GlobalVent/electronics/Pressure_sensor_daughterboard-MS5607-MS5803/Pressure_sensor_daughterboard-MS5607-MS5803.png

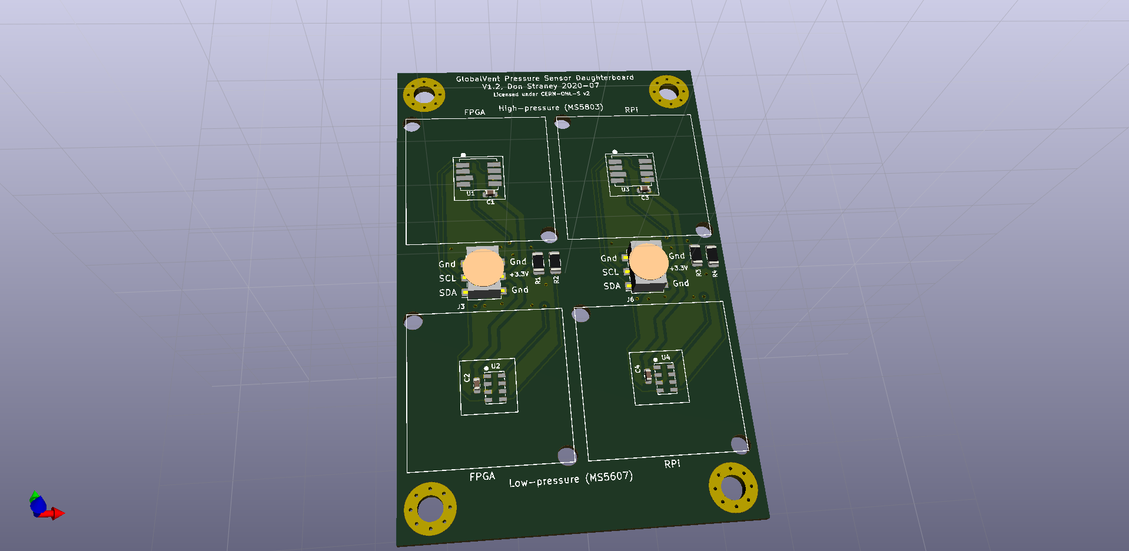
Pressure_sensor_daughterboard-MS5607-MS5803/Pressure_sensor_daughterboard-MS5607-MS5803.png
