GlobalVent/electronics/Pressure_sensor_daughterboard-MS5607-MS5803/manufacturing/README.txt

2 layers, 1.6 mm (0.062") thickness, LPI soldermask and silkscreen both sides
Outer layers 1 oz copper
ENIG plating on pads
Overall dimensions 54 x 81.25 mm (2.126" x 3.199")
Min. trace/spacing 0.18 mm (0.007")
Min. hole size 0.26 mm (0.010")

All copper layers positive
*-F_Cu.gbr: Top copper (signal)
*-B_Cu.gbr: Bottom copper (plane)
*-F_Mask.gbr: Top soldermask
*-B_Mask.gbr: Bottom soldermask
*-F_SilkS.gbr: Top silkscreen
*-B_SilkS.gbr: Bottom silkscreen
*-Edge_Cuts.gbr: Board outline
*-F_Paste.gbr: Top solder paste
*-PTH.drl: Drill file (plated holes)
*-NPTH.drl: Drill file (non-plated holes)

*-PTH-drl_map.pdf: Drill map (plated holes)
*-NPTH-drl_map.pdf: Drill map (non-plated holes)
fab.pdf: Fabrication drawing (excluding drills)

*.pos: Pick-and-place centroid position file
assy top.pdf: Assembly drawing (top side)
BOM.xls: Bill of materials
