GlobalVent/electronics/RPi_cape/0 parts, CPU options.txt

Particularly available models (>1K from multiple distributors) include...
STM32L051K8U6
STM32F100RCT6B
STM32F103RBT6
STM32F103T8U6
STM32F103T4U6A
STM32F103ZCT6
STM32F105VCT6TR
STM32L151R8T6
STM32F205ZGT6
STM32F373VCT6
STM32F401RBT6
STM32F429VIT6
