GlobalVent/electronics/RPi_cape/0 parts, display options.ods

Mfg. | Part Number | Qty. | Size | Interface
Sharp | LQ104V1DG81 | 336 Digikey | 7” 800x480 | 18-bit RGB
Matrix Orbital | MOP-TFT800480-70A-BLM-TPR | 287 | 7” 800x480 | 24-bit RGB, 40-pin almost-compatible with Newhaven
Matrix Orbital | MOP-TFT800480-70A-BLM-TPC | 496 | 7” 800x480 | 24-bit RGB, 40-pin almost-compatible with Newhaven; cap touch connector completely different
Newhaven Display Intl | NHD-7.0-800480MB-ASXN | 136 | 7” 800x480 | 24-bit RGB, 40-pin Newhaven standard
Newhaven Display Intl | NHD-7.0-800480MB-ASXN-CTP | 135 | 7” 800x480 | 24-bit RGB, 40-pin Newhaven standard
Newhaven Display Intl | NHD-7.0-800480EF-ATXL# | 220 | 7” 800x480 | 24-bit RGB, 40-pin Newhaven standard
Newhaven Display Intl | NHD-7.0-800480EF-ASXV#-CTP | 135 | 7” 800x480 | 24-bit RGB, 40-pin Newhaven standard
Newhaven Display Intl | NHD-7.0-800480EF-ATXL#-CTP | 256 | 7” 800x480 | 24-bit RGB, 40-pin Newhaven standard
Newhaven Display Intl | NHD-7.0-800480MB-ATXL-CTP | 475 | 7” 800x480 | 24-bit RGB, 40-pin Newhaven standard
4D Systems Pty Ltd | GEN4-ULCD-70DCT-CLB | 162 Digikey | 7” 800x480 | CPU w/GPIO (expected to run user code)
Newhaven Display Intl | NHD-10.1-HDMI-A-RSXV-CTU | 136 Digikey | 10.1” 1024x600 | HDMI
Newhaven Display Intl | NHD-7.0-HDMI-HR-RSXP | 134 Digikey | 7” 1024x600 | HDMI
Matrix Orbital | HTT70A-TPC-BLM-B0-H5-CH-V5 | 120 Digikey | 7” 800x480 | HDMI
Newhaven Display Intl | NHD-7.0-HDMI-N-RTXL | 134 Digikey | 7” 800x480 | HDMI
Newhaven Display Intl | NHD-7.0-1024600AF-LSXP | 162 Digikey | 7” 1024x600 | LVDS
Kyocera | T-55786GD084J-LW-AGN | 108 Digikey | 8.4” 800x600 | LVDS
Sharp | LQ084S3LG03 | 123 Digikey | 8.4” 800x600 | LVDS
Newhaven Display Intl | NHD-7.0-800480WF-CTXI# | 146 Digikey; non-stocking | 7” 800x480
