GlobalVent/electronics/RPi_cape_proto/RPi_cape_proto_bom.xls

# | Qty | References | Value | Footprint | Part Number | Manufacturer | Have?
1 | 1 | BT1 | 4x AA | Connector_Spring_Phoenix_1985195 | 9185195 | Phoenix Contact | N
2 | 6 | C8,C10,C55,C64,C66-C67 | 100nF 50V X7R | C_0603_1608Metric | 06035C104JAT2A | AVX | N
3 | 1 | C114 | 100pF 50V NP0 | C_0603_1608Metric | C0603C101J5GACTU | Kemet | Y
4 | 8 | C2,C15-C19,C62,C112 | 100uF 50V AlPoly | CP_Elec_10x10.5 | EEH-ZC1H101P | Panasonic | N
5 | 9 | C5,C29-C30,C41,C44-C45,C49,C69,C84 | 10nF 50V NP0 | C_0603_1608Metric | GRM1885C1H103JA01D | Murata | N
6 | 2 | C3,C65 | 10uF 50V X7S | C_1210_3225Metric | GCM32EC71H106KA03L | Murata | Y
7 | 4 | C40,C43,C50,C113 | 1nF 50V NP0 | C_0603_1608Metric | 06035A102JAT2A | AVX | N
8 | 11 | C7,C9,C28,C42,C48,C51-C54,C56,C68 | 1uF 16V X7R | C_0805_2012Metric | C0805C105K4RACTU | Kemet | Y
9 | 1 | D1 | STPS15H100CB | TO-252-2 | STPS15H100CB | ST | N
10 | 1 | D52 | 3.3V | D_SOD-123 | MMSZ4684T1G | ON Semiconductor | N
11 | 4 | D16,D25,D30,D35 | 30V | D_SMA | SMAJ30A-E3/61 | Vishay | N
12 | 4 | D13,D19-D20,D22 | BAS21AH | D_SOD-323 | BAS21AHT1G | ON Semiconductor | N
13 | 6 | D15,D24,D29,D34,D42-D43 | ES2B | D_SMA | ES2G-E3/52T | Vishay | N
14 | 9 | D4-D7,D9,D12,D21,D26,D31 | Orange | LED_0805_2012Metric | HSMD-C170 | Broadcom | N
15 | 1 | F3 | 140mA 60V | Fuse_1812_4532Metric | 0ZCG0014FF2C | Bel Fuse | N
16 | 4 | F10-F13 | 1A 63VDC | Fuse_1206_3216Metric | SF-1206FP100-2 | Bourns | N
17 | 1 | F2 | 50mA 15V | Fuse_0603_1608Metric | 0ZCM0005FF2G | Bel Fuse | N
18 | 8 | J3-J4,J7,J9-J12,J14 | Conn_01x02 | Connector_Spring_Phoenix_1985195 | 1985195 | Phoenix Contact | N
19 | 1 | J1 | Conn_01x04 | Connector_Spring_Phoenix_1985218 | 1985218 | Phoenix Contact | N
20 | 1 | J15 | Conn_01x06 | TE_188275-6 | 188275-6 | TE AMP | N
21 | 1 | J16 | Conn_01x06 | PinSocket_1x06_P2.54mm_Vertical |  |  | N
22 | 1 | J21 | Conn_01x06 | TE_215079-6 | 215079-6 | TE AMP | N
23 | 3 | J2,J5,J8 | Conn_02x20_Odd_Even | PinSocket_2x20_P2.54mm_Vertical | PPPC202LFBN-RC | Sullins | N
24 | 5 | Q1-Q3,Q11,Q13 | MMBT3904 | SOT-23 | MMBT3904-7-F | Diodes Inc. | Y
25 | 1 | Q12 | MMBT3906 | SOT-23 | MMBT3906,215 | Nexperia | Y
26 | 2 | R4,R178 | 0 | R_1206_3216Metric | ERJ-8GEY0R00V | Panasonic | Y
27 | 1 | R5 | 1 | R_1206_3216Metric | ERJ-8RQF1R0V | Panasonic | N
28 | 9 | R29,R56,R109-R110,R116,R119,R123,R209,R214 | 1.5K | R_1206_3216Metric | RK73H2BTTD1501F | KOA Speer | N
29 | 2 | R16,R18 | 10 | R_1206_3216Metric | RK73H2BTTD10R0F | KOA Speer | N
30 | 3 | R88-R89,R218 | 100 | R_1206_3216Metric | RK73H2BTTD1000F | KOA Speer | Y
31 | 5 | R148-R150,R217,R222 | 100K | R_1206_3216Metric | RK73H2BTTD1003F | KOA Speer | Y
32 | 28 | R1-R2,R8,R19,R53,R59,R84,R86-R87, R90-R91,R106,R113,R118,R120,R183-R184,R187-R188 R191-R192,R195-R197,R208,R213,R224-R225 | 10K | R_1206_3216Metric | RK73H2BTTD1002F | KOA Speer | Y
33 | 9 | R9,R92-R93,R198-R201,R216,R223 | 1K | R_1206_3216Metric | RK73H2BTTD1001F | KOA Speer | Y
34 | 3 | R219-R220,R236 | 1M | R_1206_3216Metric | RK73H2BTTD1004F | KOA Speer | N
35 | 5 | R111,R124,R190,R210,R215 | 2.4K | R_1206_3216Metric | RK73H2BTTD2401F | KOA Speer | N
36 | 2 | R20,R151 | 24.9K | R_1206_3216Metric | RK73H2BTTD2492F | KOA Speer | N
37 | 7 | R3,R6,R14-R15,R17,R193-R194 | 3.3K | R_1206_3216Metric | RK73H2BTTD3301F | KOA Speer | Y
38 | 14 | TP1,TP3-TP4,TP6-TP10,TP13,TP15,TP20,TP39-TP41 | TestPoint_Flag | TestPoint_Keystone_5019_Minature | 5019 | Keystone | Y
39 | 4 | U8,U18,U20,U22 | 74LVC1G08 | SOT-23-5 | SN74LVC1G08DBVR | Texas Instruments | N
40 | 1 | U4 | AD8552A | SOIC-8_3.9x4.9mm_P1.27mm | AD8552ARZ-REEL | Analog Devices | N
41 | 2 | U2-U3 | ADC128D818 | TSSOP-16_4.4x5mm_P0.65mm | ADC128D818CIMTX/NOPB | Texas Instruments | N
42 | 1 | U28 | LM4871M | SOIC-8_3.9x4.9mm_P1.27mm | LM4871MX/NOPB | Texas Instruments | Y
43 | 3 | U36-U38 | LMC7101B | SOT-23-5 | LMC7101BIM5/NOPB | Texas Instruments | N
44 | 4 | U9,U19,U21,U23 | TPS1H100B | TSSOP-14-1EP_4.4x5mm_P0.65mm | TPS1H100BQPWPRQ1 | Texas Instruments | N
