GlobalVent/electronics/Pressure_sensor_daughterboard-MS5607-MS5803/manufacturing/BOM.xls

Line # | Quantity Per PCB | References | Value | Footprint | Manufacturer | Part Number | DNI
1 | 4 | C1-C4 | 100nF 50V X7R | C_0603_1608Metric | AVX | 06035C104JAT2A
2 | 2 | J3,J6 | Conn_02x03_Odd_Even | Samtec_HLE-103-02-xxx-DV-BE_2x03_P2.54mm_Horizontal | Samtec | HLE-103-02-L-DV-BE-K-TR
3 | 4 | R1-R4 | 0 | R_1206_3216Metric | Panasonic | ERJ-8GEY0R00V
4 | 2 | U2,U4 | MS5607-02BA03 | TE_MS5607-02BA03 | TE Connectivity | MS560702BA03-50
5 | 2 | U1,U3 | MS5803-05BA | TE_MS5803-05BA | TE Connectivity | MS5803-05BA01-00
