GlobalVent/electronics/RPi_cape/0 pinouts for software.ods

Sheet: Raspberry Pi
Pin # (Header) | Pin Name | Net Name | Type | Description
3 | I2C_SDA | RPi_SDA | Bidir | I2C bus to ADC and digital pressure sensors
5 | I2C_SCL | RPi_SCL | Bidir
7 | GPIO4 | GPIO4 | Input | Active-low interrupt signal from ADC
8 | GPIO14 | Comms1 | Bidir | General-purpose bidirectional comms to CPLD
10 | GPIO15 | Comms2 | Bidir | General-purpose bidirectional comms to CPLD
11 | GPIO17 | RPi_Alarm_Spkr | Output | Output to audio amp driving alarm speaker; can generate frequencies on this pin to create square wave audio. Output is AC-coupled; can idle high or low.
12 | GPIO18 | RPi_PWM1 | Output | Drives 159 Hz LPF + testpoint for development/debug analog output
13
15
16 | GPIO23 | Comms3 | Bidir | General-purpose bidirectional comms to CPLD
18 | GPIO24 | Comms4 | Bidir | General-purpose bidirectional comms to CPLD
19
21
22 | GPIO25 | Comms5 | Bidir | General-purpose bidirectional comms to CPLD
23 | GPIO11 | Comms6 | Bidir | General-purpose bidirectional comms to CPLD
24
26
27
28
29
31
32 | GPIO12 | RPi_valve4 | Output | Active-high valve power enable to output #4 (intended for expiratory valve: SolV3 in pneumatics BOM)
33 | GPIO13 | RPi_PWM2 | Output | Drives 159 Hz LPF + testpoint for development/debug analog output
35 | GPIO19 | RPi_PWM3 | Output | Drives 159 Hz LPF + testpoint for development/debug analog output
36 | GPIO16 | RPi_valve3 | Output | Active-high valve power enable to output #3
37 | GPIO26 | RPi_PWM4 | Output | Drives 159 Hz LPF + testpoint for development/debug analog output
38 | GPIO20 | RPi_valve2 | Output | Active-high valve power enable to output #2
40 | GPIO21 | RPi_valve1 | Output | Active-high valve power enable to output #1

Sheet: FPGA
Net Name | Pin # (E144 package) | Type | Description
~Bat_On | 106 | Input | High when CPLD and alarms are powered from 24V input power, low when powered from alarm backup battery
Low_Bat | 102 | Input | High when alarm backup battery is below “low battery” threshold voltage
~+5VA_On | 101 | Input | Low when +5VA rail (supply for O2, pressure sensor analog inputs) is above ~3.5-4.2V “on” threshold
RPi_En | 62 | Output | Active high enable signal to Raspberry Pi’s 5V supply, set low to power down Raspberry Pi – only has an effect when using onboard (as opposed to external) 5V supplies
CPLD_Clk | 27 (CLK0P) | Input | 100 kHz clock
Alarm_Spkr | 111 | Output | Drives audio amp for alarm speaker output; output a frequency to create square-wave audio tone; AC-coupled, can idle low or high
Valve1 | 78 | Output | Active-high valve power enable to output #1
Valve2 | 77 | Output | Active-high valve power enable to output #2
Valve3 | 76 | Output | Active-high valve power enable to output #3
Valve4 | 75 | Output | Active-high valve power enable to output #4 (intended for expiratory valve: SolV3 in pneumatics BOM)
RPi_valve1 | 47 | Input | Raspberry Pi’s active-high valve command to output #1
RPi_valve2 | 46 | Input | Raspberry Pi’s active-high valve command to output #2
RPi_valve3 | 45 | Input | Raspberry Pi’s active-high valve command to output #3
RPi_valve4 | 44 | Input | Raspberry Pi’s active-high valve command to output #4
~Valve1_Fault | 119 | Input | Active-low fault input (over-current, shorted or open coil) from valve output #1 – only used if alternate TPS1H100A valve driver populated
~Valve2_Fault | 120 | Input | Active-low fault input (over-current, shorted or open coil) from valve output #1 – only used if alternate TPS1H100A valve driver populated
~Valve3_Fault | 123 | Input | Active-low fault input (over-current, shorted or open coil) from valve output #1 – only used if alternate TPS1H100A valve driver populated
~Valve4_Fault | 124 | Input (Schmitt trigger) | Default configuration: output #4 (expiration valve, SolV3) motion detect – low when valve current dips Alternate TPS1H100A valve driver populated: Active-low fault input (over-current, shorted or open coil) from valve output #4
Comms1 | 56 | Either | General-purpose bidirectional comms to Raspberry Pi
Comms2 | 57 | Either | General-purpose bidirectional comms to Raspberry Pi
Comms3 | 58 | Either | General-purpose bidirectional comms to Raspberry Pi
Comms4 | 59 | Either | General-purpose bidirectional comms to Raspberry Pi
Comms5 | 60 | Either | General-purpose bidirectional comms to Raspberry Pi
Comms6 | 61 | Either | General-purpose bidirectional comms to Raspberry Pi
SDA | 132 | Bidir | I2C to ADC and digital pressure sensors
SCL | 131 | Bidir | I2C to ADC and digital pressure sensors: set high to activate SCL pull-down
~ADC_Int | 130 | Input | Active-low interrupt from ADC
Pressure1_Lim_L_Alarm | 7 | Input | High when analog pressure sensor 1 value is below a hard-wired low limit
Pressure1_Lim_H_Alarm | 6 | Input | High when analog pressure sensor 1 value is above a hard-wired high limit
Pressure2_Lim_L_Alarm | 10 | Input | High when analog pressure sensor 2 value is below a hard-wired low limit
Pressure2_Lim_H_Alarm | 8 | Input | High when analog pressure sensor 2 value is above a hard-wired high limit
O2_Lim_L_Alarm | 12 | Input | High when O2 sensor value is below a hard-wired low limit
O2_Lim_H_Alarm | 11 | Input | High when O2 sensor value is above a hard-wired high limit
Enc_A | 87 | Input (Schmitt trigger) | Rotary encoder’s quadrature input A
Enc_B | 86 | Input (Schmitt trigger) | Rotary encoder’s quadrature input B
Enc_Sw | 79 | Input (Schmitt trigger) | Rotary encoder’s active-high switch input
Extra1 | 100 | Output | Drives LED and testpoint for development/debug
Extra2 | 99 | Output | Drives LED and testpoint for development/debug
Extra3 | 98 | Output | Drives LED and testpoint for development/debug
Extra4 | 90 | Output | Drives LED and testpoint for development/debug
Extra5 | 89 | Output | Drives LED and testpoint for development/debug
Extra6 | 88 | Output | Drives LED and testpoint for development/debug

Sheet: I2C
ADC: TI ADC128D818
Raspberry Pi | CPLD
Address: 0011101 (1Dh)
All inputs single-ended, need to use 2.56V internal reference
Channel 0: analog pressure sensor 1 (10V sensor = 2.537V ADC) | (same)
Channel 1: analog pressure sensor 2 (10V sensor = 2.537V ADC) | (same)
Channel 2: O2 sensor (13 mV sensor = 1.313V ADC) | (same)
 | Channel 3: Valve #1 current (1A = 3V) in default config
 | Channel 4: Valve #2 current (1A = 3V) in default config
 | Channel 5: Valve #3 current (1A = 3V) in default config
 | Channel 6: Valve #4 current (1A = 3V) in default config
 | Channel 7: +24V monitor (24V power = 2.182V ADC)
Pressure sensor: TE MS5803-05BA
Address: 1110111 (77h)
Pressure sensor: Bosch BMP388
Address: 1110110 (76h)
