GlobalVent/electronics/RPi_cape/0 power.xls

Rail |  |  | Current (A) | Description | Total power (W):
+24V |  |  | 2.088 |  | 50.11
2x low-power valves |  |  | 0.583
2x high-power valves |  |  | 0.833
4x valve drivers |  |  | 0.020 | TPS1H100B
+24VA |  |  | 0.02
+5V supply |  |  | 0.032 | LMZ14203 @ 86% eff. for 0.1A out
+5VD supply |  |  | 0.599 | LMZ14203 @ 88% eff. for 2.5A out
 | +24VA |  | 0.02
 | Pressure sensors (0-10V) |  | 0.02 | PXM309-10V
+5V |  |  | 0.131
+5VA |  |  | 0.015
BATT+ |  |  | 0.116
 | +5VA |  | 0.015
 | 2.5V reference bias |  | 0.005
 | Pressure sensor (0-10V) buffers |  | 0.005 | LMC7101
 | O2 sensor amplifiers |  | 0.002 | AD8552
 | Analog sensor limit comparators |  | 0.003 | LM2903
 | BATT+ |  | 0.116
 | Audio amp, quiescent |  | 0.01 | LM4871M
 | Audio amp at reasonable volume |  | 0.04 | Tested with 8-ohm speaker and 260 Hz 0-5V square wave input from alarm
 | 2.5V reference bias |  | 0.003
 | Low-battery comparator |  | 0.001 | LM2903
 | +3.3V regulator |  | 0.022
 | +1.8V regulator |  | 0.040
 |  | +3.3V | 0.022
 |  | I2C pull-ups | 0.002
 |  | ADC | 0.002 | ADC128D818
 |  | Logic gates (safety-combining) | 0.001
 |  | Valve driver pull-downs | 0.004 | Not active during backup-battery-power mode
 |  | Valve driver LEDs | 0.004 | Not active during backup-battery-power mode
 |  | CPLD debug LEDs | 0.006
 |  | CPLD clock | 0.001 | MIC1557
 |  | Encoder pull-ups | 0.002
 |  | Pressure sensors, digital | 0.002 | MS5803-05BA, BMP388
 |  | +1.8V | 0.040
 |  | FPGA | 0.04 | Max V current draw during configuration
+5VD |  |  | 2.532
Raspberry Pi |  |  | 2 | Estimate from official guidelines (2.5A recommended for peripherals ≤ 0.5A)
Display |  |  | 0.5 | Estimate from official guidelines
Encoder |  |  | 0.03 | Grayhill
ADC |  |  | 0.002 | ADC128D818
