GlobalVent/electronics/RPi_cape/0 parts, CPLD-FPGA options.ods

Mfg | Part Number | Cells | Availability
Intel | EP3C5E144C8N | 5136 | 1.6k
Intel | EP3C10E144C8N | 10320 | 2k
Intel | EP3C16Q240C8N | 15408 | 1.9k
Intel | EP4CE6E22C8N | 6272 | 3.3k
Lattice | ICE5LP2K-SG48ITR | 2048 | 3.4k
Lattice | ICE40UP5K-SG48I | 5280 | 6k
Lattice | LFXP2-5E-5TN144I | 5000 | 1.1k
Intel | 10M02SCE144I7G | 2000 | 2.6k | Too small?
Intel | 10M02SCE144C8G | 2000 | 2.9k | Too small?
Intel | 10M04SCE144C8G | 4000 | 2.5k
Intel | 10M08SAE144I7G | 8000 | 900
Intel | 10M08SAE144C8G | 8000 | 2.2k
Intel | 10M25SAE144C8G | 25000 | 942
Microsemi | A3P250-VQG100 | 250k gates | 6.8k, extra 400 for I version
Xilinx | XC6SLX9-2TQG144C | 9152 | 3.2k Digikey
