GlobalVent/electronics/RPi_cape/0 protection and bringup.ods

Sheet: Failure mode tests
Failure mode | Mitigation | Expected result | Testing
Analog inputs
ESD | Series resistor for current-limiting, capacitor for charge absorbing | Reading shift for unknown time, no damage to op-amps/ADC/others X?? measured effect max. on control loop (?) | Apply ESD (???) while... probing ADC input or getting continuous ADC readings, for bad-reading meas. probing voltage across op-amp and ADC inputs, for protection-diode current meas.
EMI | Series resistor and capacitor (LPF) | No significant reading change, no damage to op-amps/ADC/others | Apply EMI (???) while... probing ADC input or getting continuous ADC readings, for bad-reading meas. probing voltage across op-amp and ADC inputs, for protection-diode current meas.
Sustained over-voltage (short to external) | Series resistor for current-limiting | Bad reading, but no damage to op-amps/ADC/others Alarm from CPLD
Valve-induced noise | Good design, filtering | No significant reading change on valve switching | Switch all 4 valves at once while probing each ADC input
Valve drivers
CS pin internal short to +24V | 10K series resistor to ADC, valve-movement-detect circuit | No damage to ADC or others; current-gain resistor may fail open Alarm from CPLD | Add short from +24V to valve driver CS pin while probing ADC input
Driver fails open | Current sense output from valve driver, CPLD checks current after closing valve | Alarm from CPLD if current sense output is behaving correctly, stuck high, or stuck low Failure to alarm if current sense is stuck at expected value | Disconnect valve
Driver fails closed | Current sense output from valve driver, CPLD checks current after opening valve | Alarm from CPLD if current sense output is behaving correctly, stuck high, or stuck low Failure to alarm if current sense is stuck at expected value | Cut trace, short valve driver ctrl input high
Valves
Open coil | Current sense or fault output from valve driver | Alarm from CPLD | Disconnect one or multiple (?) valves
Shorted coil | Current sense or fault output from valve driver Valve driver internal protection; PCB fuse for backup | No damage to valve driver, power supply, or others No loss of system power Alarm from CPLD | Add short across one or multiple (?) valves while… probing valve driver current and +24V rail
Stuck fully/mostly open (expiration valve) | Valve-motion-detect circuit | Alarm from CPLD | ??? while probing valve-motion-detect output
Stuck fully/mostly closed (expiration valve) | Valve-motion-detect circuit | Alarm from CPLD | ??? while probing valve-motion-detect output
Stuck fully/mostly open (all other valves) | N/A (system-level)
Stuck fully/mostly closed (all other valves) | N/A (system-level)
I2C bus (all sensor readings)
ESD/EMI-induced noise | More of a software/firmware issue: (comparatively) low bus speeds, software tolerance for occasional comms errors | Temporary bad reading but no damage | ??? while probing both I2C lines, acquiring sensor readings (make sure noise happens during readout)
Valve-induced noise | Good design, filtering | No deviation from logic thresholds while valves switching | Switch all 4 valves at once while probing both I2C lines
Peripheral holds line low/high | More of a software/firmware issue: error checking, redundant buses | Alarm from CPLD or Pi, possible fail-over to redundant bus | Short one/both lines on either/both I2C bus low Short one//both lines on either/both I2C bus high
Raspberry Pi
Software hang | More of a software/firmware issue: watchdog timer from CPLD
Incorrect state changes | More of a software/firmware issue: valid state-transition checking, safety-combining with CPLD on valve outputs
Excessive current draw / fail short on 5V input | Separate +5VD supply, current-limited temperature-limited +5VD supply | +24V/5V may or may not temporarily go out of regulation, alarm from CPLD, no fire risk from 5V regulator Possible power-ORing diode overheating under sustained overload | Short +5VD power rail while observing component temperatures, probing +24V and +5V, measuring +24V input current
Outputs fail open / power loss | Pull-down resistors on valve outputs |  | Disable +5VD regulator (disconnect enable input resistor to CPLD, short enable to gnd)
Outputs stuck high | Valid-state-transition checking from CPLD | Alarm from CPLD | Pi script to hold outputs high
Outputs stuck low | Safety-combining with CPLD on valve outputs | Valves remain closed | Pi script to hold outputs low
GPIO (inputs or outputs) fail shorted to 5V | Series resistors on CPLD/Raspberry Pi comms lines | No effect unless other failures (Pi behaves abnormally, etc.)
Power
Valve-induced sag | Good design, filtering | No significant sag in 24V power or downstream (+5V, +5VD) | Switch all 4 valves at once while probing +24V, +24VA, +5V, +5VD
24V input temporary surge | Bulk capacitance and TVS diode (TVS not used by default) | +24V stays within capacitor, 5V DC-DC input voltage ratings +24VA stays within capacitor, sensor input voltage ratings +5V, +5VD remain in regulation | ??? while probing +24V, +24VA, +5V, +5VD
24V input sustained over-voltage | TVS diode and input fuse (neither populated by default) | Failure, possible fire risk If populated: Fuse blows, but no fire risk (all components stay within ratings) | Apply over-voltage from 100W+ bench supply while probing +24V, +24VA, +5V, +5VD
24V temporary sag | Bulk capacitance on all rails | All voltages stay in regulation for ??? ms drop-out | Use relay to disconnect input for ??? ms while probing +24V, +24VA, +5V, +5VD
24V sustained under-voltage (enough to run DC-DCs but potential valve problems) | Voltage sensing on CPLD ADC, current sense output from valve driver (< expected on-state current), valve-motion-detect circuit | Alarm from CPLD | Apply low continuous voltage(12V???) from bench supply
24V outage | Power-down alarm circuit on backup battery | Alarm from power-down alarm circuit | Disconnect 24V supply
5V supply failure (+5V) | Diode-ORed alarm/CPLD power from backup battery, CPLD sensing of +5VA through ADC | Alarm from CPLD | Disable +5V regulator (short enable input to gnd)
5V supply failure (+5VD) | (Same as Raspberry Pi outputs fail open / power loss)
3.3V supply failure (+3.3V) | Power-down alarm circuit on backup battery | Alarm from power-down alarm circuit | Disable 3.3V regulator (cut trace and bring enable line low)
1.8V supply failure (+1.8V) | Power-down alarm circuit on backup battery | Alarm from power-down alarm circuit | Disable 1.8V regulator (cut trace and bring enable line low)
Short on +24V, +5V, +3.3V, +1.8V | Power-down alarm circuit on backup battery, current-limited power supplies, temperature-limited 5V supply | Power fails on multiple rails up to or including 24V input, but alarm sounds from power-down alarm circuit, no fire risk Possible power-ORing diode overheating under sustained overload | Short each power rail while observing component temperatures, probing +5V and +24V, measuring +24V input current
Short / excessive current draw on +5VD | (Same as Raspberry Pi excessive current draw / failt short on 5V)
Short / excessive current draw on +5VA | Resettable fuse, +5VA monitor (~+5VA_On signal) | Alarm from CPLD | Short +5VA while observing component temperatures, probing +5V and +24V, measuring +24V input current
Short / excessive current draw from +24VA on a (0-10V) pressure sensor | (Same as Pressure sensor fails short on 24V power input)
NOTE: items in bold have unresolved questions, lines marked in green involve firmware/software issues, lines in gray are duplicates of issues in other categories

Sheet: Bring-up tests
Power rails | DC voltage | Noise (XXX Mhz BW) | Current draw (mA) | Conditions
+24V
+24VA
+5V
+5VA
+3.3V
+1.8V
+2.5V
+BATT
Power rail sequencing | ADC-supply waveform | +5VA waveform | Op-amp Vout waveform | ADC Vin waveform | Op-amp supply before ADC supply? | Max. ADC ESD-diode current?
+3.3V ADC vs. +5VA op-amp
+3.3V_RPi ADC vs. +5VA op-amp
Pressure sensor 1 input | Input | CPLD op-amp in | Pi op-amp in | CPLD ADC in | Pi ADC in | CPLD ADC reading | Pi ADC reading
Offset: short inputs, check voltages along signal chain and ADC reading
Gain: apply full-scale input, check voltages along signal chain and ADC reading
Pressure sensor 2 input
Offset: short inputs, check voltages along signal chain and ADC reading
Gain: apply full-scale input, check voltages along signal chain and ADC reading
O2 sensor input
Offset: short inputs, check voltages along signal chain and ADC reading
Gain: apply full-scale input, check voltages along signal chain and ADC reading
Valve driver basic functional: disconnect Pi and short its outputs to +3.3V, selectively short +3.3V to CPLD valve outputs | LED on? | Output voltage waveform | CS pin waveform
1
2
3
4
Valve-motion circuit | CS pin waveform | Valve motion detect waveform
Normal turn-on: same as valve driver basic functional
Normal turn-off: same as valve driver basic functional
Power-down alarm | +3.3V threshold | Alarm tone freq. | Alarm repeat freq. | +BATT current waveform
Remove +3.3V power, wait for alarm to sound
Power-down detect circuits Apply triangle wave to each rail in turn, check at which voltages the output changes state w/no glitching | Turn-off threshold | Turn-on threshold | Glitches?
+3.3V (power-down alarm)
+1.8V (power-down alarm)
+5VA (power-down alarm)
+5V (+BATT diode-OR circuit)
Audio amplifier Apply square wave to each input in turn | Tone sounds? | +BATT current draw
Raspberry Pi input
CPLD input
