GlobalVent/electronics/RPi_cape/0 CHANGELOG.txt

1.0 to 1.1:
	* Added R177 to allow low-battery alarm to drive both a CPLD input and an external LED
	* Moved one Raspberry Pi PWM analog output to GPIO18 to take advantage of hardware PWM
	* Fixed floating shutdown pin on audio amp U28
	* Added bulk capacitor C112 on +5V input
	
1.1 to 1.2:
	* Added R185, R186 to allow powering CPLD from alarm power for better power-down alarm sound flexibility
	* Changed power-down alarm monitoring from +5VD to +3.3V, and put +5VA and +24VA monitoring as DNP by default, to match the CPLD's ability to run off backup battery and monitor +5VA/+24VA
	* Moved from 3x AA (4.5V) to 4x AA (6V) alarm battery for better audio voltage, and added PNP diode-ORing circuit (Q12 etc.) to accomodate higher voltage, changed low-battery threshold to 5V
	* Added pull-down resistors to sensor op-amp outputs to help extend low-end output range
	* Changed 1nF, 10nF, 100nF caps to 0603-size for better fit of CPLD decoupling caps
	* Added additional bulk cap C19 to audio amp's supply just in case of alarm-induced supply fluctuations
	* Decreased CPLD's I2C pull-up values to deal with anticipated PCB capacitance etc.
	* Removed additional dual-op-amp footprint option on analog inputs, due to high availability of single op-amps
	* Adjusted O2 sensor input clamping to reduce errors from diode leakage current (changed from zener to low-leakage clamps to rails)
	* Changed O2 sensor op-amp to different lower-offset part to reduce total error from +/- 4.2% FS to +/- 1.7% FS
	* Fixed missing power section for U17
	* Added rotary encoder input
	* Consolidated +5VA fuse options
	
1.2 to 1.3:
	* Moved rotary encoder inputs to CPLD
	* Removed separate decoupling caps for smaller CPLD footprint due to routing constraints
	* Added pull-downs on CPLD inputs for each valve driver (R198 etc.)
	
1.3 to 1.4:
	* Added two digital pressure sensors each, on Raspberry Pi and CPLD I2C busses
	* Added gnd plane on bottom layer for heatsinking 5V regulators
	
1.4 to 1.5:
	* Added strain-relief slots and barb mounting dimensions for digital pressure sensors
	* Changed valve drivers from discrete power MOSFETs to "smart" industrial/automotive driver ICs for the current monitoring, including valve-movement monitor for #4
	* Connected RPi_Valve* signals to larger CPLD footprint, changed Raspberry Pi pin assignment as a result to ease PCB routing
	* Updated footprints, page layout to create readable assembly drawing
	* Added current-measurement testpoints for CPLD power from BATT+
	* Changed power diodes in power-down-alarm circuit to small-signal parts for more compact layout
	
1.5 to 1.6:
	* Switched CPLD_ADC7 to +24V monitoring (from +5V monitoring), and added CPLD ~Bat_On digital input(s) to know when it's running from backup battery, to cover low-input-voltage edge cases
	* Added series 1K resistors (R226-231) on CPLD<->RPi Comms1-6 lines, to protect CPLD in case of overvoltage from RPi failure
	* Added optional input TVS D23 to handle sustained over-voltage or large surges
	
1.6 to 1.7:
	* Separated +1.8V and +5VA monitoring and added +3.3V output for +5VA on ~5VA_On signal to CPLD, to cover an extra failure mode
	
1.7 to 1.8:
	* Toughened under-voltage detect circuits by adding hysteresis to +5V detect for +BATT diode-OR (R236), filtering to power-down alarm detect input (C85)
	* Added connector options (J15, J21) for Grayhill C14-series rotary encoder with cable
	* Changed R190 from 3K to 2.4K to increase overhead on base current required for saturation, and consolidate BOM
	* Added 3 solderable testpoints for expanding CPLD pin options (TP44-46), adjusted some CPLD pin assignments to allow physical routing to pins
	* Fixed valve motion detector by changing comparator's hysteresis to AC-only, changing NPN's series resistor to 1K (allows low-enough DC level to count as logic low), and adding optional filtering cap C115 to offset divider
	
1.8 to 1.9:
	* Changed 24V LED resistors (R20, R22) to 24.9K to consolidate BOM
	* Adjusted audio amp volume and filtering according to breadboard experiments
	* Moved bottom-end mounting holes and encoder connectors to avoid interfering mechanically with Raspberry Pi
	* Replaced under-sized power-ORing diodes with better Schottky option, added heatsinking with copper planes
	* Improved LMZ14203 heatsinking by removing thermal reliefs, re-arranging input-current-measurement testpoints to increase top-layer copper area
	
1.9 to 1.10:
	* Updated name on schematic, PCB silkscreen
	* Added 3 mounting holes on inside area of board for better mechanical robustness
	* Removed extra unused pressure sensor barb packages from library
	* Fixed Phoenix spring connector footprints, and added 3D models from Phoenix website
	* Added 3D models to TE encoder connector footprints, QFP-100 for CPLD, and 5019 testpoint
	* Changed DIAG_EN pin connection from valve drivers from +24V (too high) to +3.3V
	* Added CERN licensing terms
	
1.10 to 1.11:
	* Swapped Max V CPLD for Max 10 FPGA
	* Removed +1.8V regulator and monitoring (in power-down alarm) because Max 10 FPGA has internal regulator
	* Changed FPGA's valve-enable pull-downs from 1K to 10K because Max 10 floats the outputs during power-up/programming (instead of Max V's internal pull-ups)
	* Changed low-pressure sensor from BMP388 to MS5607 for more manufacturable footprint / high availability, and moved all digital pressure sensors to daughterboard for repairability
	* Changed single op-amps in analog pressure sensor inputs / valve motion detect circuits to TLV6001 for better bias current, correct footprint
	* Removed excessive DNP components in analog pressure sensor inputs to ease routing with new op-amps
	* Added double-inverted hysteresis circuit to valve motion detect that won't drive U38's '+' input above the rail and cause latchup
	* Added optional pull-down resistors to valve-motiion-detect op-amps to allow output voltages to swing to zero
	* Added optional filter caps to ADC sensor inputs
	* Added pull-down to O2 sensor input for testing with sensor unplugged
	* Increased ADC input resistors (in analog sensor inputs) from 1K to 3.3K to avoid "lifting" +3.3V rail voltage in case of fault
	* Increased hole sizes to 3.7 mm for fitting #6 screws, to match some threaded vibration-damping bumpers from Joost
	* Fixed F.Fab-layer component reference text in custom footprints
