GlobalVent/electronics/RPi_cape_simulator/RPi_cape_simulator.pdf

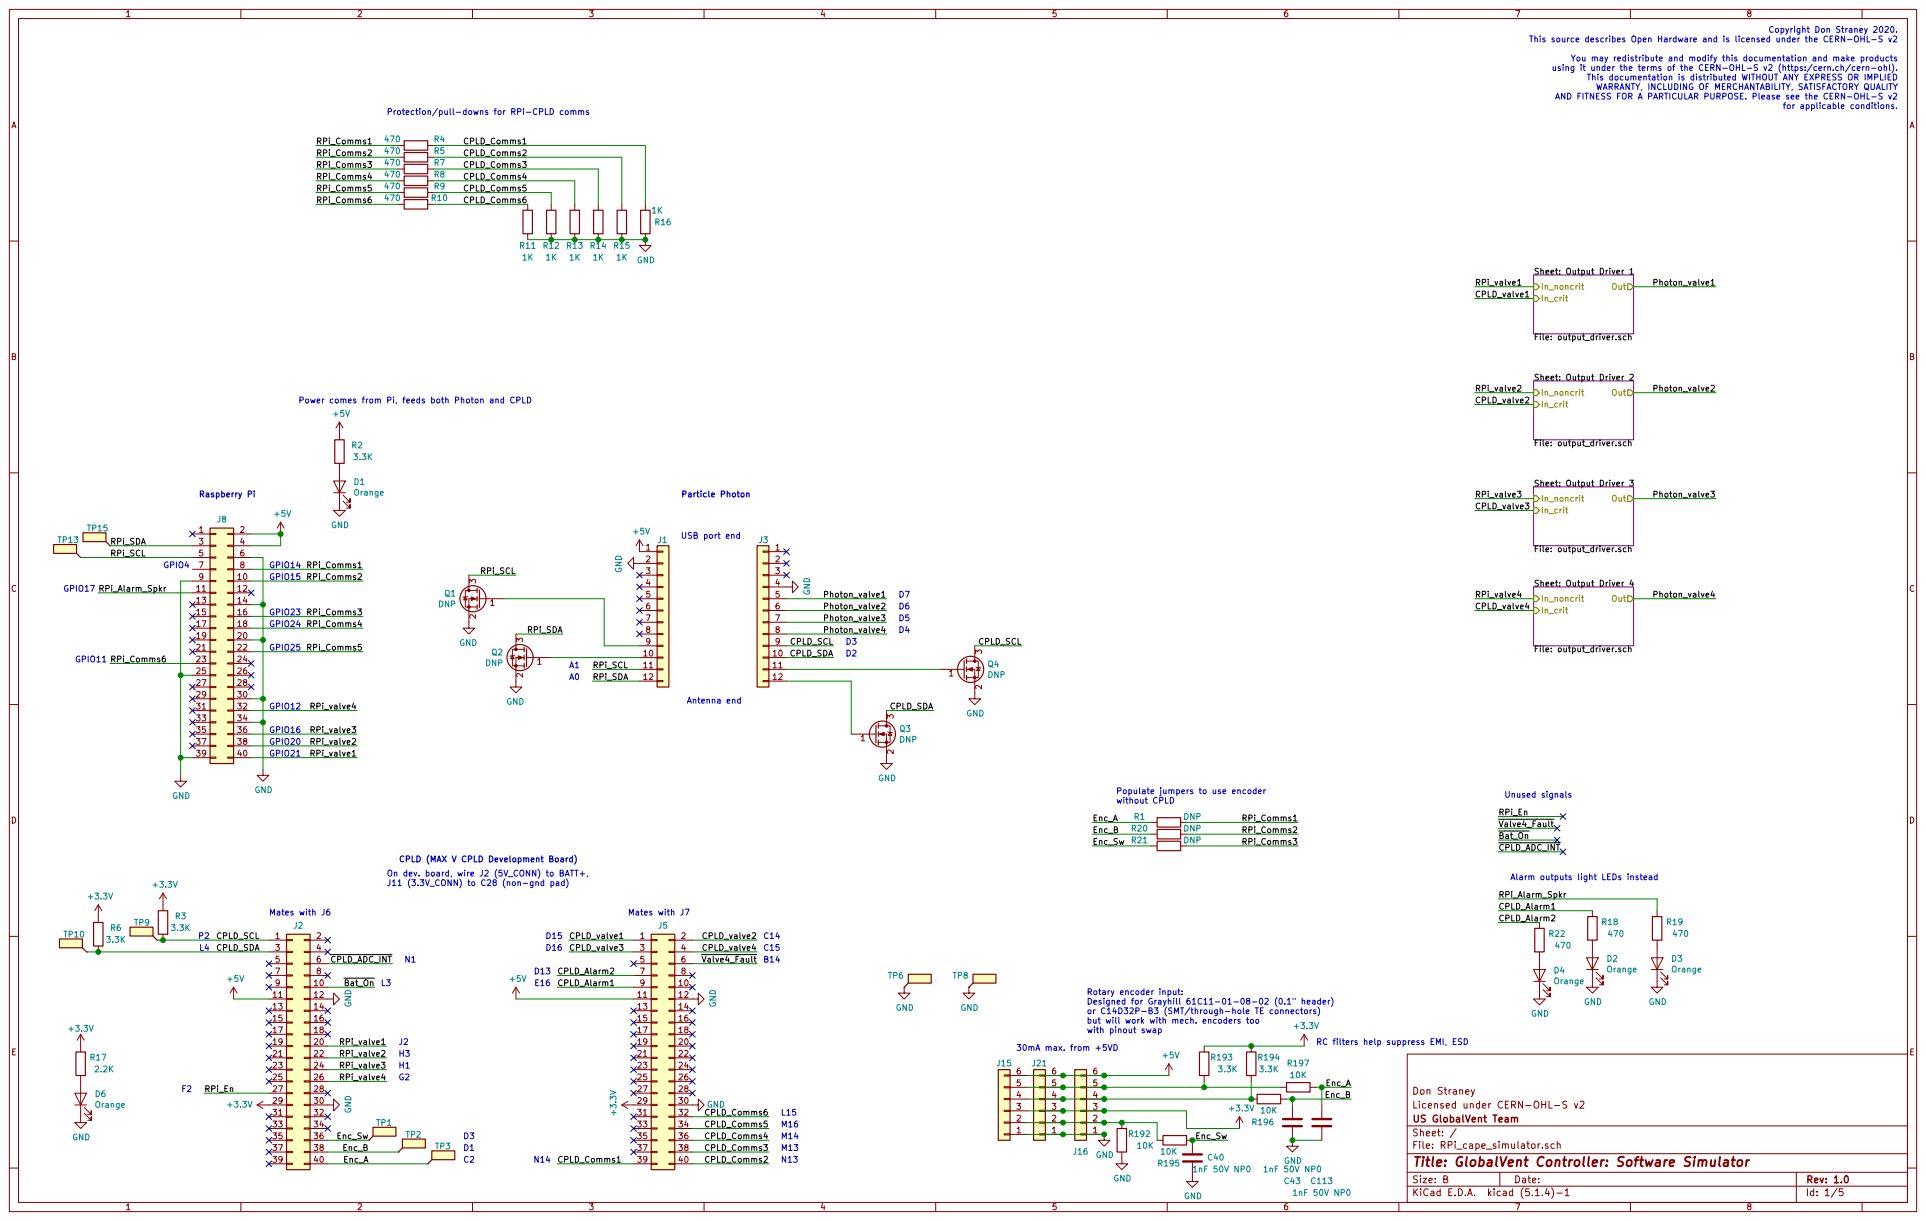
[picture p2: page 1]

This source describes Open Hardware and is licensed under the CERN-OHL-S v2

You may redistribute and modify this documentation and make products
using it under the terms of the CERN-OHL-S v2 (https:/cern.ch/cern-ohl). This documentation is distributed WITHOUT ANY EXPRESS OR IMPLIED WARRANTY, INCLUDING OF MERCHANTABILITY, SATISFACTORY QUALITY

AND FITNESS FOR A PARTICULAR PURPOSE. Please see the CERN-OHL-S v2

Protection/pull-downs for RPi-CPLD comms

Alarm outputs light LEDs instead

Designed for Grayhill 61C11-01-08-02 (0.1" header)

Licensed under CERN-OHL-S v2 Don Straney

File: RPi_cape_simulator.sch Sheet: / US GlobalVent Team

Id: 1/5 Title: GlobalVent Controller: Software Simulator

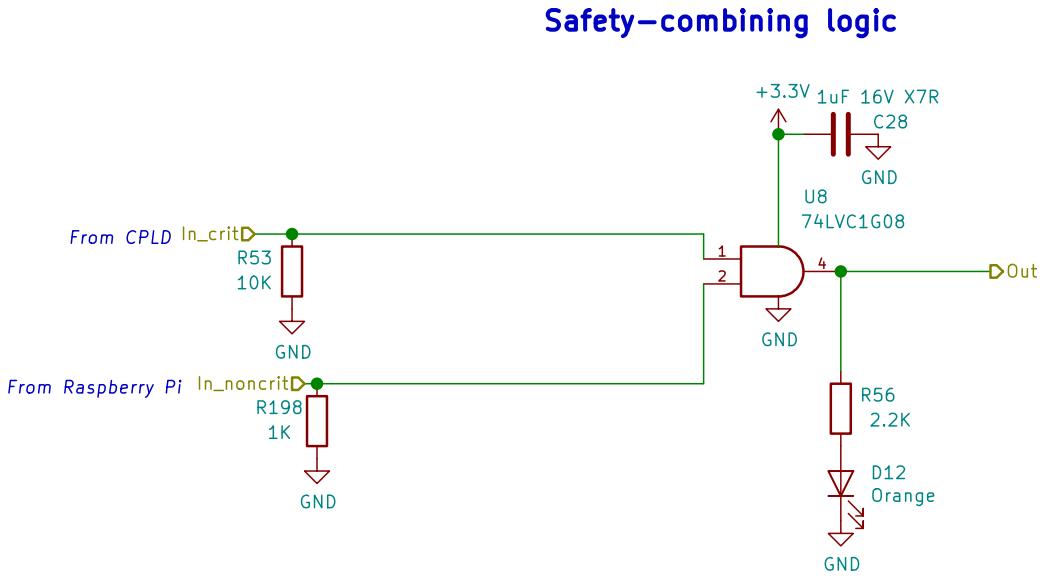
[picture p3: page 2]

Licensed under CERN-OHL-S v2 Don Straney

Sheet: /Output Driver 1/ US GlobalVent Team

File: output_driver.sch
Id: 2/5 Title: GlobalVent Stand-Alone Controller

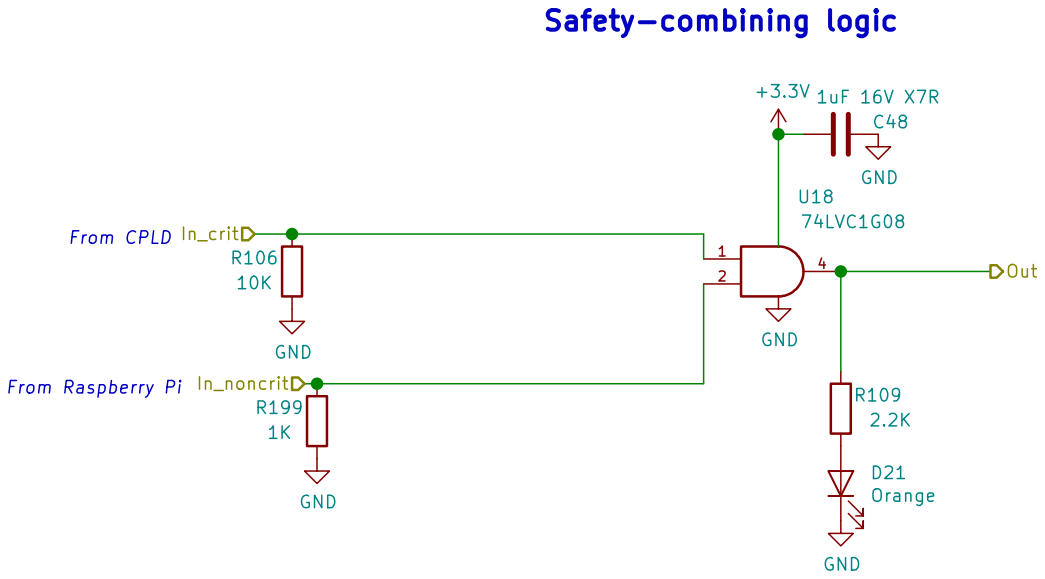
[picture p4: page 3]

Licensed under CERN-OHL-S v2 Don Straney

Sheet: /Output Driver 2/ US GlobalVent Team

File: output_driver.sch
Id: 3/5 Title: GlobalVent Stand-Alone Controller

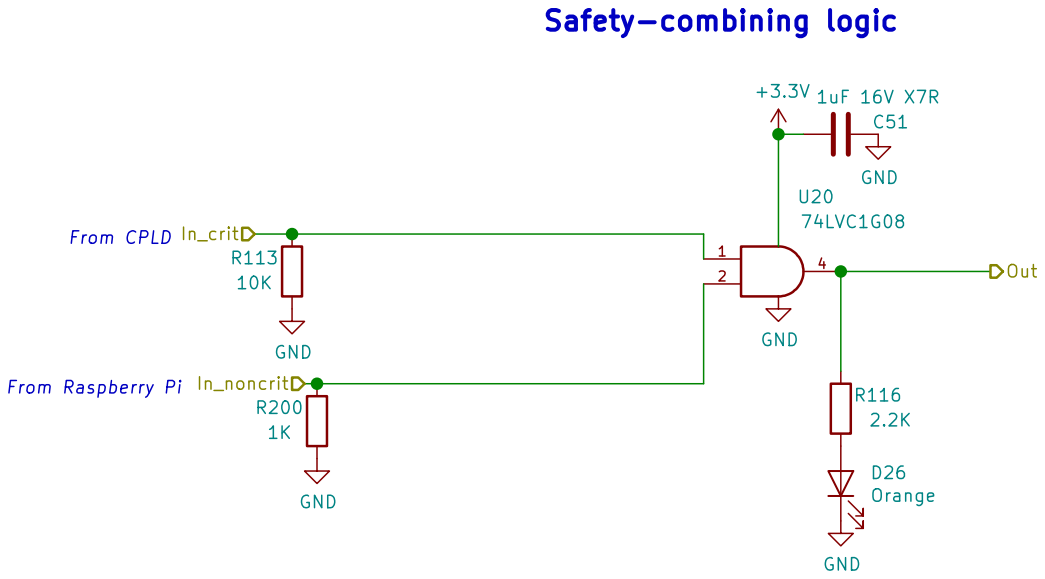
[picture p5: page 4]

Licensed under CERN-OHL-S v2 Don Straney

Sheet: /Output Driver 3/ US GlobalVent Team

File: output_driver.sch
Id: 4/5 Title: GlobalVent Stand-Alone Controller

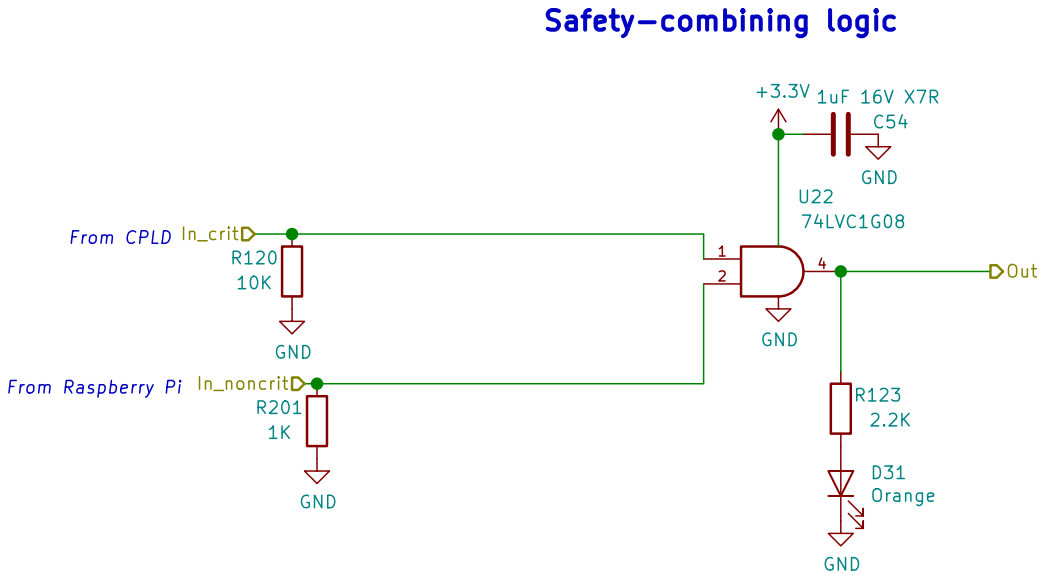
[picture p6: page 5]

Licensed under CERN-OHL-S v2 Don Straney

Sheet: /Output Driver 4/ US GlobalVent Team

File: output_driver.sch
Id: 5/5 Title: GlobalVent Stand-Alone Controller
