GlobalVent/electronics/Pressure_sensor_daughterboard-MS5607-MS5803/Pressure_sensor_daughterboard-MS5607-MS5803 schematic.pdf

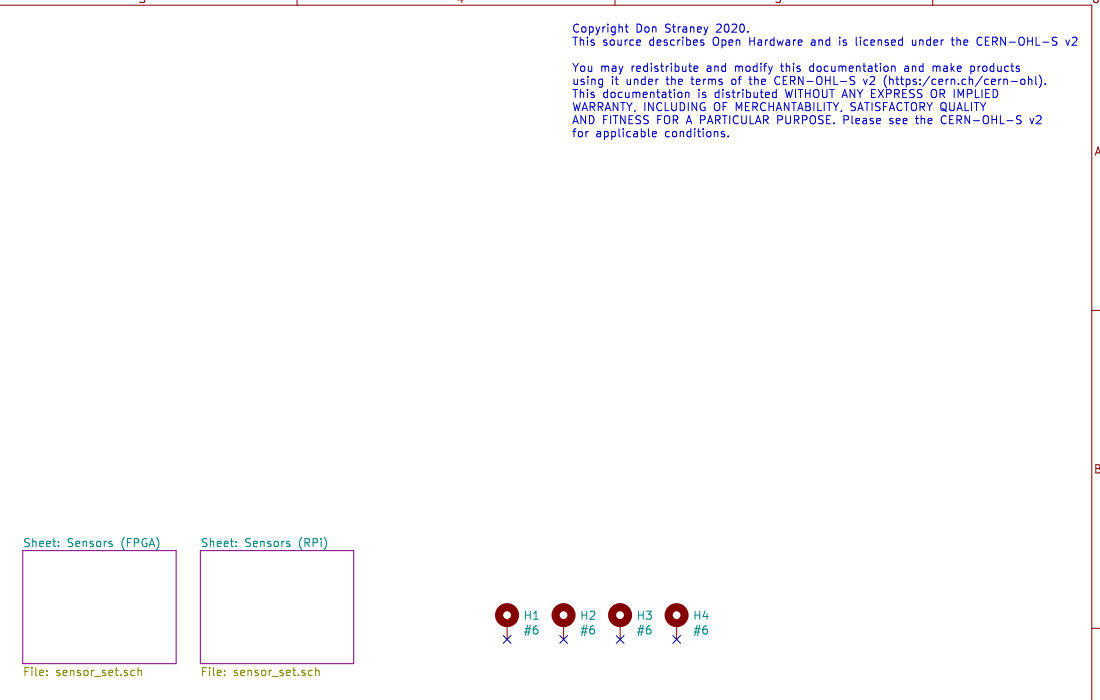
[picture p7: page 1]

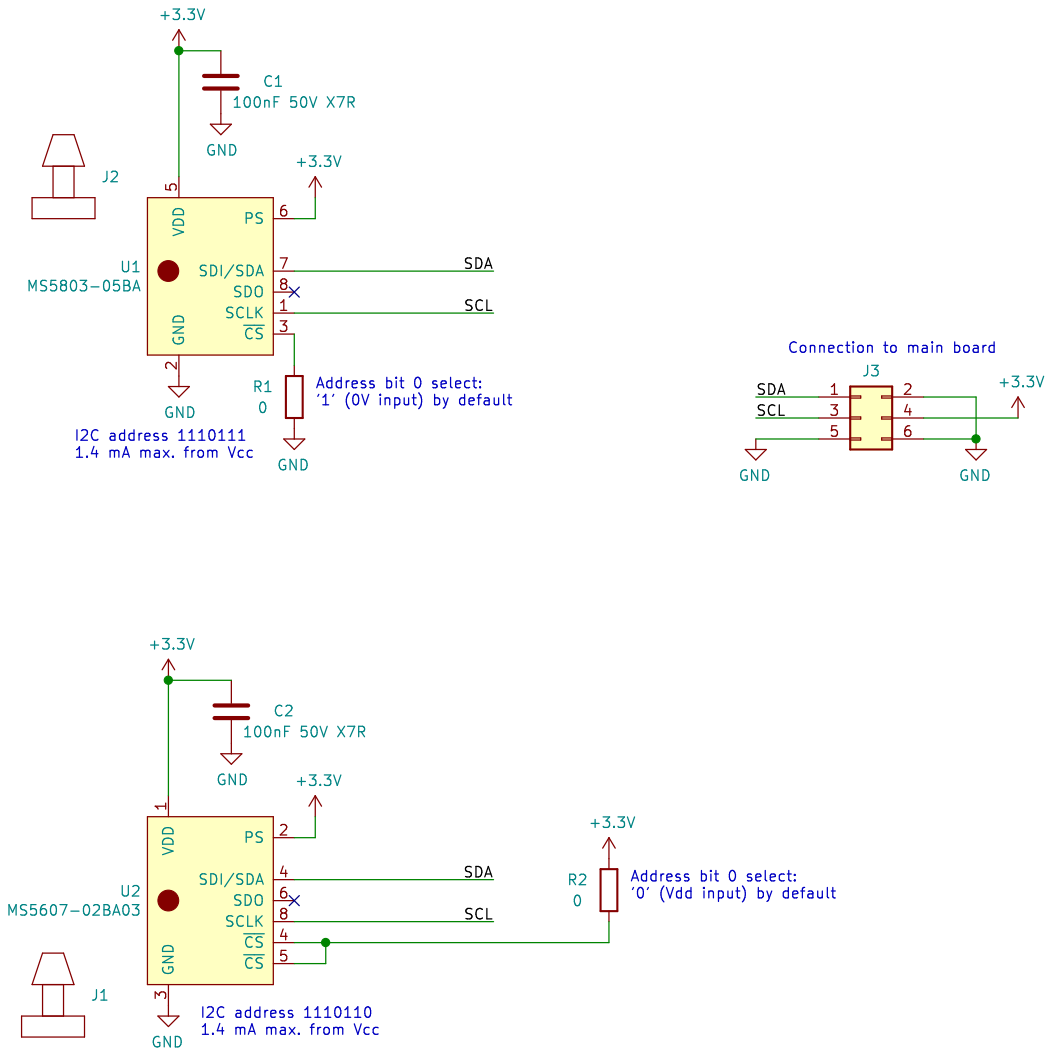
[picture p8: page 2]

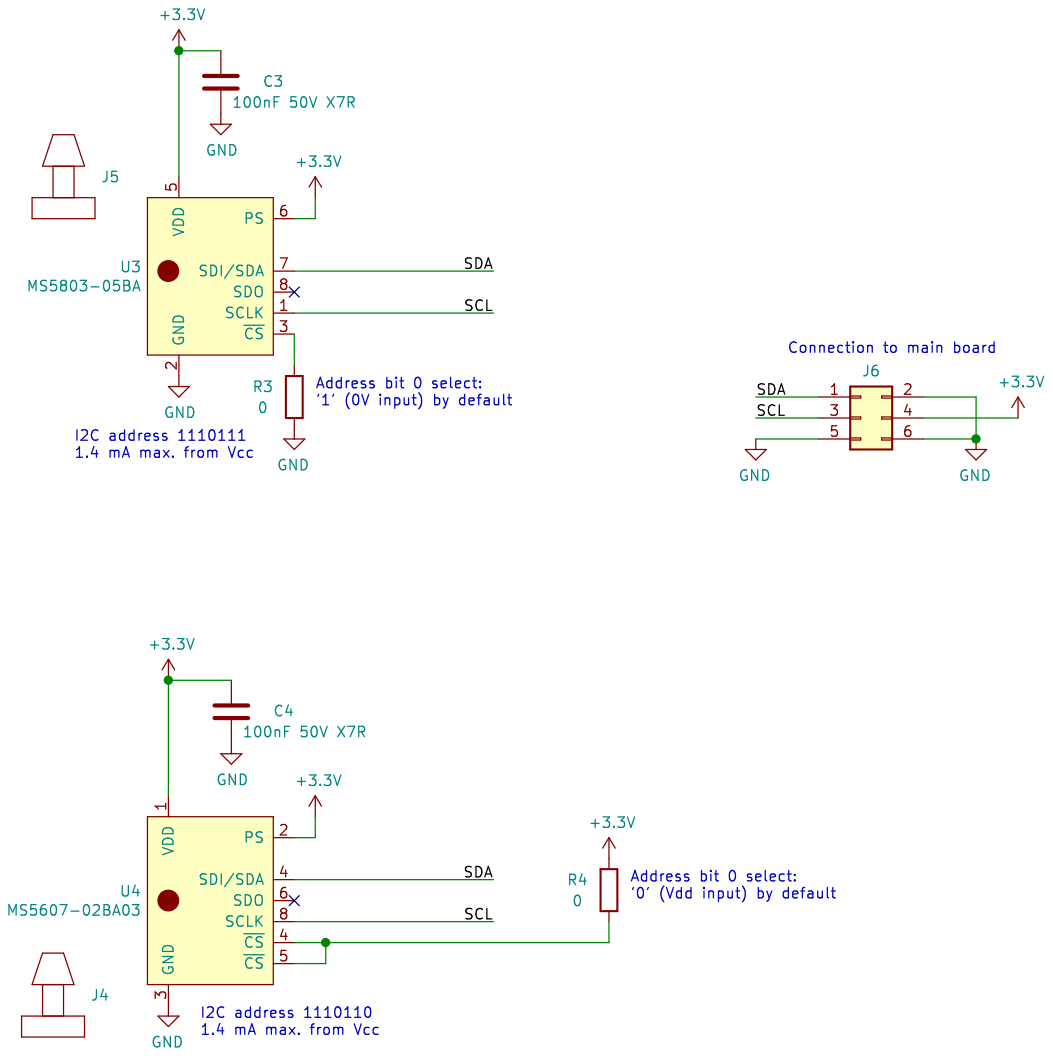
[picture p9: page 3]
