GlobalVent/electronics/Pressure_sensor_daughterboard-MS5607-MS5803/manufacturing/assy top.pdf

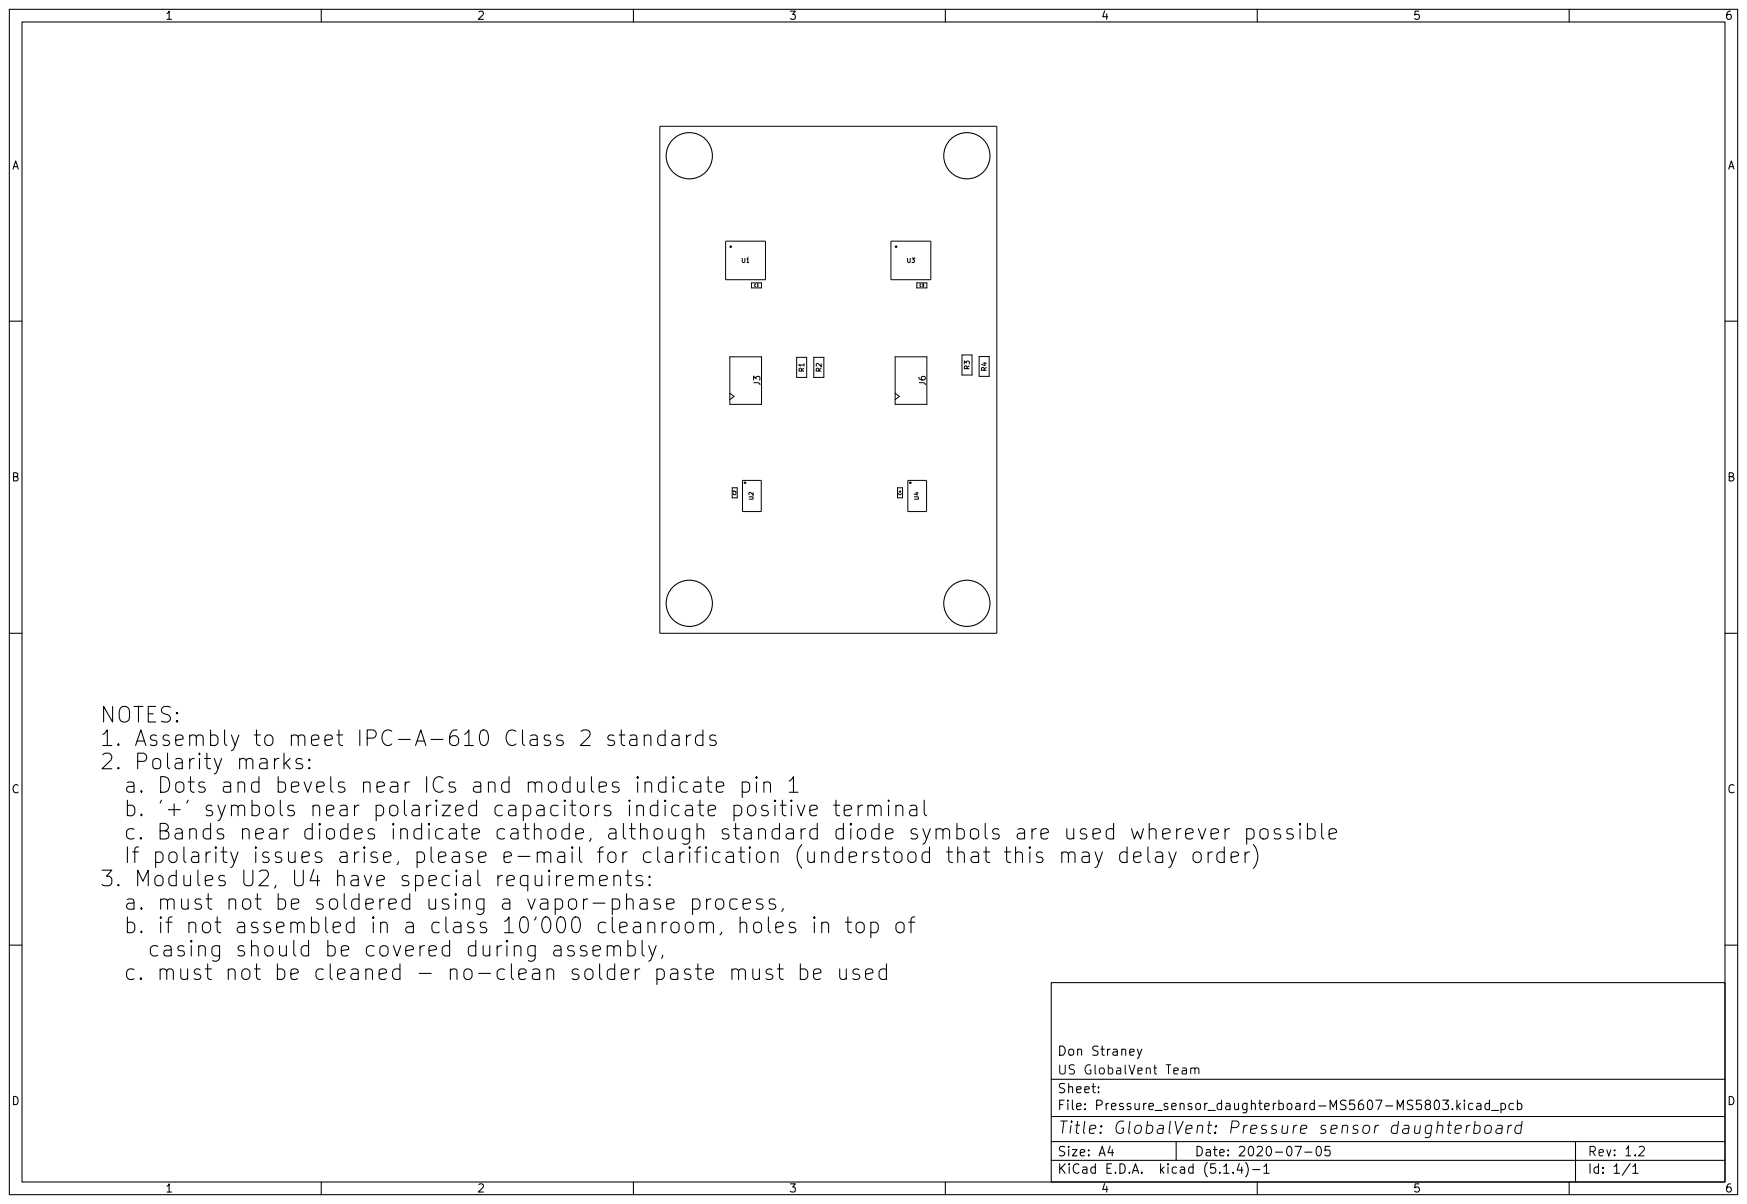
[picture p23: page 1]
