GlobalVent/electronics/Pressure_sensor_daughterboard-MS5607-MS5803/manufacturing/fab.pdf

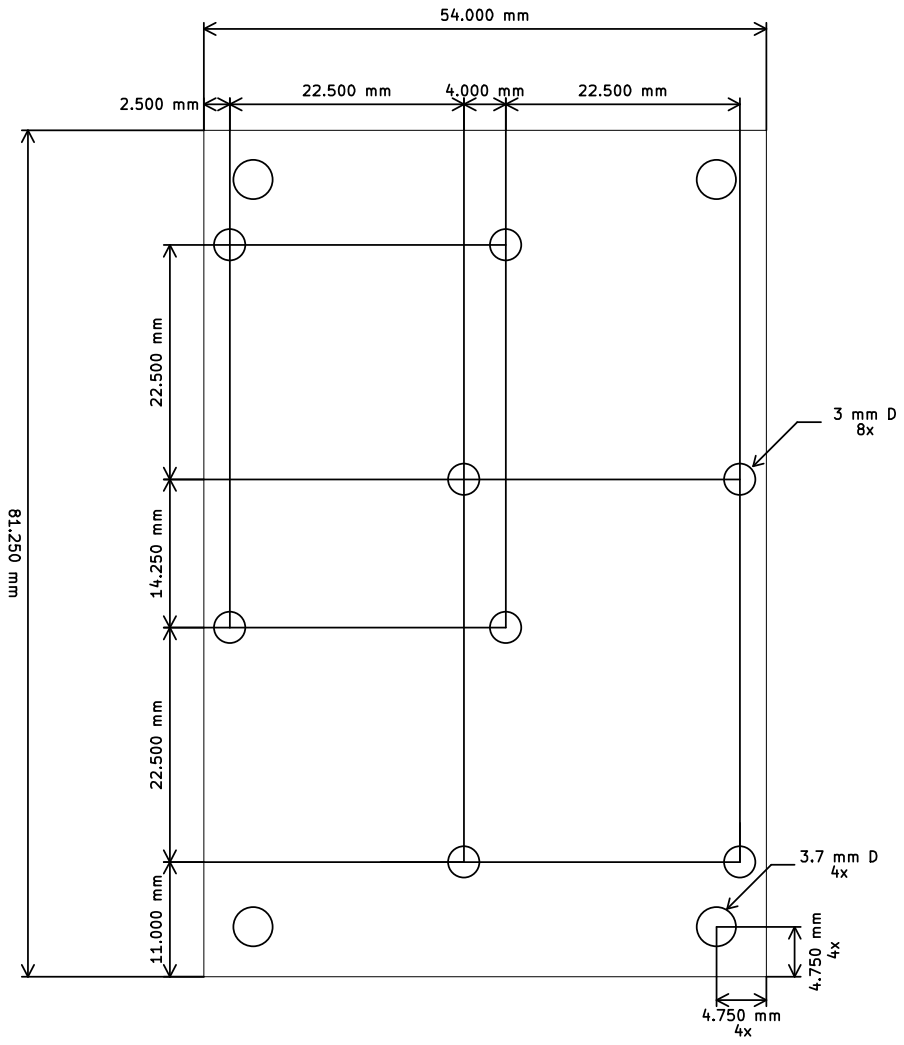
[picture p24: page 1]
