GlobalVent/electronics/RPi_cape/manufacturing/assy top.pdf

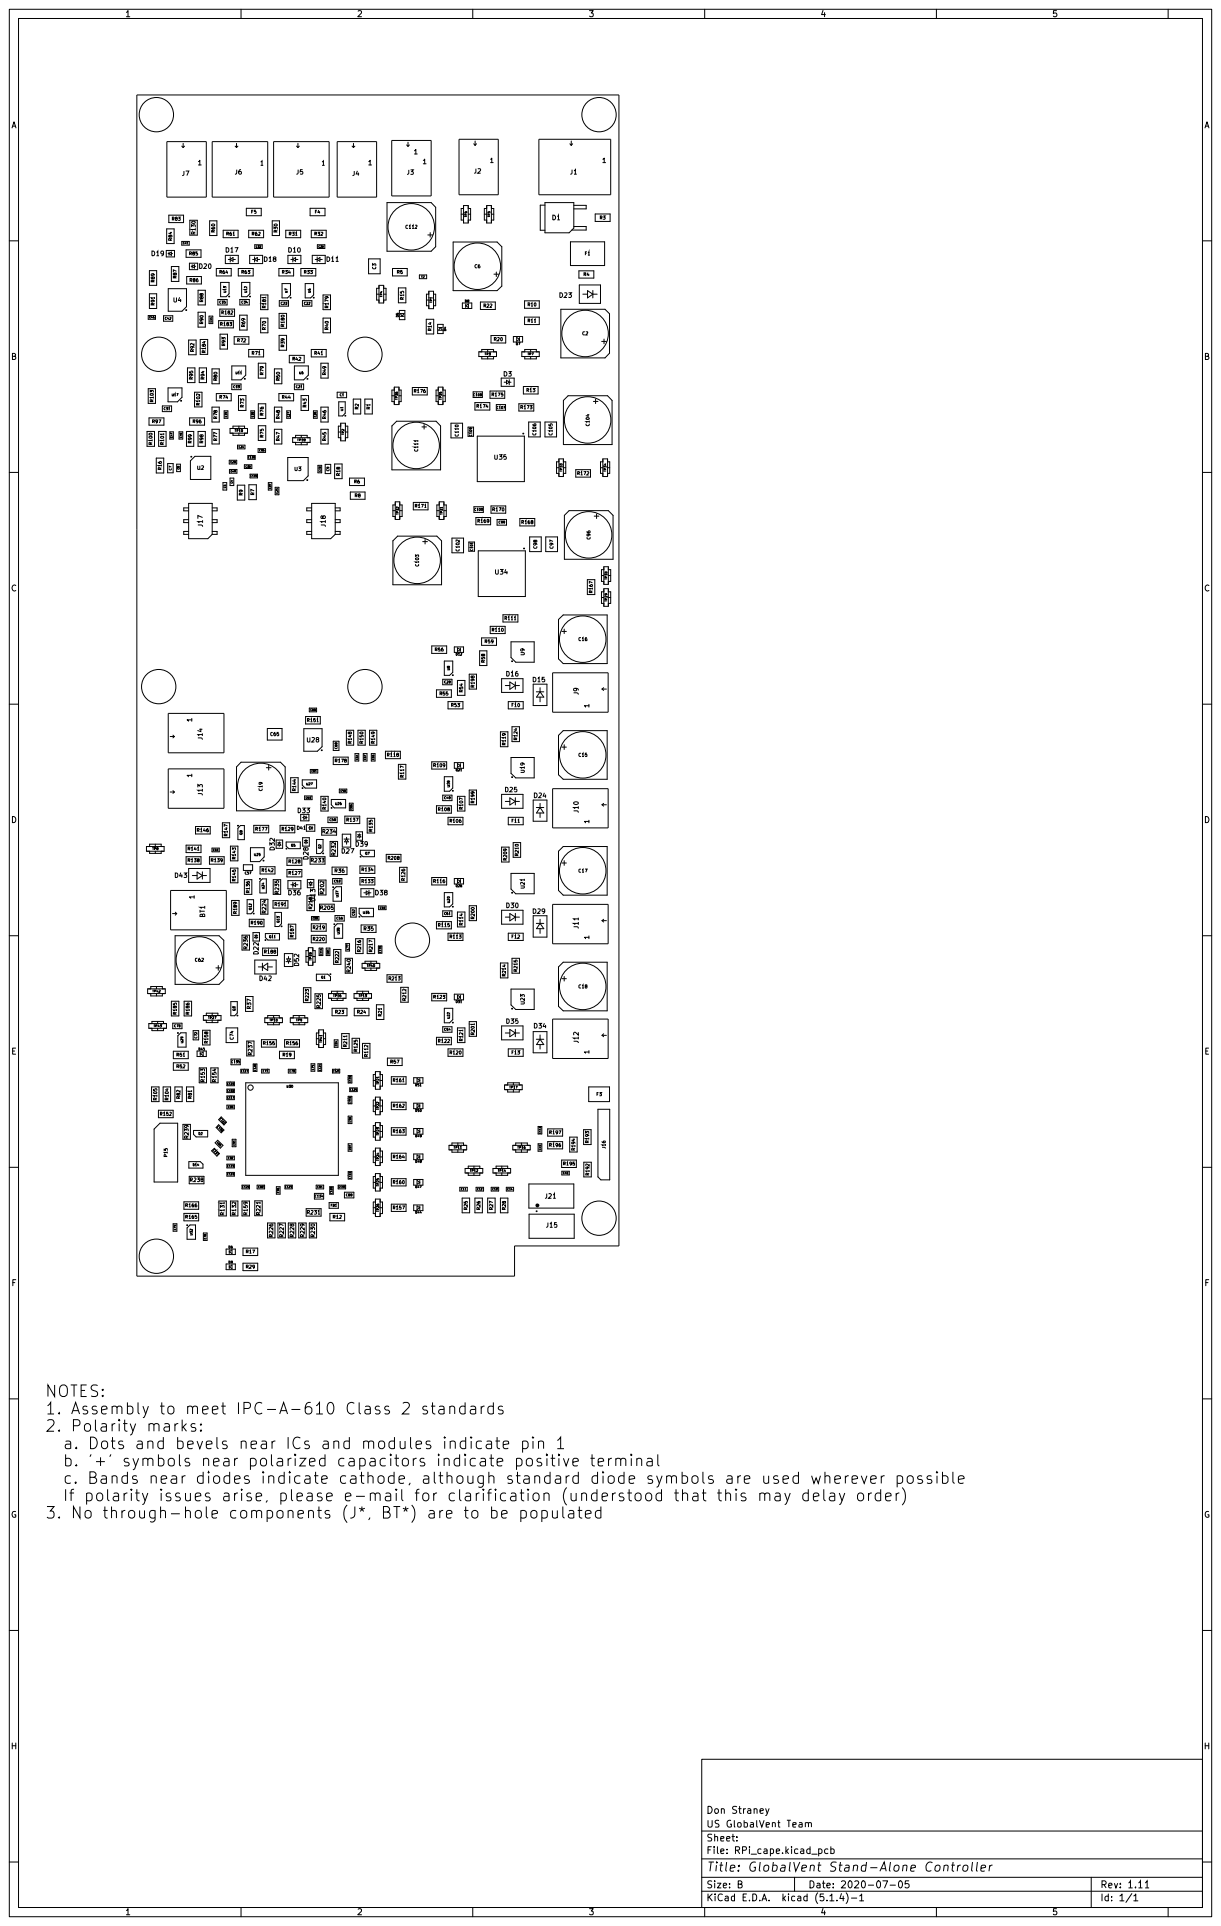
[picture p25: page 1]
