GlobalVent/electronics/RPi_cape/manufacturing/fab.pdf

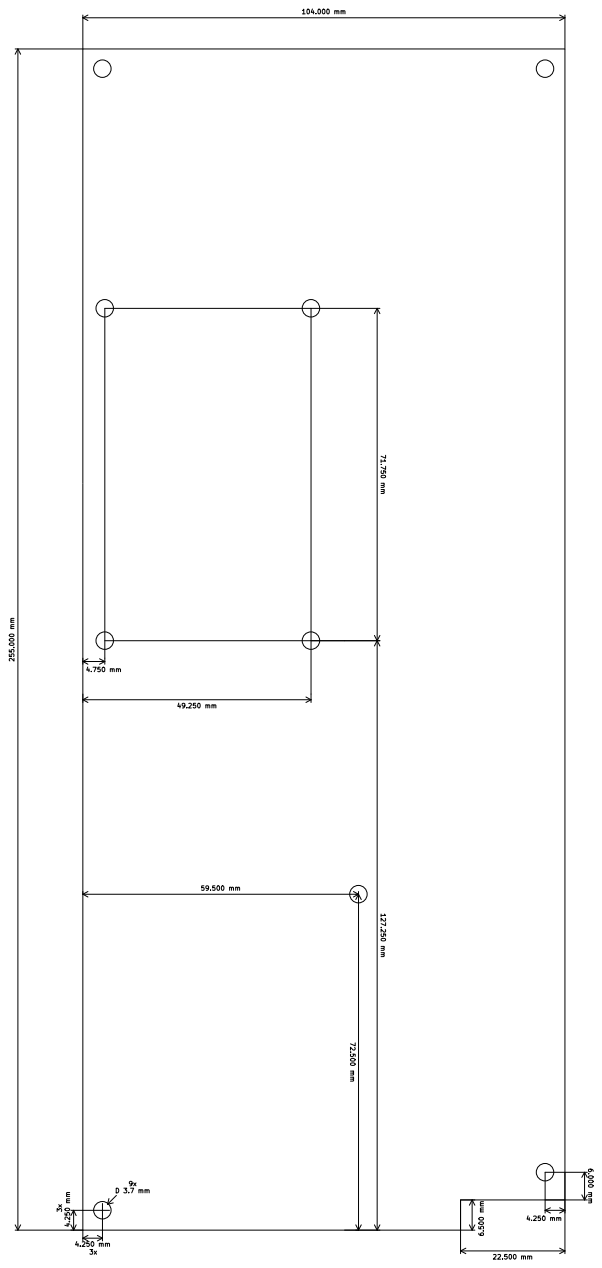
[picture p26: page 1]
