GlobalVent/electronics/RPi_cape/RPi_cape.kicad_pcb

## KiCad design RPi_cape/RPi_cape.kicad_pcb (2020-08-31)

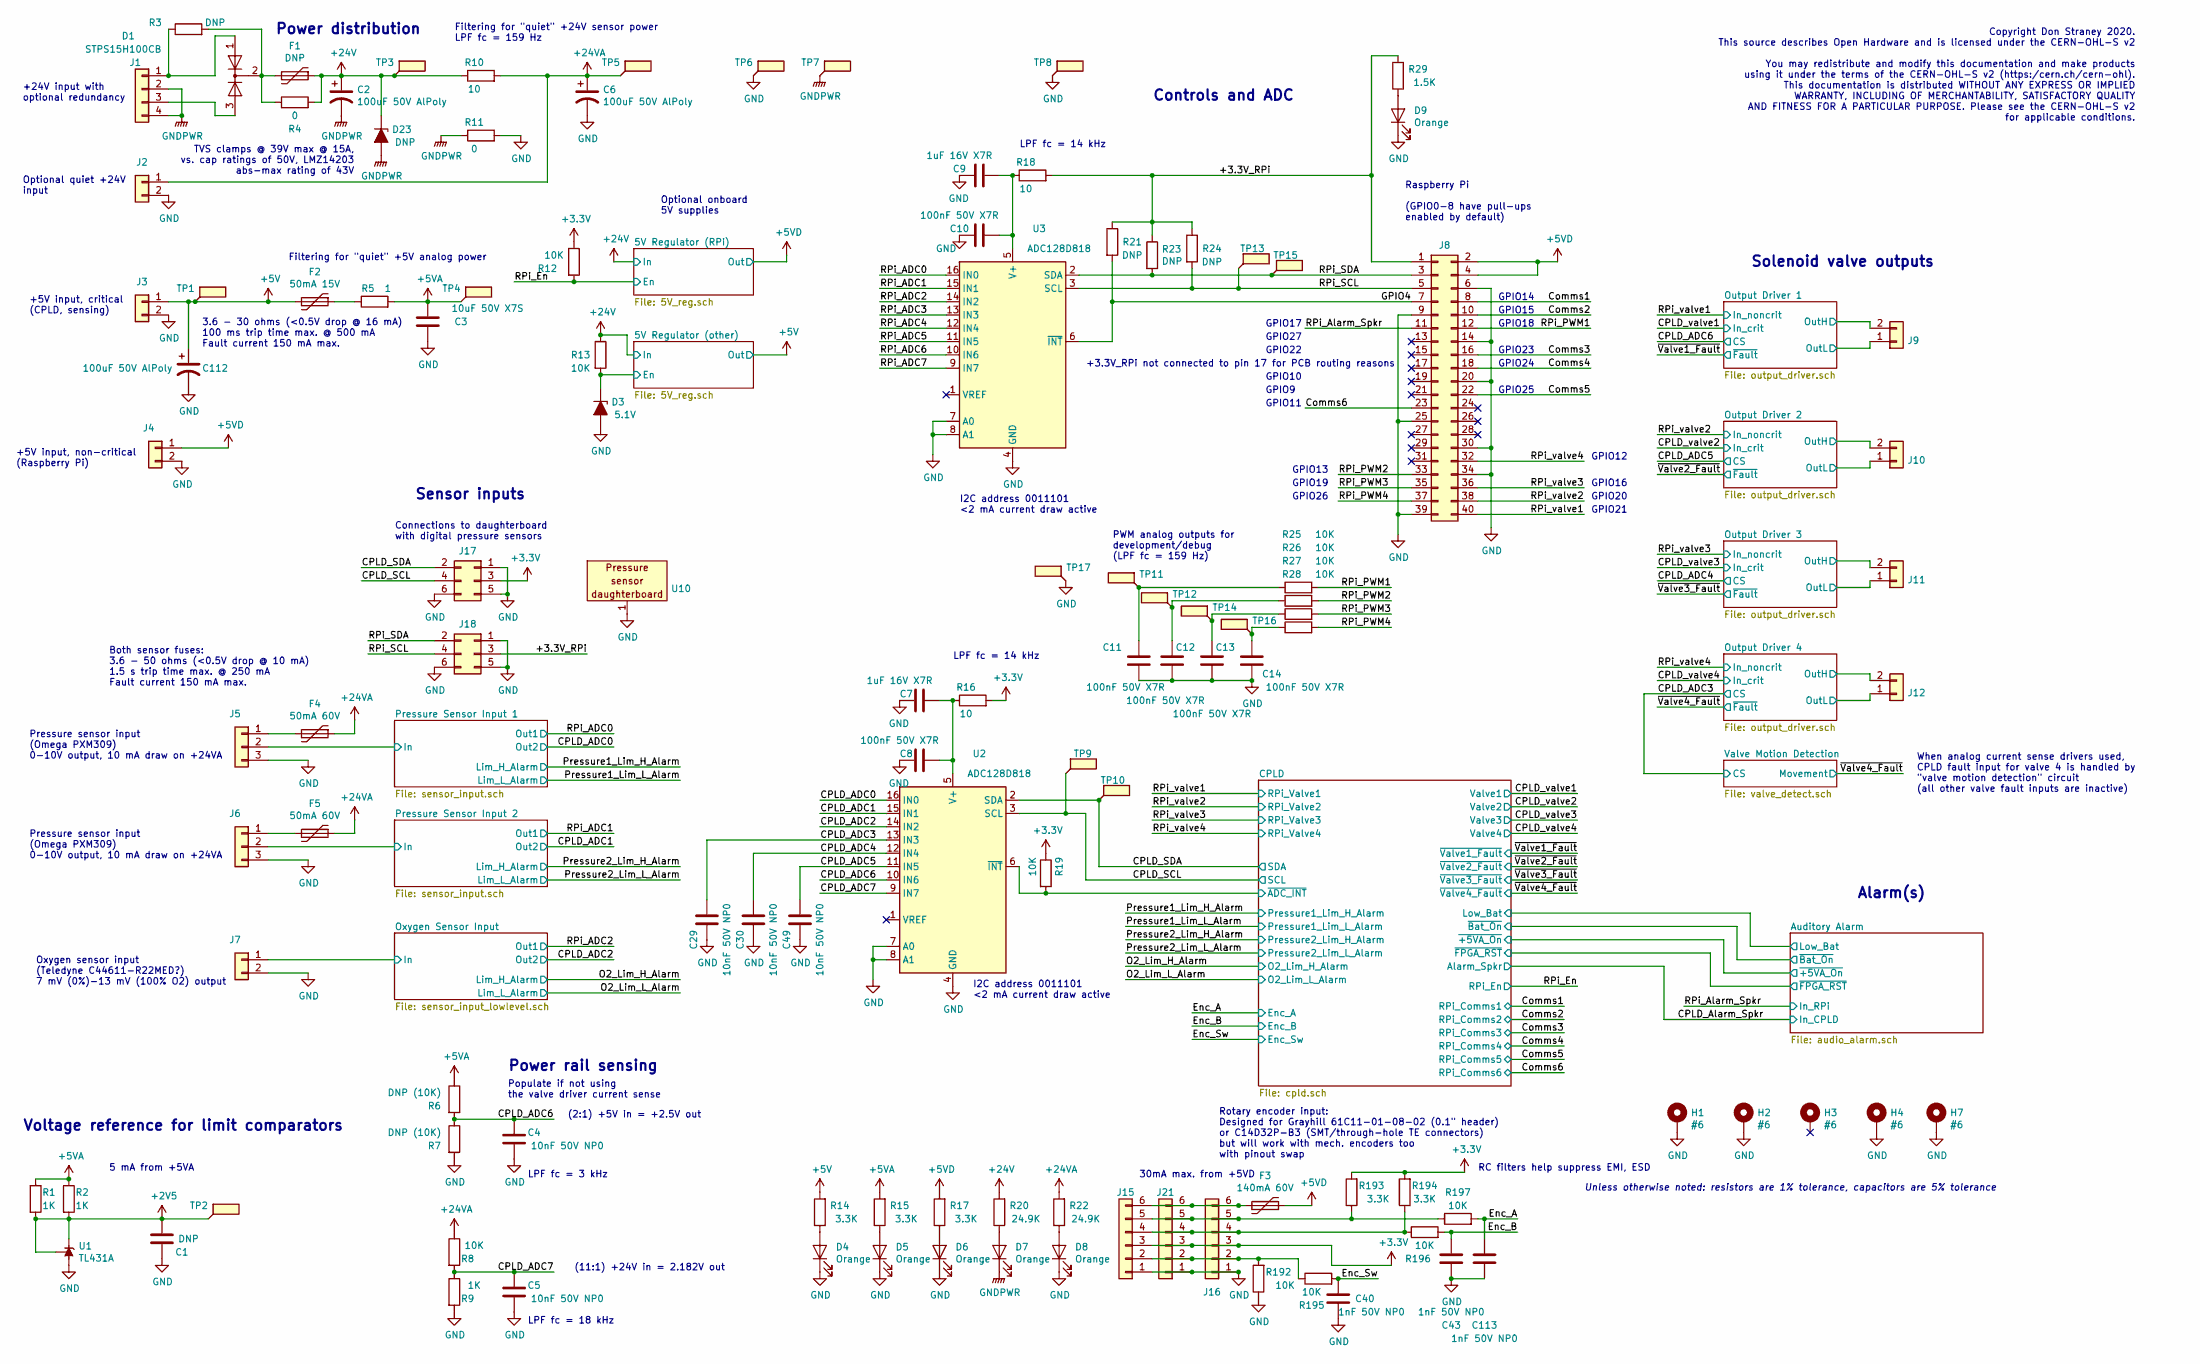
[picture p27: schematic RPi_cape.sch, GlobalVent Stand-Alone Controller]

Parts:
C1: DNP; C_0805_2012Metric
C2, C6, C112: 100uF 50V AlPoly; CP_Elec_10x10.5; Part Number EEH-ZC1H101P
C3: 10uF 50V X7S; C_1210_3225Metric; Part Number GCM32EC71H106KA03L
C4, C5, C29, C30, C49: 10nF 50V NP0; C_0603_1608Metric; Part Number GRM1885C1H103JA01D
C7, C9: 1uF 16V X7R; C_0805_2012Metric; Part Number C0805C105K4RACTU
C8, C10, C11, C12, C13, C14: 100nF 50V X7R; C_0603_1608Metric; Part Number 06035C104JAT2A
C40, C43, C113: 1nF 50V NP0; C_0603_1608Metric; Part Number 06035A102JAT2A
D1: STPS15H100CB; TO-252-2; Part Number STPS15H100CB-TR
D3: 5.1V; D_SOD-123; Part Number MMSZ5231BT1G
D4, D5, D6, D7, D8, D9: Orange; LED_0805_2012Metric; Part Number HSMD-C170
D23: DNP; D_SMB; Part Number SMBJ24A
F1: DNP; Fuse_2920_7451Metric
F2: 50mA 15V; Fuse_0603_1608Metric; Part Number 0ZCM0005FF2G
F3: 140mA 60V; Fuse_1812_4532Metric; Part Number 0ZCG0014FF2C
F4, F5: 50mA 60V; Fuse_1206_3216Metric; Part Number 0ZCJ0005FF2E
H1, H2, H3, H4, H7: #6; MountingHole_3.7mm_Pad_Via
J1: Conn_01x04; Connector_Spring_Phoenix_1985218; Part Number 1985218
J2, J3, J4, J7, J9, J10, J11, J12: Conn_01x02; Connector_Spring_Phoenix_1985195; Part Number 1985195
J5, J6: Conn_01x03; Connector_Spring_Phoenix_1985205; Part Number 1985205
J8: Conn_02x20_Odd_Even; PinSocket_2x20_P2.54mm_Vertical; Part Number PPPC202LFBN-RC
J15: Conn_01x06; TE_188275-6; Part Number 188275-6
J16: Conn_01x06; PinSocket_1x06_P2.54mm_Vertical
J17, J18: Conn_02x03_Odd_Even; PinHeader_2x03_P2.54mm_Vertical_SMD; Part Number 1241050-3
J21: Conn_01x06; TE_215079-6; Part Number 215079-6
R1, R2, R9: 1K; R_1206_3216Metric; Part Number RK73H2BTTD1001F
R3, R21, R23, R24: DNP; R_1206_3216Metric
R4, R11: 0; R_1206_3216Metric; Part Number ERJ-8GEY0R00V
R5: 1; R_1206_3216Metric; Part Number ERJ-8RQF1R0V
R6, R7: DNP (10K); R_1206_3216Metric; Part Number RK73H2BTTD1002F
R8, R12, R13, R19, R25, R26, R27, R28, R192, R195, R196, R197: 10K; R_1206_3216Metric; Part Number RK73H2BTTD1002F
R10, R16, R18: 10; R_1206_3216Metric; Part Number RK73H2BTTD10R0F
R14, R15, R17, R193, R194: 3.3K; R_1206_3216Metric; Part Number RK73H2BTTD3301F
R20, R22: 24.9K; R_1206_3216Metric; Part Number RK73H2BTTD2492F
R29: 1.5K; R_1206_3216Metric; Part Number RK73H2BTTD1501F
TP1, TP2, TP3, TP4, TP5, TP6, TP7, TP8, TP9, TP10, TP11, TP12, TP13, TP14, TP15, TP16, TP17: TestPoint_Flag; TestPoint_Keystone_5019_Minature; Part Number 5019
U1: TL431A; SOT-23; Part Number TL431AQDBZR,215
U2, U3: ADC128D818; TSSOP-16_4.4x5mm_P0.65mm; Part Number ADC128D818CIMTX/NOPB
U10: Pressure_sensor_daughterboard; Pressure_sensor_daughterboard_1.2

Connections:
+2V5: C1.2, R1.2, R2.2, TP2.1, U1.1 (K), U1.2 (REF); also elsewhere on the board
+3V3: J15.3, J16.3, J17.3, J21.3, R12.1, R16.2, R19.1, R193.2, R194.2; also elsewhere on the board
+5V: C112.1, F2.2, J3.1, R14.2, TP1.1; also elsewhere on the board
+5VD: F3.1, J4.1, J8.2, J8.4, R17.2; also elsewhere on the board
+24V: C2.1, D23.1 (K), F1.1, R4.2, R10.1, R13.1, R20.2, TP3.1; also elsewhere on the board
+24VA: C6.1, F4.1, F5.1, J2.1, R8.1, R10.2, R22.2, TP5.1; also elsewhere on the board
/5V Regulator (other)/En: D3.1 (K), R13.2; also elsewhere on the board
/+3.3V_RPi: J8.1, J18.3, R18.2, R21.1, R23.1, R24.1, R29.2
/CPLD/~ADC_INT: R19.2, U2.6 (~INT); also elsewhere on the board
/CPLD_ADC0: U2.16 (IN0); also elsewhere on the board
/CPLD_ADC1: U2.15 (IN1); also elsewhere on the board
/CPLD_ADC2: U2.14 (IN2); also elsewhere on the board
/CPLD_ADC4: C30.2, U2.12 (IN4); also elsewhere on the board
/CPLD_ADC5: C49.2, U2.11 (IN5); also elsewhere on the board
/CPLD_ADC6: C4.2, R6.2, R7.1, U2.10 (IN6); also elsewhere on the board
/CPLD_ADC7: C5.2, R8.2, R9.1, U2.9 (IN7)
/CPLD_SCL: J17.4, TP9.1, U2.3 (SCL); also elsewhere on the board
/CPLD_SDA: J17.2, TP10.1, U2.2 (SDA); also elsewhere on the board
/Comms1: J8.8; also elsewhere on the board
/Comms2: J8.10; also elsewhere on the board
/Comms3: J8.16; also elsewhere on the board
/Comms4: J8.18; also elsewhere on the board
/Comms5: J8.22; also elsewhere on the board
/Comms6: J8.23; also elsewhere on the board
/Enc_A: C113.2, R197.2; also elsewhere on the board
/Enc_B: C43.2, R196.2; also elsewhere on the board
/Enc_Sw: C40.2, R195.2; also elsewhere on the board
/GPIO4: J8.7, R21.2, U3.6 (~INT)
/Output Driver 1/OutH: J9.2; also elsewhere on the board
/Output Driver 1/OutL: J9.1; also elsewhere on the board
/Output Driver 2/OutH: J10.2; also elsewhere on the board
/Output Driver 2/OutL: J10.1; also elsewhere on the board
/Output Driver 3/OutH: J11.2; also elsewhere on the board
/Output Driver 3/OutL: J11.1; also elsewhere on the board
/Output Driver 4/OutH: J12.2; also elsewhere on the board
/Output Driver 4/OutL: J12.1; also elsewhere on the board
/Oxygen Sensor Input/In: J7.1; also elsewhere on the board
/Pressure Sensor Input 1/In: J5.2; also elsewhere on the board
/Pressure Sensor Input 2/In: J6.2; also elsewhere on the board
/RPi_ADC0: U3.16 (IN0); also elsewhere on the board
/RPi_ADC1: U3.15 (IN1); also elsewhere on the board
/RPi_ADC2: U3.14 (IN2); also elsewhere on the board
/RPi_ADC3: U3.13 (IN3)
/RPi_ADC4: U3.12 (IN4)
/RPi_ADC5: U3.11 (IN5)
/RPi_ADC6: U3.10 (IN6)
/RPi_ADC7: U3.9 (IN7)
/RPi_Alarm_Spkr: J8.11; also elsewhere on the board
/RPi_En: R12.2; also elsewhere on the board
/RPi_PWM1: J8.12, R25.2
/RPi_PWM2: J8.33, R26.2
/RPi_PWM3: J8.35, R27.2
/RPi_PWM4: J8.37, R28.2
/RPi_SCL: J8.5, J18.4, R24.2, TP13.1, U3.3 (SCL)
/RPi_SDA: J8.3, J18.2, R23.2, TP15.1, U3.2 (SDA)
/RPi_valve1: J8.40; also elsewhere on the board
/RPi_valve2: J8.38; also elsewhere on the board
/RPi_valve3: J8.36; also elsewhere on the board
/RPi_valve4: J8.32; also elsewhere on the board
GNDPWR: C2.2, D7.1 (K), D23.2 (A), J1.2, J1.4, R11.1, TP7.1; also elsewhere on the board
unnamed: C7.2, C8.2, R16.1, U2.5 (V+)
unnamed: C9.2, C10.2, R18.1, U3.5 (V+)
unnamed: C11.1, R25.1, TP11.1
unnamed: C12.1, R26.1, TP12.1
unnamed: C13.1, R27.1, TP14.1
unnamed: C14.1, R28.1, TP16.1
unnamed: D1.1 (A), J1.1, R3.1
unnamed: D1.2 (K), F1.2, R3.2, R4.1
unnamed: D1.3 (A), J1.3
unnamed: D4.2 (A), R14.1
unnamed: D5.2 (A), R15.1
unnamed: D6.2 (A), R17.1
unnamed: D7.2 (A), R20.1
unnamed: D8.2 (A), R22.1
unnamed: D9.2 (A), R29.1
unnamed: F2.1, R5.1
unnamed: F3.2, J15.6, J16.6, J21.6
unnamed: F4.2, J5.1
unnamed: F5.2, J6.1
unnamed: J15.2, J16.2, J21.2, R192.2, R195.1
unnamed: J15.4, J16.4, J21.4, R194.1, R196.1
unnamed: J15.5, J16.5, J21.5, R193.1, R197.1

Notes on the sheet:
Raspberry Pi (GPIO0-8 have pull-ups enabled by default)
I2C address 0011101 <2 mA current draw active
Optional quiet +24V input
+24V input with optional redundancy
+5V input, critical (CPLD, sensing)
Filtering for "quiet" +24V sensor power LPF fc = 159 Hz
Filtering for "quiet" +5V analog power
(2:1) +5V in = +2.5V out
(11:1) +24V in = 2.182V out
LPF fc = 3 kHz
LPF fc = 18 kHz
Pressure sensor input (Omega PXM309) 0-10V output, 10 mA draw on +24VA
Oxygen sensor input (Teledyne C44611-R22MED?) 7 mV (0%)-13 mV (100% O2) output
Power rail sensing
Sensor inputs
Power distribution
Solenoid valve outputs
Controls and ADC
+5V input, non-critical (Raspberry Pi)
PWM analog outputs for development/debug (LPF fc = 159 Hz)
Both sensor fuses: 3.6 - 50 ohms (<0.5V drop @ 10 mA) 1.5 s trip time max. @ 250 mA Fault current 150 mA max.
LPF fc = 14 kHz
GPIO17
GPIO27
GPIO22
GPIO10
Voltage reference for limit comparators
5 mA from +5VA
3.6 - 30 ohms (<0.5V drop @ 16 mA) 100 ms trip time max. @ 500 mA Fault current 150 mA max.
GPIO9
Optional onboard 5V supplies
GPIO15
GPIO18
GPIO24
GPIO14
GPIO23
GPIO25
Unless otherwise noted: resistors are 1% tolerance, capacitors are 5% tolerance
GPIO13
GPIO19
GPIO26
GPIO11
Rotary encoder input: Designed for Grayhill 61C11-01-08-02 (0.1" header) or C14D32P-B3 (SMT/through-hole TE connectors) but will work with mech. encoders too with pinout swap
GPIO16
GPIO20
GPIO21
RC filters help suppress EMI, ESD
30mA max. from +5VD
GPIO12
+3.3V_RPi not connected to pin 17 for PCB routing reasons
Populate if not using the valve driver current sense
When analog current sense drivers used, CPLD fault input for valve 4 is handled by "valve motion detection" circuit (all other valve fault inputs are inactive)
Alarm(s)
TVS clamps @ 39V max @ 15A, vs. cap ratings of 50V, LMZ14203 abs-max rating of 43V
Copyright Don Straney 2020. This source describes Open Hardware and is licensed under the CERN-OHL-S v2 You may redistribute and modify this documentation and make products using it under the terms of the CERN-OHL-S v2 (https:/cern.ch/cern-ohl). This documentation is distributed WITHOUT ANY EXPRESS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
Connections to daughterboard with digital pressure sensors

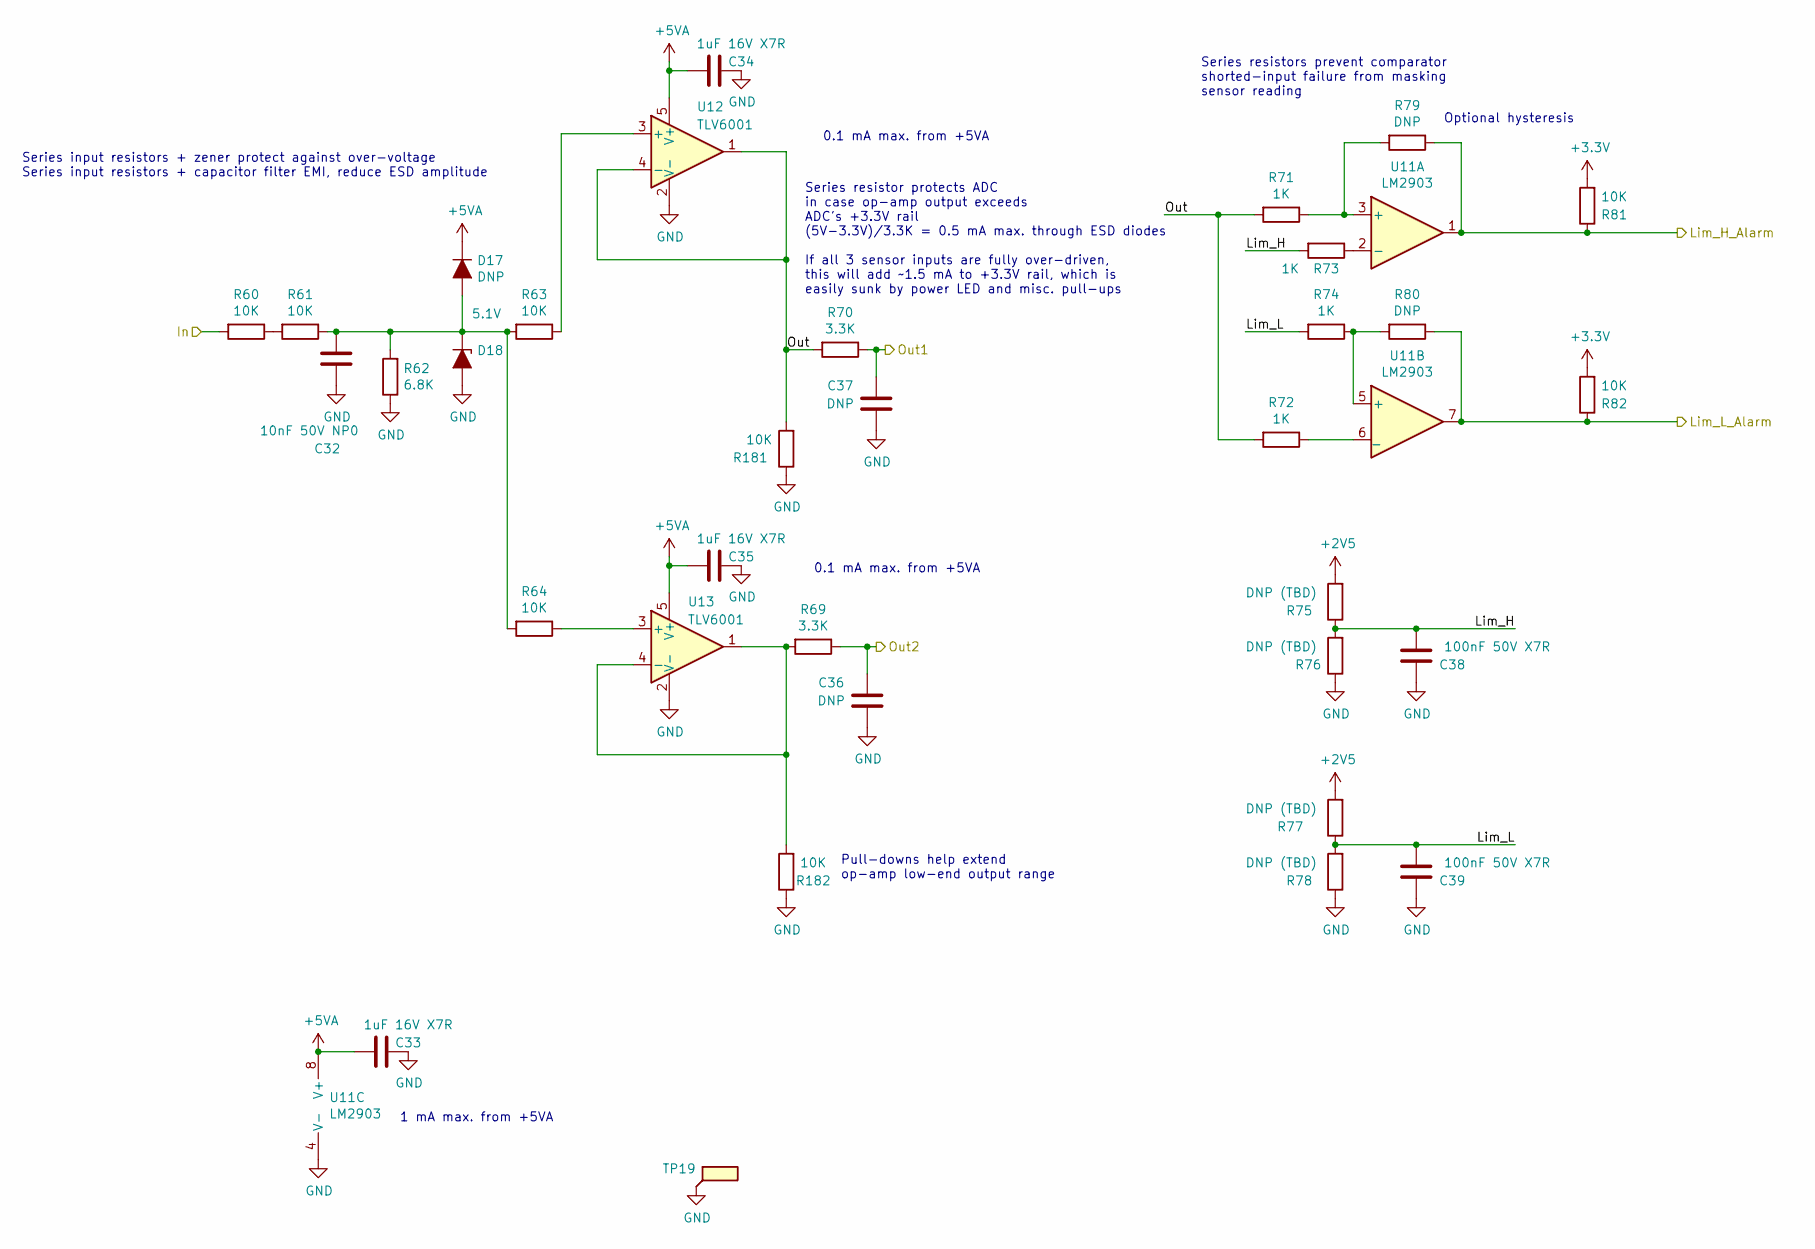
[picture p28: schematic sensor_input.sch, GlobalVent Stand-Alone Controller]

Parts:
C20: 10nF 50V NP0; C_0603_1608Metric; Part Number GRM1885C1H103JA01D
C21, C22, C23: 1uF 16V X7R; C_0805_2012Metric; Part Number C0805C105K4RACTU
C24, C25: DNP; C_0603_1608Metric
C26, C27: 100nF 50V X7R; C_0603_1608Metric; Part Number 06035C104JAT2A
D10: DNP; D_SOD-123
D11: 5.1V; D_SOD-123; Part Number MMSZ5231BT1G
R30, R31, R33, R34, R51, R52, R179, R180: 10K; R_1206_3216Metric; Part Number RK73H2BTTD1002F
R32: 6.8K; R_1206_3216Metric; Part Number RK73H2BTTD6801F
R39, R40: 3.3K; R_1206_3216Metric; Part Number RK73H2BTTD3301F
R41, R42, R43, R44: 1K; R_1206_3216Metric; Part Number RK73H2BTTD1001F
R45, R46, R47, R48: DNP (TBD); R_1206_3216Metric
R49, R50: DNP; R_1206_3216Metric
TP18: TestPoint_Flag; TestPoint_Keystone_5019_Minature; Part Number 5019
U5: LM2903; VSSOP-8_3.0x3.0mm_P0.65mm; Part Number LM2903DGKR
U6, U7: TLV6001; SOT-23-5; Part Number TLV6001IDBVR

Connections:
+2V5: R45.2, R47.2; also elsewhere on the board
+3V3: R51.2, R52.2; also elsewhere on the board
/CPLD_ADC0: C24.2, R39.1; also elsewhere on the board
/Pressure1_Lim_H_Alarm: R49.1, R51.1, U5.1; also elsewhere on the board
/Pressure1_Lim_L_Alarm: R50.1, R52.1, U5.7; also elsewhere on the board
/Pressure Sensor Input 1/In: R30.2; also elsewhere on the board
/Pressure Sensor Input 1/Lim_H: C26.2, R43.2, R45.1, R46.2
/Pressure Sensor Input 1/Lim_L: C27.2, R44.2, R47.1, R48.2
/Pressure Sensor Input 1/Out: R40.2, R41.2, R42.2, R179.2, U6.1, U6.4 (-)
/RPi_ADC0: C25.2, R40.1; also elsewhere on the board
unnamed: C20.2, D10.2 (A), D11.1 (K), R31.1, R32.2, R33.2, R34.2
unnamed: R30.1, R31.2
unnamed: R33.1, U6.3 (+)
unnamed: R34.1, U7.3 (+)
unnamed: R41.1, R49.2, U5.3 (+)
unnamed: R42.1, U5.6 (_)
unnamed: R43.1, U5.2 (-)
unnamed: R44.1, R50.2, U5.5 (+)
unnamed: R39.2, R180.2, U7.1, U7.4 (-)

Parts of its further copies:
C32: 10nF 50V NP0; C_0603_1608Metric; Part Number GRM1885C1H103JA01D
C33, C34, C35: 1uF 16V X7R; C_0805_2012Metric; Part Number C0805C105K4RACTU
C36, C37: DNP; C_0603_1608Metric
C38, C39: 100nF 50V X7R; C_0603_1608Metric; Part Number 06035C104JAT2A
D17: DNP; D_SOD-123
D18: 5.1V; D_SOD-123; Part Number MMSZ5231BT1G
R60, R61, R63, R64, R81, R82, R181, R182: 10K; R_1206_3216Metric; Part Number RK73H2BTTD1002F
R62: 6.8K; R_1206_3216Metric; Part Number RK73H2BTTD6801F
R69, R70: 3.3K; R_1206_3216Metric; Part Number RK73H2BTTD3301F
R71, R72, R73, R74: 1K; R_1206_3216Metric; Part Number RK73H2BTTD1001F
R75, R76, R77, R78: DNP (TBD); R_1206_3216Metric
R79, R80: DNP; R_1206_3216Metric
TP19: TestPoint_Flag; TestPoint_Keystone_5019_Minature; Part Number 5019
U11: LM2903; VSSOP-8_3.0x3.0mm_P0.65mm; Part Number LM2903DGKR
U12, U13: TLV6001; SOT-23-5; Part Number TLV6001IDBVR

Connections of its further copies:
+2V5: R75.2, R77.2; also elsewhere on the board
+3V3: R81.2, R82.2; also elsewhere on the board
/CPLD_ADC1: C36.2, R69.1; also elsewhere on the board
/Pressure2_Lim_H_Alarm: R79.1, R81.1, U11.1; also elsewhere on the board
/Pressure2_Lim_L_Alarm: R80.1, R82.1, U11.7; also elsewhere on the board
/Pressure Sensor Input 2/In: R60.2; also elsewhere on the board
/Pressure Sensor Input 2/Lim_H: C38.2, R73.2, R75.1, R76.2
/Pressure Sensor Input 2/Lim_L: C39.2, R74.2, R77.1, R78.2
/Pressure Sensor Input 2/Out: R70.2, R71.2, R72.2, R181.2, U12.1, U12.4 (-)
/RPi_ADC1: C37.2, R70.1; also elsewhere on the board
unnamed: C32.2, D17.2 (A), D18.1 (K), R61.1, R62.2, R63.2, R64.2
unnamed: R60.1, R61.2
unnamed: R63.1, U12.3 (+)
unnamed: R64.1, U13.3 (+)
unnamed: R71.1, R79.2, U11.3 (+)
unnamed: R72.1, U11.6 (_)
unnamed: R73.1, U11.2 (-)
unnamed: R74.1, R80.2, U11.5 (+)
unnamed: R69.2, R182.2, U13.1, U13.4 (-)

Notes on the sheet:
Series resistor protects ADC in case op-amp output exceeds ADC's +3.3V rail (5V-3.3V)/3.3K = 0.5 mA max. through ESD diodes If all 3 sensor inputs are fully over-driven, this will add ~~1.5 mA to +3.3V rail, which is easily sunk by power LED and misc. pull-ups
Series resistors prevent comparator shorted-input failure from masking sensor reading
Optional hysteresis
1 mA max. from +5VA
0.1 mA max. from +5VA
Series input resistors + zener protect against over-voltage Series input resistors + capacitor filter EMI, reduce ESD amplitude
Pull-downs help extend op-amp low-end output range

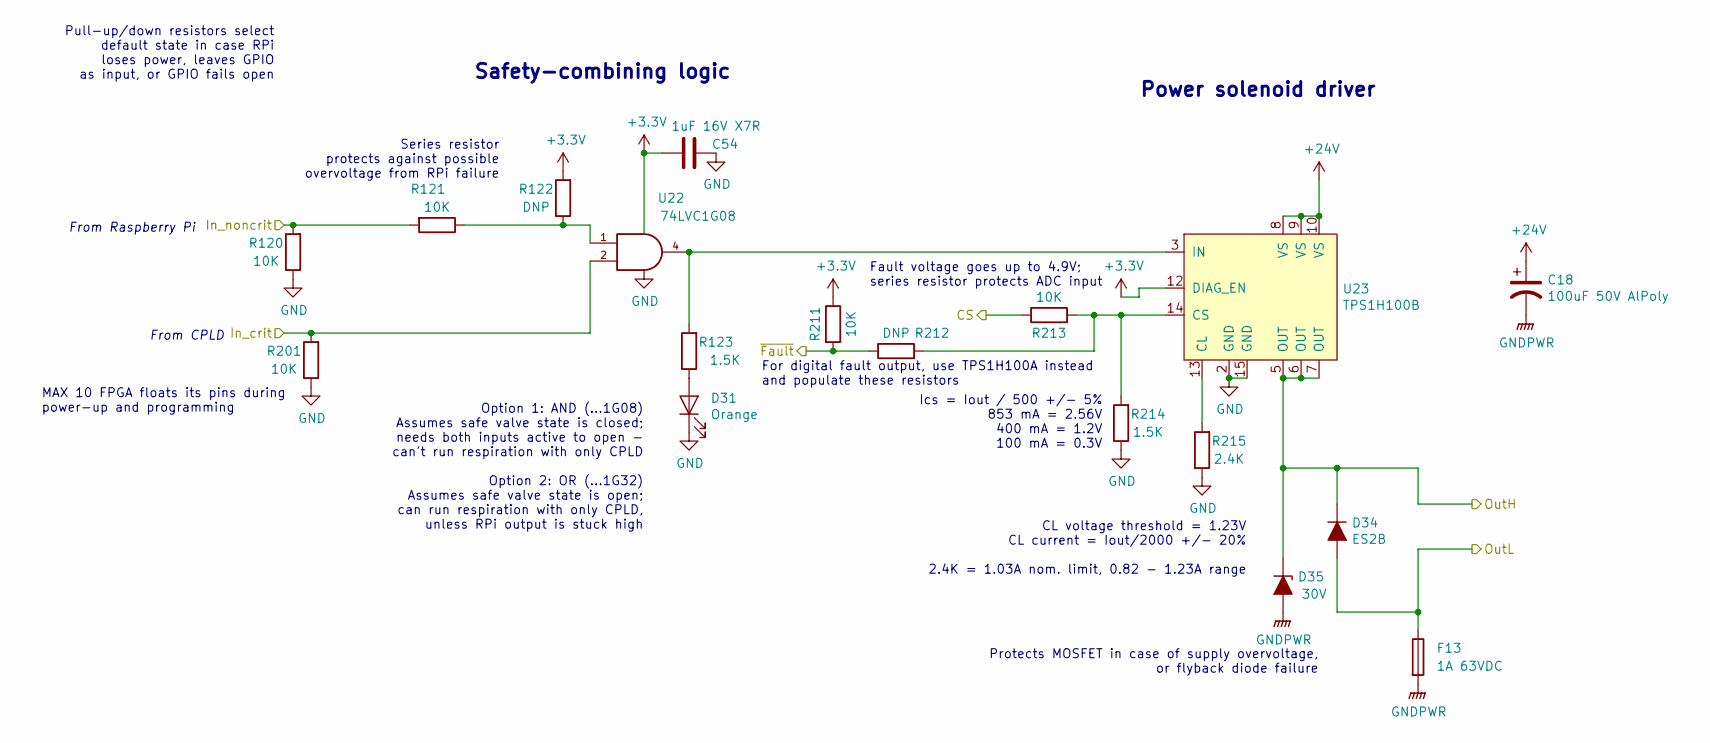
[picture p29: schematic output_driver.sch, GlobalVent Stand-Alone Controller]

Parts:
C16: 100uF 50V AlPoly; CP_Elec_10x10.5; Part Number EEH-ZC1H101P
C28: 1uF 16V X7R; C_0805_2012Metric; Part Number C0805C105K4RACTU
D12: Orange; LED_0805_2012Metric; Part Number HSMD-C170
D15: ES2B; D_SMA; Part Number ES2G-E3/52T
D16: 30V; D_SMA; Part Number SMAJ30A-E3/61
F10: 1A 63VDC; Fuse_1206_3216Metric; Part Number SF-1206FP100-2
R53, R54, R57, R59, R198: 10K; R_1206_3216Metric; Part Number RK73H2BTTD1002F
R55, R58: DNP; R_1206_3216Metric
R56, R110: 1.5K; R_1206_3216Metric; Part Number RK73H2BTTD1501F
R111: 2.4K; R_1206_3216Metric; Part Number RK73H2BTTD2401F
U8: 74LVC1G08; SOT-23-5; Part Number SN74LVC1G08DBVR
U9: TPS1H100B; TSSOP-14-1EP_4.4x5mm_P0.65mm; Part Number TPS1H100BQPWPRQ1

Connections:
+3V3: C28.2, R55.2, R57.1, U8.5 (VCC), U9.12 (DIAG_EN); also elsewhere on the board
+24V: C16.1, U9.8 (VS), U9.9 (VS), U9.10 (VS); also elsewhere on the board
/CPLD_ADC6: R59.1; also elsewhere on the board
/CPLD_valve1: R198.2, U8.2; also elsewhere on the board
/Output Driver 1/OutH: D15.1 (K), D16.1 (K), U9.5 (OUT), U9.6 (OUT), U9.7 (OUT); also elsewhere on the board
/Output Driver 1/OutL: D15.2 (A), F10.1; also elsewhere on the board
/RPi_valve1: R53.2, R54.2; also elsewhere on the board
/~Valve1_Fault: R57.2, R58.1; also elsewhere on the board
GNDPWR: C16.2, D16.2 (A), F10.2; also elsewhere on the board
unnamed: D12.2 (A), R56.1
unnamed: R54.1, R55.1, U8.1
unnamed: R56.2, U8.4, U9.3 (IN)
unnamed: R58.2, R59.2, R110.2, U9.14 (CS)
unnamed: R111.2, U9.13 (CL)

Parts of its further copies:
C15, C17, C18: 100uF 50V AlPoly; CP_Elec_10x10.5; Part Number EEH-ZC1H101P
C48, C51, C54: 1uF 16V X7R; C_0805_2012Metric; Part Number C0805C105K4RACTU
D21, D26, D31: Orange; LED_0805_2012Metric; Part Number HSMD-C170
D24, D29, D34: ES2B; D_SMA; Part Number ES2G-E3/52T
D25, D30, D35: 30V; D_SMA; Part Number SMAJ30A-E3/61
F11, F12, F13: 1A 63VDC; Fuse_1206_3216Metric; Part Number SF-1206FP100-2
R106, R107, R112, R113, R114, R118, R120, R121, R125, R199, R200, R201, R208, R211, R213: 10K; R_1206_3216Metric; Part Number RK73H2BTTD1002F
R108, R115, R117, R122, R126, R212: DNP; R_1206_3216Metric
R109, R116, R119, R123, R209, R214: 1.5K; R_1206_3216Metric; Part Number RK73H2BTTD1501F
R124, R210, R215: 2.4K; R_1206_3216Metric; Part Number RK73H2BTTD2401F
U18, U20, U22: 74LVC1G08; SOT-23-5; Part Number SN74LVC1G08DBVR
U19, U21, U23: TPS1H100B; TSSOP-14-1EP_4.4x5mm_P0.65mm; Part Number TPS1H100BQPWPRQ1

Connections of its further copies:
+3V3: C48.2, C51.2, C54.2, R108.2, R112.1, R115.2, R122.2, R125.1, R211.1, U18.5 (VCC), U19.12 (DIAG_EN), U20.5 (VCC), U21.12 (DIAG_EN), U22.5 (VCC), U23.12 (DIAG_EN); also elsewhere on the board
+24V: C15.1, C17.1, C18.1, U19.8 (VS), U19.9 (VS), U19.10 (VS), U21.8 (VS), U21.9 (VS), U21.10 (VS), U23.8 (VS), U23.9 (VS), U23.10 (VS); also elsewhere on the board
/CPLD_ADC4: R208.1; also elsewhere on the board
/CPLD_ADC5: R118.1; also elsewhere on the board
/CPLD_valve2: R199.2, U18.2; also elsewhere on the board
/CPLD_valve3: R200.2, U20.2; also elsewhere on the board
/CPLD_valve4: R201.2, U22.2; also elsewhere on the board
/Output Driver 2/OutH: D24.1 (K), D25.1 (K), U19.5 (OUT), U19.6 (OUT), U19.7 (OUT); also elsewhere on the board
/Output Driver 2/OutL: D24.2 (A), F11.1; also elsewhere on the board
/Output Driver 3/OutH: D29.1 (K), D30.1 (K), U21.5 (OUT), U21.6 (OUT), U21.7 (OUT); also elsewhere on the board
/Output Driver 3/OutL: D29.2 (A), F12.1; also elsewhere on the board
/Output Driver 4/OutH: D34.1 (K), D35.1 (K), U23.5 (OUT), U23.6 (OUT), U23.7 (OUT); also elsewhere on the board
/Output Driver 4/OutL: D34.2 (A), F13.1; also elsewhere on the board
/RPi_valve2: R106.2, R107.2; also elsewhere on the board
/RPi_valve3: R113.2, R114.2; also elsewhere on the board
/RPi_valve4: R120.2, R121.2; also elsewhere on the board
/~Valve2_Fault: R112.2, R117.1; also elsewhere on the board
/~Valve3_Fault: R125.2, R126.1; also elsewhere on the board
GNDPWR: C15.2, C17.2, C18.2, D25.2 (A), D30.2 (A), D35.2 (A), F11.2, F12.2, F13.2; also elsewhere on the board
unnamed: D21.2 (A), R109.1
unnamed: D26.2 (A), R116.1
unnamed: D31.2 (A), R123.1
unnamed: R107.1, R108.1, U18.1
unnamed: R109.2, U18.4, U19.3 (IN)
unnamed: R114.1, R115.1, U20.1
unnamed: R116.2, U20.4, U21.3 (IN)
unnamed: R117.2, R118.2, R119.2, U19.14 (CS)
unnamed: R121.1, R122.1, U22.1
unnamed: R123.2, U22.4, U23.3 (IN)
unnamed: R124.2, U19.13 (CL)
unnamed: R126.2, R208.2, R209.2, U21.14 (CS)
unnamed: R210.2, U21.13 (CL)
unnamed: R212.2, R213.2, R214.2, U23.14 (CS)
unnamed: R215.2, U23.13 (CL)

Notes on the sheet:
Protects MOSFET in case of supply overvoltage, or flyback diode failure
From Raspberry Pi
From CPLD
Series resistor protects against possible overvoltage from RPi failure
Option 1: AND (...1G08) Assumes safe valve state is closed; needs both inputs active to open - can't run respiration with only CPLD Option 2: OR (...1G32) Assumes safe valve state is open; can run respiration with only CPLD, unless RPi output is stuck high
Safety-combining logic
Power solenoid driver
Pull-up/down resistors select default state in case RPi loses power, leaves GPIO as input, or GPIO fails open
CL voltage threshold = 1.23V CL current = Iout/2000 +/- 20% 2.4K = 1.03A nom. limit, 0.82 - 1.23A range
Ics = Iout / 500 +/- 5% 853 mA = 2.56V 400 mA = 1.2V 100 mA = 0.3V
Fault voltage goes up to 4.9V; series resistor protects ADC input
For digital fault output, use TPS1H100A instead and populate these resistors
MAX 10 FPGA floats its pins during power-up and programming

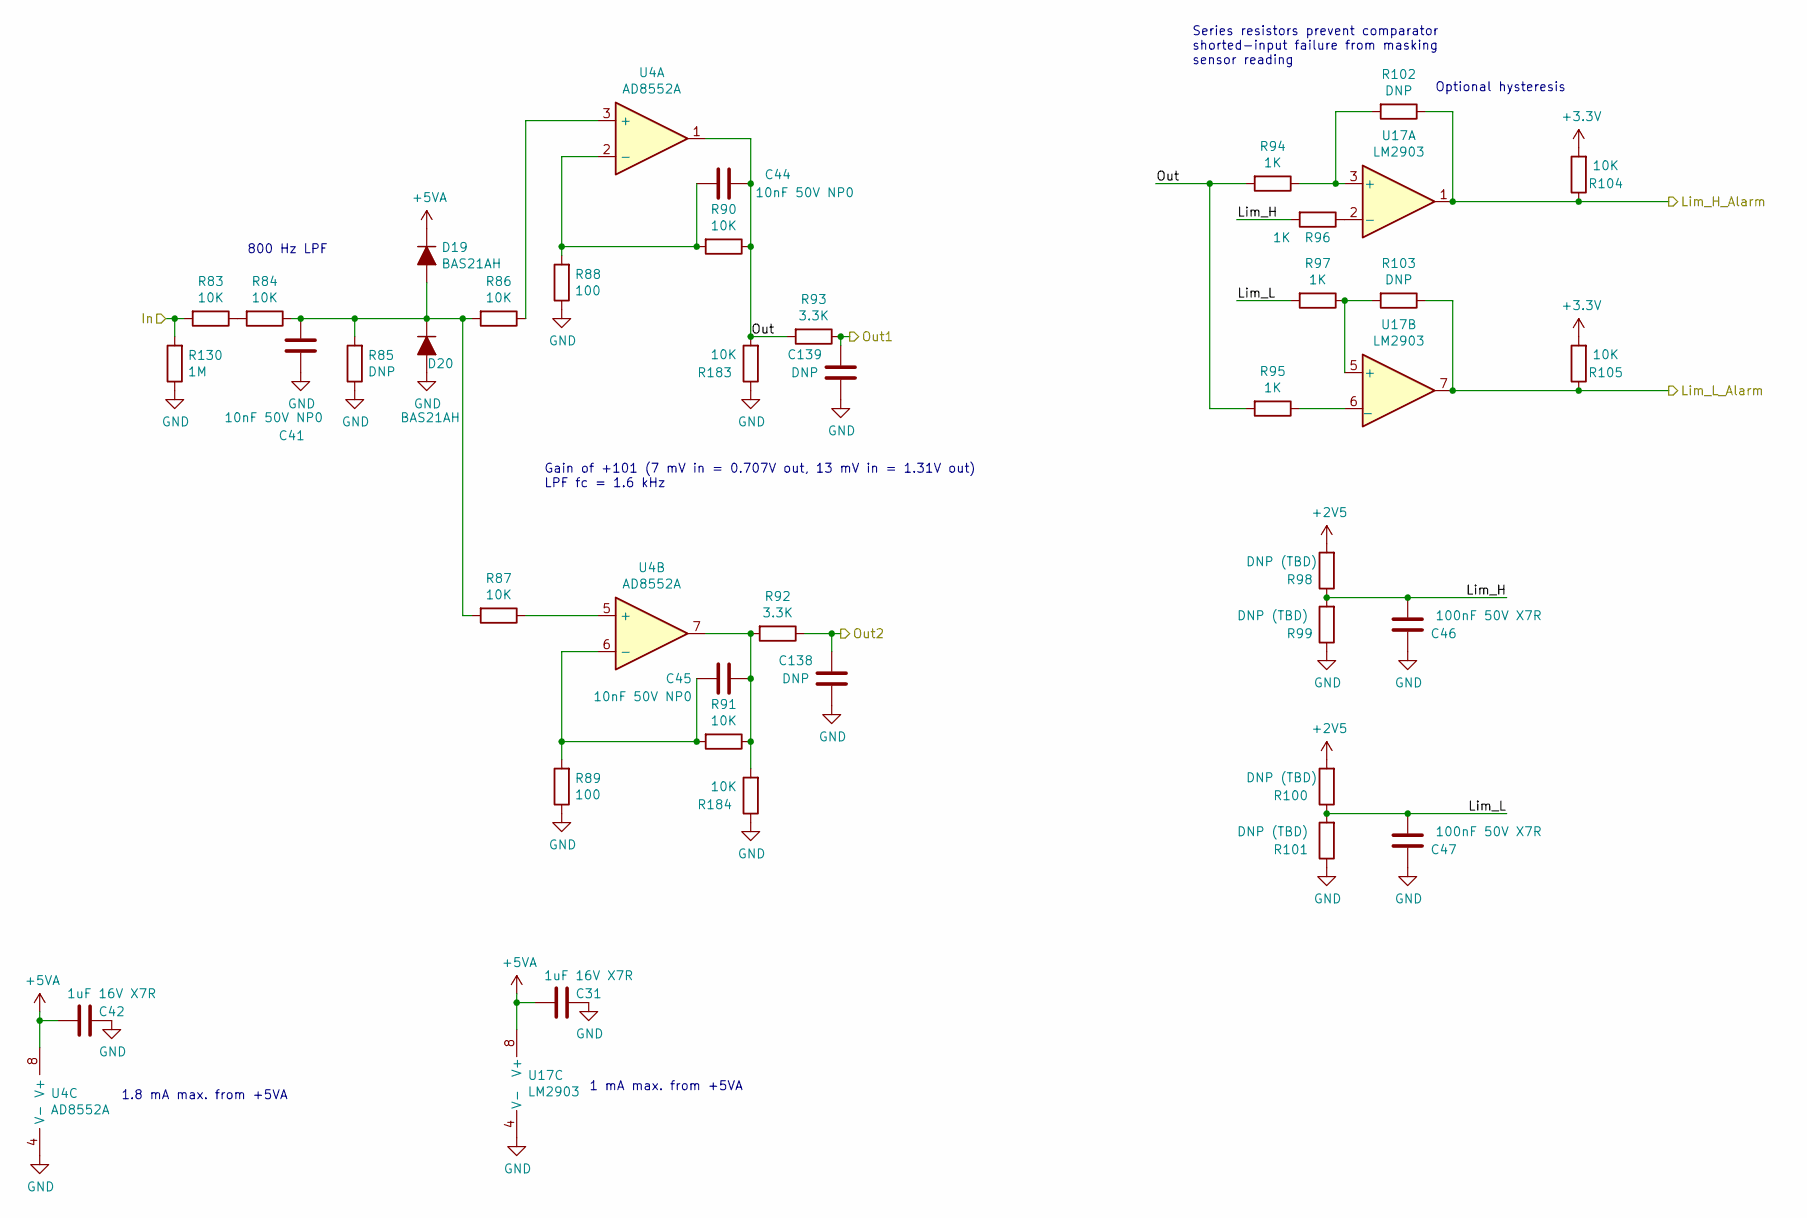
[picture p30: schematic sensor_input_lowlevel.sch, GlobalVent Stand-Alone Controller]

Parts:
C31, C42: 1uF 16V X7R; C_0805_2012Metric; Part Number C0805C105K4RACTU
C41, C44, C45: 10nF 50V NP0; C_0603_1608Metric; Part Number GRM1885C1H103JA01D
C46, C47: 100nF 50V X7R; C_0603_1608Metric; Part Number 06035C104JAT2A
C138, C139: DNP; C_0603_1608Metric
D19, D20: BAS21AH; D_SOD-323; Part Number BAS21AHT1G
R83, R84, R86, R87, R90, R91, R104, R105, R183, R184: 10K; R_1206_3216Metric; Part Number RK73H2BTTD1002F
R85, R102, R103: DNP; R_1206_3216Metric
R88, R89: 100; R_1206_3216Metric; Part Number RK73H2BTTD1000F
R92, R93: 3.3K; R_1206_3216Metric; Part Number RK73H2BTTD3301F
R94, R95, R96, R97: 1K; R_1206_3216Metric; Part Number RK73H2BTTD1001F
R98, R99, R100, R101: DNP (TBD); R_1206_3216Metric
R130: 1M; R_1206_3216Metric; Part Number RK73H2BTTD1004F
U4: AD8552A; SOIC-8_3.9x4.9mm_P1.27mm; Part Number AD8552ARZ-REEL
U17: LM2903; VSSOP-8_3.0x3.0mm_P0.65mm; Part Number LM2903DGKR

Connections:
+2V5: R98.2, R100.2; also elsewhere on the board
+3V3: R104.2, R105.2; also elsewhere on the board
/CPLD_ADC2: C138.2, R92.1; also elsewhere on the board
/O2_Lim_H_Alarm: R102.1, R104.1, U17.1; also elsewhere on the board
/O2_Lim_L_Alarm: R103.1, R105.1, U17.7; also elsewhere on the board
/Oxygen Sensor Input/In: R83.2, R130.2; also elsewhere on the board
/Oxygen Sensor Input/Lim_H: C46.2, R96.2, R98.1, R99.2
/Oxygen Sensor Input/Lim_L: C47.2, R97.2, R100.1, R101.2
/Oxygen Sensor Input/Out: C44.1, R90.1, R93.2, R94.2, R95.2, R183.2, U4.1
/RPi_ADC2: C139.2, R93.1; also elsewhere on the board
unnamed: C41.2, D19.2 (A), D20.1 (K), R84.1, R85.2, R86.2, R87.2
unnamed: C44.2, R88.2, R90.2, U4.2 (-)
unnamed: C45.1, R91.1, R92.2, R184.2, U4.7
unnamed: C45.2, R89.2, R91.2, U4.6 (-)
unnamed: R83.1, R84.2
unnamed: R86.1, U4.3 (+)
unnamed: R87.1, U4.5 (+)
unnamed: R95.1, U17.6 (_)
unnamed: R96.1, U17.2 (-)
unnamed: R94.1, R102.2, U17.3 (+)
unnamed: R97.1, R103.2, U17.5 (+)

Notes on the sheet:
Gain of +101 (7 mV in = 0.707V out, 13 mV in = 1.31V out) LPF fc = 1.6 kHz
Series resistors prevent comparator shorted-input failure from masking sensor reading
Optional hysteresis
1.8 mA max. from +5VA
1 mA max. from +5VA
800 Hz LPF
