GlobalVent/electronics/RPi_cape/RPi_cape.kicad_pcb

## KiCad design RPi_cape/RPi_cape.kicad_pcb (continued)

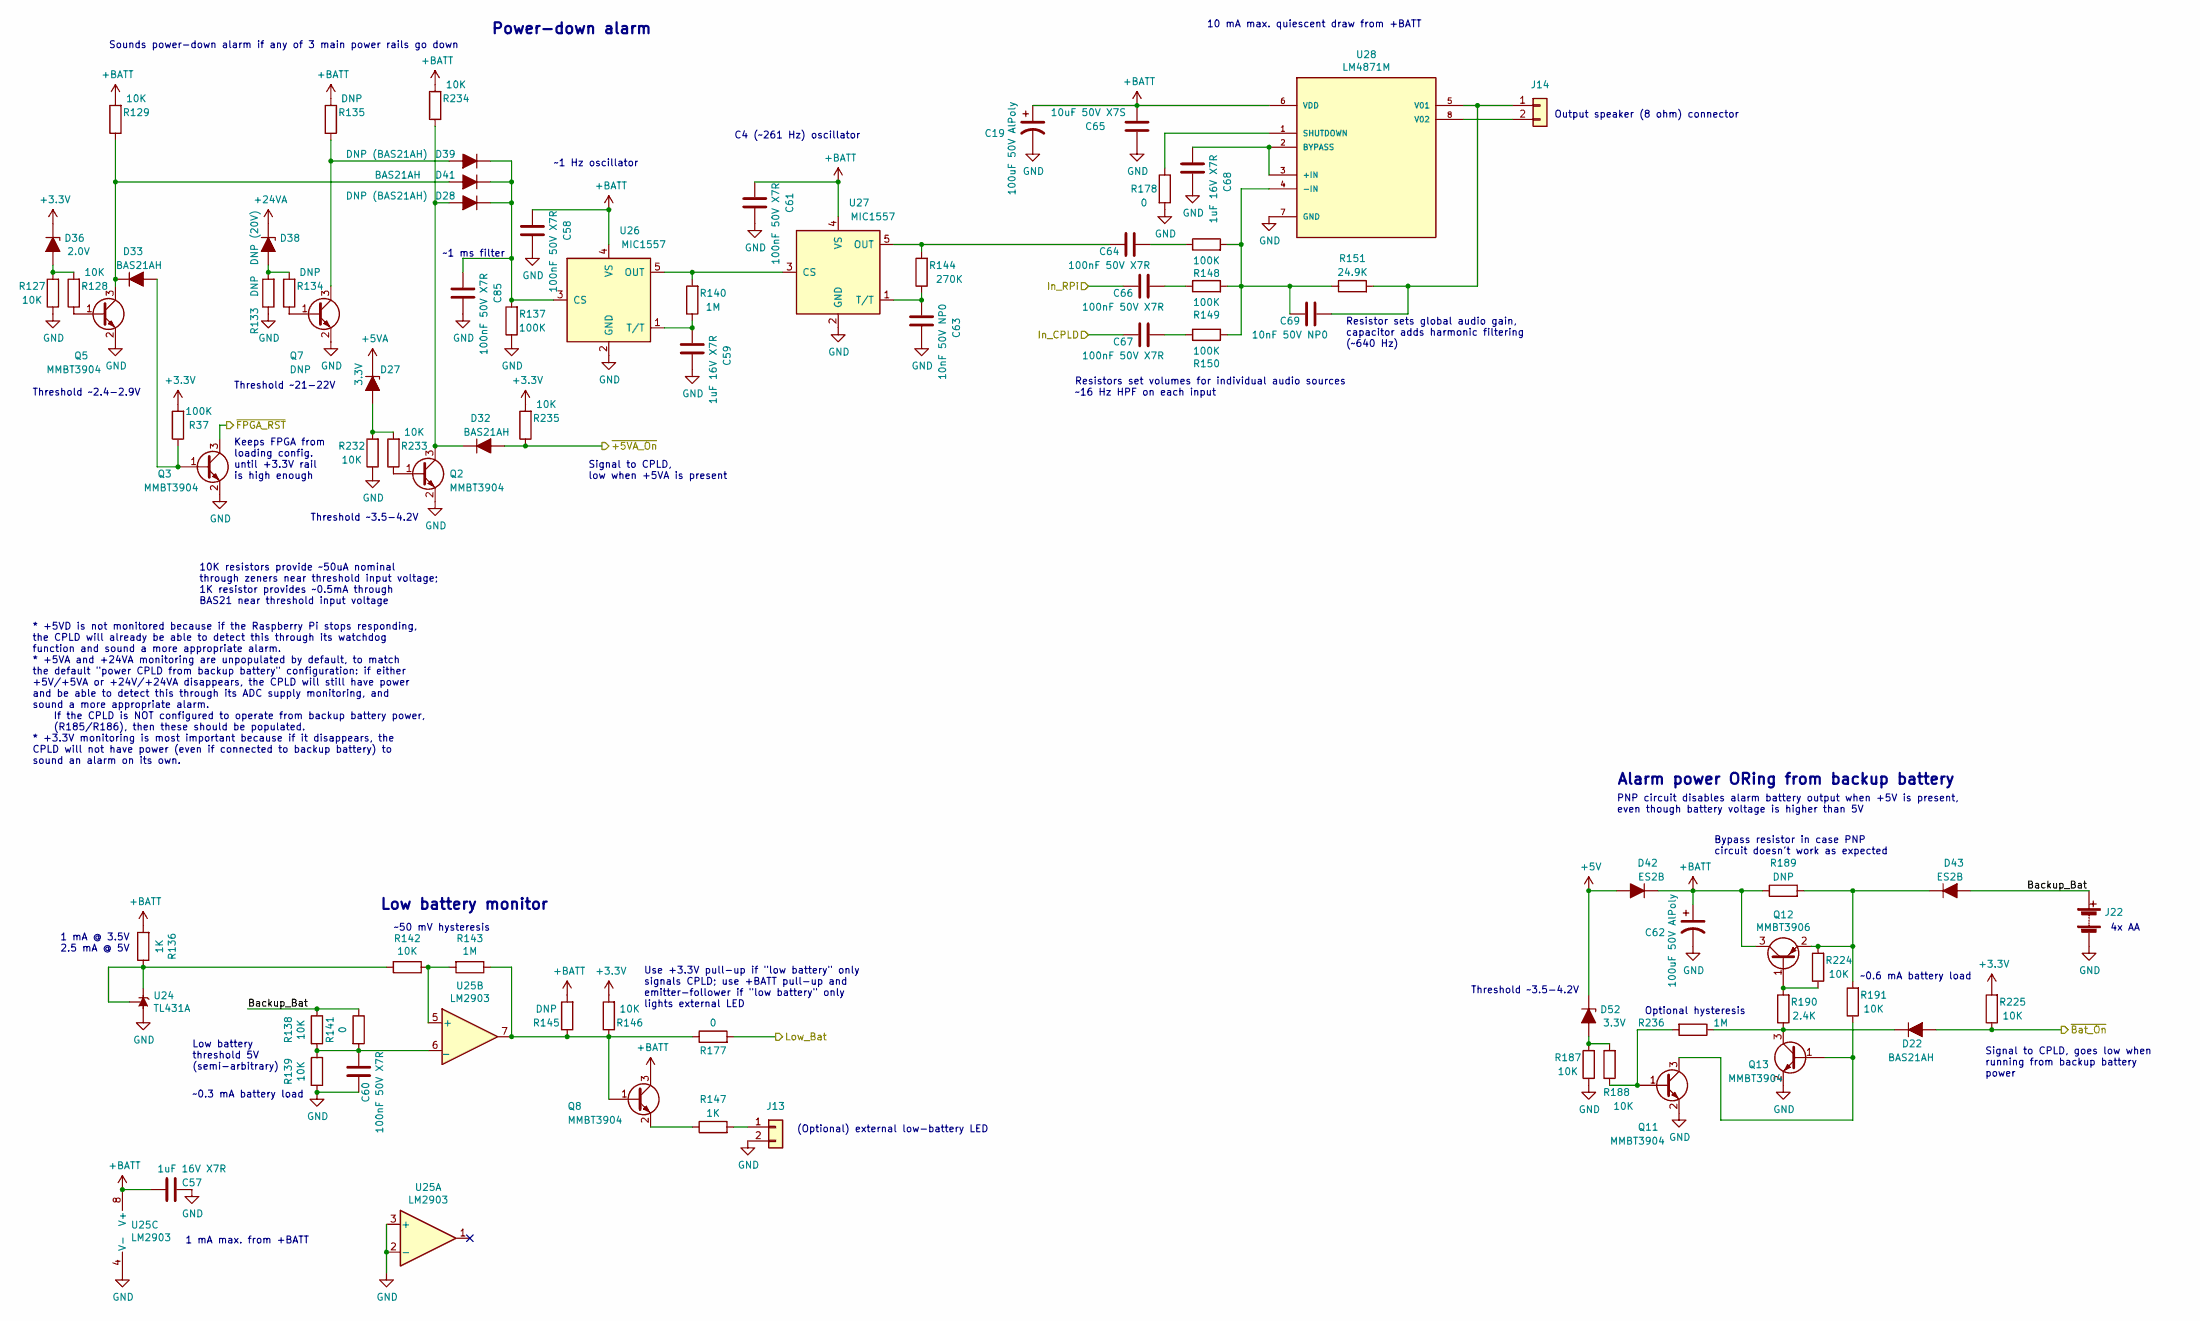
[picture p31: schematic audio_alarm.sch, GlobalVent Stand-Alone Controller]

Parts:
C19, C62: 100uF 50V AlPoly; CP_Elec_10x10.5; Part Number EEH-ZC1H101P
C57, C59, C68: 1uF 16V X7R; C_0805_2012Metric; Part Number C0805C105K4RACTU
C58, C60, C61, C64, C66, C67, C85: 100nF 50V X7R; C_0603_1608Metric; Part Number 06035C104JAT2A
C63, C69: 10nF 50V NP0; C_0603_1608Metric; Part Number GRM1885C1H103JA01D
C65: 10uF 50V X7S; C_1210_3225Metric; Part Number GCM32EC71H106KA03L
D22, D32, D33, D41: BAS21AH; D_SOD-323; Part Number BAS21AHT1G
D27, D52: 3.3V; D_SOD-123; Part Number MMSZ4684T1G
D28, D39: DNP (BAS21AH); D_SOD-323; Part Number BAS21AHT1G
D36: 2.0V; D_SOD-123; Part Number MMSZ4679T1G
D38: DNP (20V); D_SOD-123; Part Number MMSZ4707T1G
D42, D43: ES2B; D_SMA; Part Number ES2G-E3/52T
J13, J14: Conn_01x02; Connector_Spring_Phoenix_1985195; Part Number 1985195
J22: Conn_01x02; Connector_Spring_Phoenix_1985195; Part Number 9185195
Q2, Q3, Q5, Q8, Q11, Q13: MMBT3904; SOT-23; Part Number MMBT3904-7-F
Q7: DNP; SOT-23
Q12: MMBT3906; SOT-23; Part Number MMBT3906,215
R37, R137, R148, R149, R150: 100K; R_1206_3216Metric; Part Number RK73H2BTTD1003F
R127, R128, R129, R138, R139, R142, R146, R187, R188, R191, R224, R225, R232, R233, R234, R235: 10K; R_1206_3216Metric; Part Number RK73H2BTTD1002F
R133, R134, R135, R145, R189: DNP; R_1206_3216Metric
R136, R147: 1K; R_1206_3216Metric; Part Number RK73H2BTTD1001F
R140, R143, R236: 1M; R_1206_3216Metric; Part Number RK73H2BTTD1004F
R141, R177, R178: 0; R_1206_3216Metric; Part Number ERJ-8GEY0R00V
R144: 270K; R_1206_3216Metric; Part Number RK73H2BTTD2703F
R151: 24.9K; R_1206_3216Metric; Part Number RK73H2BTTD2492F
R190: 2.4K; R_1206_3216Metric; Part Number RK73H2BTTD2401F
U24: TL431A; SOT-23; Part Number TL431AQDBZR,215
U25: LM2903; VSSOP-8_3.0x3.0mm_P0.65mm; Part Number LM2903DGKR
U26, U27: MIC1557; SOT-23-5; Part Number MIC1557YM5-TR
U28: LM4871M; SOIC-8_3.9x4.9mm_P1.27mm; Part Number LM4871MX/NOPB

Connections:
+3V3: D36.1 (K), R37.2, R146.2, R225.2, R235.2; also elsewhere on the board
+5V: D42.2 (A), D52.1 (K); also elsewhere on the board
+24VA: D38.1 (K); also elsewhere on the board
+BATT: C19.1, C57.2, C58.2, C61.2, C62.1, C65.1, D42.1 (K), Q8.3 (C), Q12.3 (C), R129.2, R135.2, R136.2, R145.2, R189.1, R234.2, U25.8 (V+), U26.4 (VS), U27.4 (VS), U28.6 (VDD); also elsewhere on the board
/Auditory Alarm/Backup_Bat: D43.2 (A), J22.1 (+), R138.1, R141.1
/Auditory Alarm/Low_Bat: R177.2; also elsewhere on the board
/Auditory Alarm/~+5VA_On: D32.2 (A), R235.1; also elsewhere on the board
/Auditory Alarm/~Bat_On: D22.2 (A), R225.1; also elsewhere on the board
/Auditory Alarm/~FPGA_RST: Q3.3 (C); also elsewhere on the board
/CPLD_Alarm_Spkr: C67.1; also elsewhere on the board
/RPi_Alarm_Spkr: C66.1; also elsewhere on the board
unnamed: C59.2, R140.1, U26.1 (T/T)
unnamed: C60.2, R138.2, R139.1, R141.2, U25.6 (_)
unnamed: C63.2, R144.1, U27.1 (T/T)
unnamed: C64.1, R144.2, U27.5 (OUT)
unnamed: C64.2, R148.1
unnamed: C66.2, R149.1
unnamed: C67.2, R150.1
unnamed: C68.2, U28.2 (BYPASS), U28.3 (+IN)
unnamed: C69.1, R148.2, R149.2, R150.2, R151.1, U28.4 (-IN)
unnamed: C69.2, J14.1, R151.2, U28.5 (V01)
unnamed: C85.2, D28.1 (K), D39.1 (K), D41.1 (K), R137.2, U26.3 (CS)
unnamed: D22.1 (K), Q13.3 (C), R190.1, R236.1
unnamed: D27.2 (A), R232.2, R233.2
unnamed: D28.2 (A), D32.1 (K), Q2.3 (C), R234.1
unnamed: D33.1 (K), D41.2 (A), Q5.3 (C), R129.1
unnamed: D33.2 (A), Q3.1 (B), R37.1
unnamed: D36.2 (A), R127.2, R128.2
unnamed: D38.2 (A), R133.2, R134.2
unnamed: D39.2 (A), Q7.3 (C), R135.1
unnamed: D43.1 (K), Q12.2 (E), R189.2, R191.2, R224.2
unnamed: D52.2 (A), R187.2, R188.2
unnamed: J13.1, R147.2
unnamed: J14.2, U28.8 (V02)
unnamed: Q2.1 (B), R233.1
unnamed: Q5.1 (B), R128.1
unnamed: Q7.1 (B), R134.1
unnamed: Q8.1 (B), R143.1, R145.1, R146.1, R177.1, U25.7
unnamed: Q8.2 (E), R147.1
unnamed: Q11.1 (B), R188.1, R236.2
unnamed: Q11.3 (C), Q13.1 (B), R191.1
unnamed: Q12.1 (B), R190.2, R224.1
unnamed: R136.1, R142.2, U24.1 (K), U24.2 (REF)
unnamed: R140.2, U26.5 (OUT), U27.3 (CS)
unnamed: R142.1, R143.2, U25.5 (+)
unnamed: R178.1, U28.1 (SHUTDOWN)

Notes on the sheet:
1 mA max. from +BATT
1 mA @ 3.5V 2.5 mA @ 5V
Power-down alarm
Low battery monitor
Output speaker (8 ohm) connector
Resistors set volumes for individual audio sources ~~16 Hz HPF on each input
Resistor sets global audio gain, capacitor adds harmonic filtering (~~640 Hz)
C4 (~~261 Hz) oscillator
~~1 Hz oscillator
Threshold ~~2.4-2.9V
Threshold ~~21-22V
Sounds power-down alarm if any of 3 main power rails go down
Low battery threshold 5V (semi-arbitrary)
Alarm power ORing from backup battery
~~50 mV hysteresis
(Optional) external low-battery LED
Use +3.3V pull-up if "low battery" only signals CPLD; use +BATT pull-up and emitter-follower if "low battery" only lights external LED
Bypass resistor in case PNP circuit doesn't work as expected
PNP circuit disables alarm battery output when +5V is present, even though battery voltage is higher than 5V
Threshold ~~3.5-4.2V
* +5VD is not monitored because if the Raspberry Pi stops responding, the CPLD will already be able to detect this through its watchdog function and sound a more appropriate alarm. * +5VA and +24VA monitoring are unpopulated by default, to match the default "power CPLD from backup battery" configur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
10 mA max. quiescent draw from +BATT
~~0.6 mA battery load
~~0.3 mA battery load
Signal to CPLD, goes low when running from backup battery power
10K resistors provide ~~50uA nominal through zeners near threshold input voltage; 1K resistor provides ~~0.5mA through BAS21 near threshold input voltage
Signal to CPLD, low when +5VA is present
Optional hysteresis
~~1 ms filter
Keeps FPGA from loading config. until +3.3V rail is high enough
4x AA

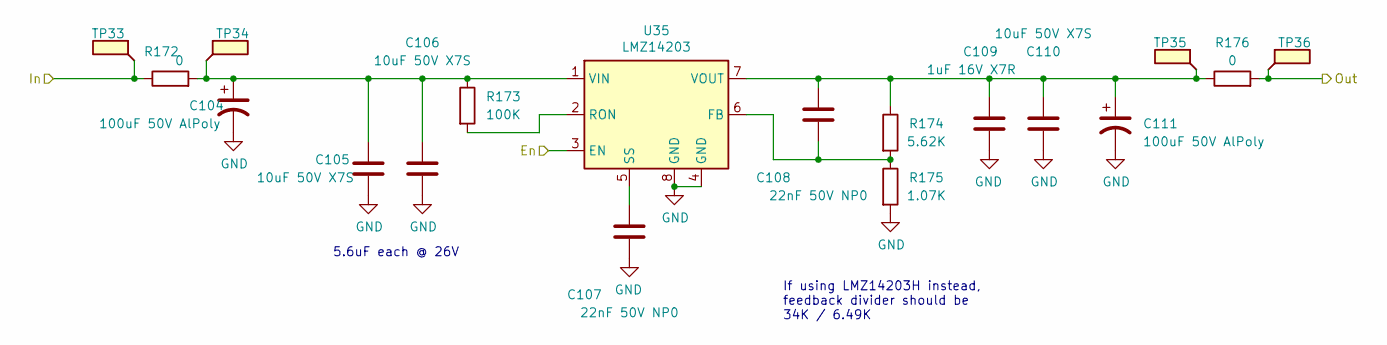
[picture p32: schematic 5V_reg.sch, GlobalVent Stand-Alone Controller]

Parts:
C96, C103: 100uF 50V AlPoly; CP_Elec_10x10.5; Part Number EEH-ZC1H101P
C97, C98, C102: 10uF 50V X7S; C_1210_3225Metric; Part Number GCM32EC71H106KA03L
C99, C100: 22nF 50V NP0; C_0805_2012Metric; Part Number GCM21B5C1H223JA16L
C101: 1uF 16V X7R; C_0805_2012Metric; Part Number C0805C105K4RACTU
R167, R171: 0; R_1206_3216Metric; Part Number ERJ-8GEY0R00V
R168: 100K; R_1206_3216Metric; Part Number RK73H2BTTD1003F
R169: 5.62K; R_1206_3216Metric; Part Number RK73H2BTTD5621F
R170: 1.07K; R_1206_3216Metric; Part Number RK73H2BTTD1071F
TP29, TP30, TP31, TP32: TestPoint_Flag; TestPoint_Keystone_5019_Minature; Part Number 5019
U34: LMZ14203; TI_TO-PMOD-7; Part Number LMZ14203TZX-ADJ/NOPB

Connections:
+5VD: R171.2, TP32.1; also elsewhere on the board
+24V: R167.1, TP29.1; also elsewhere on the board
/RPi_En: U34.3 (EN); also elsewhere on the board
unnamed: C96.1, C97.1, C98.1, R167.2, R168.1, TP30.1, U34.1 (VIN)
unnamed: C99.2, U34.5 (SS)
unnamed: C100.1, R169.2, R170.1, U34.6 (FB)
unnamed: C100.2, C101.2, C102.1, C103.1, R169.1, R171.1, TP31.1, U34.7 (VOUT)
unnamed: R168.2, U34.2 (RON)

Parts of its further copies:
C104, C111: 100uF 50V AlPoly; CP_Elec_10x10.5; Part Number EEH-ZC1H101P
C105, C106, C110: 10uF 50V X7S; C_1210_3225Metric; Part Number GCM32EC71H106KA03L
C107, C108: 22nF 50V NP0; C_0805_2012Metric; Part Number GCM21B5C1H223JA16L
C109: 1uF 16V X7R; C_0805_2012Metric; Part Number C0805C105K4RACTU
R172, R176: 0; R_1206_3216Metric; Part Number ERJ-8GEY0R00V
R173: 100K; R_1206_3216Metric; Part Number RK73H2BTTD1003F
R174: 5.62K; R_1206_3216Metric; Part Number RK73H2BTTD5621F
R175: 1.07K; R_1206_3216Metric; Part Number RK73H2BTTD1071F
TP33, TP34, TP35, TP36: TestPoint_Flag; TestPoint_Keystone_5019_Minature; Part Number 5019
U35: LMZ14203; TI_TO-PMOD-7; Part Number LMZ14203TZX-ADJ/NOPB

Connections of its further copies:
+5V: R176.2, TP36.1; also elsewhere on the board
+24V: R172.1, TP33.1; also elsewhere on the board
/5V Regulator (other)/En: U35.3 (EN); also elsewhere on the board
unnamed: C104.1, C105.1, C106.1, R172.2, R173.1, TP34.1, U35.1 (VIN)
unnamed: C107.2, U35.5 (SS)
unnamed: C108.1, R174.2, R175.1, U35.6 (FB)
unnamed: C108.2, C109.2, C110.1, C111.1, R174.1, R176.1, TP35.1, U35.7 (VOUT)
unnamed: R173.2, U35.2 (RON)

Notes on the sheet:
If using LMZ14203H instead, feedback divider should be 34K / 6.49K
5.6uF each @ 26V

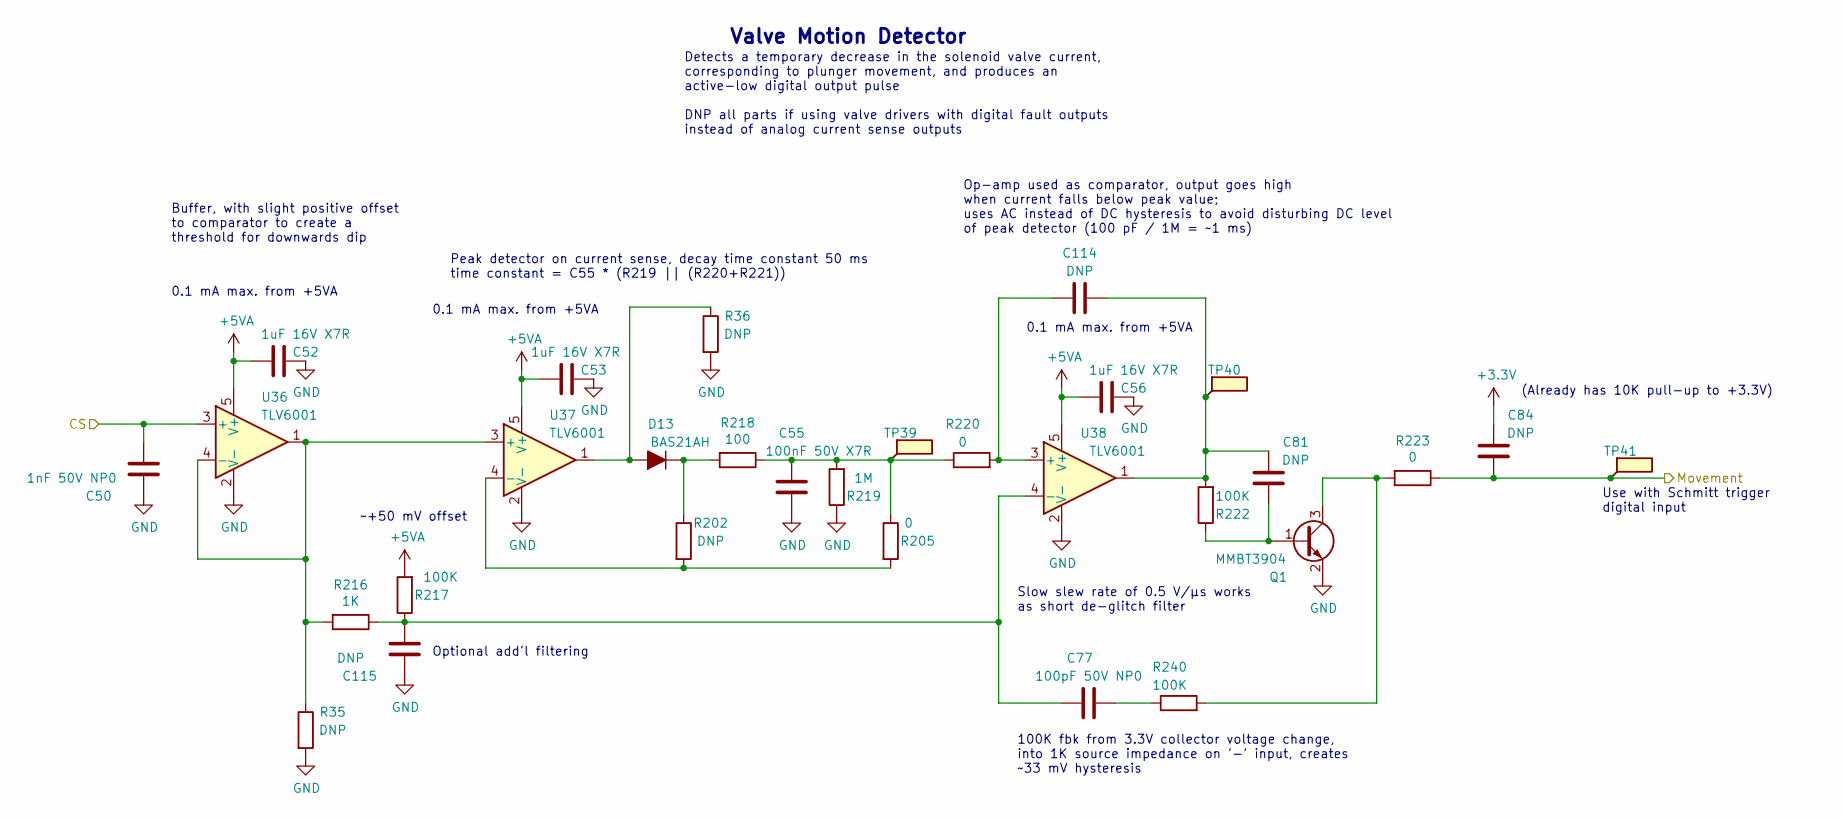
[picture p33: schematic valve_detect.sch, GlobalVent Stand-Alone Controller]

Parts:
C50: 1nF 50V NP0; C_0603_1608Metric; Part Number 06035A102JAT2A
C52, C55: 1uF 16V X7R; C_0805_2012Metric; Part Number C0805C105K4RACTU
C53: 100nF 50V X7R; C_0603_1608Metric; Part Number 06035C104JAT2A
C56, C81, C114, C115: DNP; C_0603_1608Metric
C77: 100pF 50V NP0; C_0603_1608Metric; Part Number C0603C101J5GACTU
D13: BAS21AH; D_SOD-323; Part Number BAS21AHT1G
Q1: MMBT3904; SOT-23; Part Number MMBT3904-7-F
R35, R36, R202: DNP; R_1206_3216Metric
R205, R219, R220: 0; R_1206_3216Metric; Part Number ERJ-8GEY0R00V
R216: 100; R_1206_3216Metric; Part Number RK73H2BTTD1000F
R217: 1M; R_1206_3216Metric; Part Number RK73H2BTTD1004F
R218, R240: 100K; R_1206_3216Metric; Part Number RK73H2BTTD1003F
TP39, TP40, TP41: TestPoint_Flag; TestPoint_Keystone_5019_Minature; Part Number 5019
U36, U37: TLV6001; SOT-23-5; Part Number TLV6001IDBVR

Connections:
unnamed: C77.2, R240.1

Parts of its further copies:
C84: DNP; C_0603_1608Metric
R222: 100K; R_1206_3216Metric; Part Number RK73H2BTTD1003F
R223: 0; R_1206_3216Metric; Part Number ERJ-8GEY0R00V
U38: TLV6001; SOT-23-5; Part Number TLV6001IDBVR

Connections of its further copies:
+3V3: C84.1; also elsewhere on the board

Notes on the sheet:
0.1 mA max. from +5VA
Detects a temporary decrease in the solenoid valve current, corresponding to plunger movement, and produces an active-low digital output pulse DNP all parts if using valve drivers with digital fault outputs instead of analog current sense outputs
Use with Schmitt trigger digital input
Peak detector on current sense, decay time constant 50 ms time constant = C55 * (R219 || (R220+R221))
Op-amp used as comparator, output goes high when current falls below peak value; uses AC instead of DC hysteresis to avoid disturbing DC level of peak detector (100 pF / 1M = ~~1 ms)
Buffer, with slight positive offset to comparator to create a threshold for downwards dip
~~+50 mV offset
Valve Motion Detector
(Already has 10K pull-up to +3.3V)
Optional add'l filtering
Slow slew rate of 0.5 V/µs works as short de-glitch filter
100K fbk from 3.3V collector voltage change, into 1K source impedance on '-' input, creates ~~33 mV hysteresis

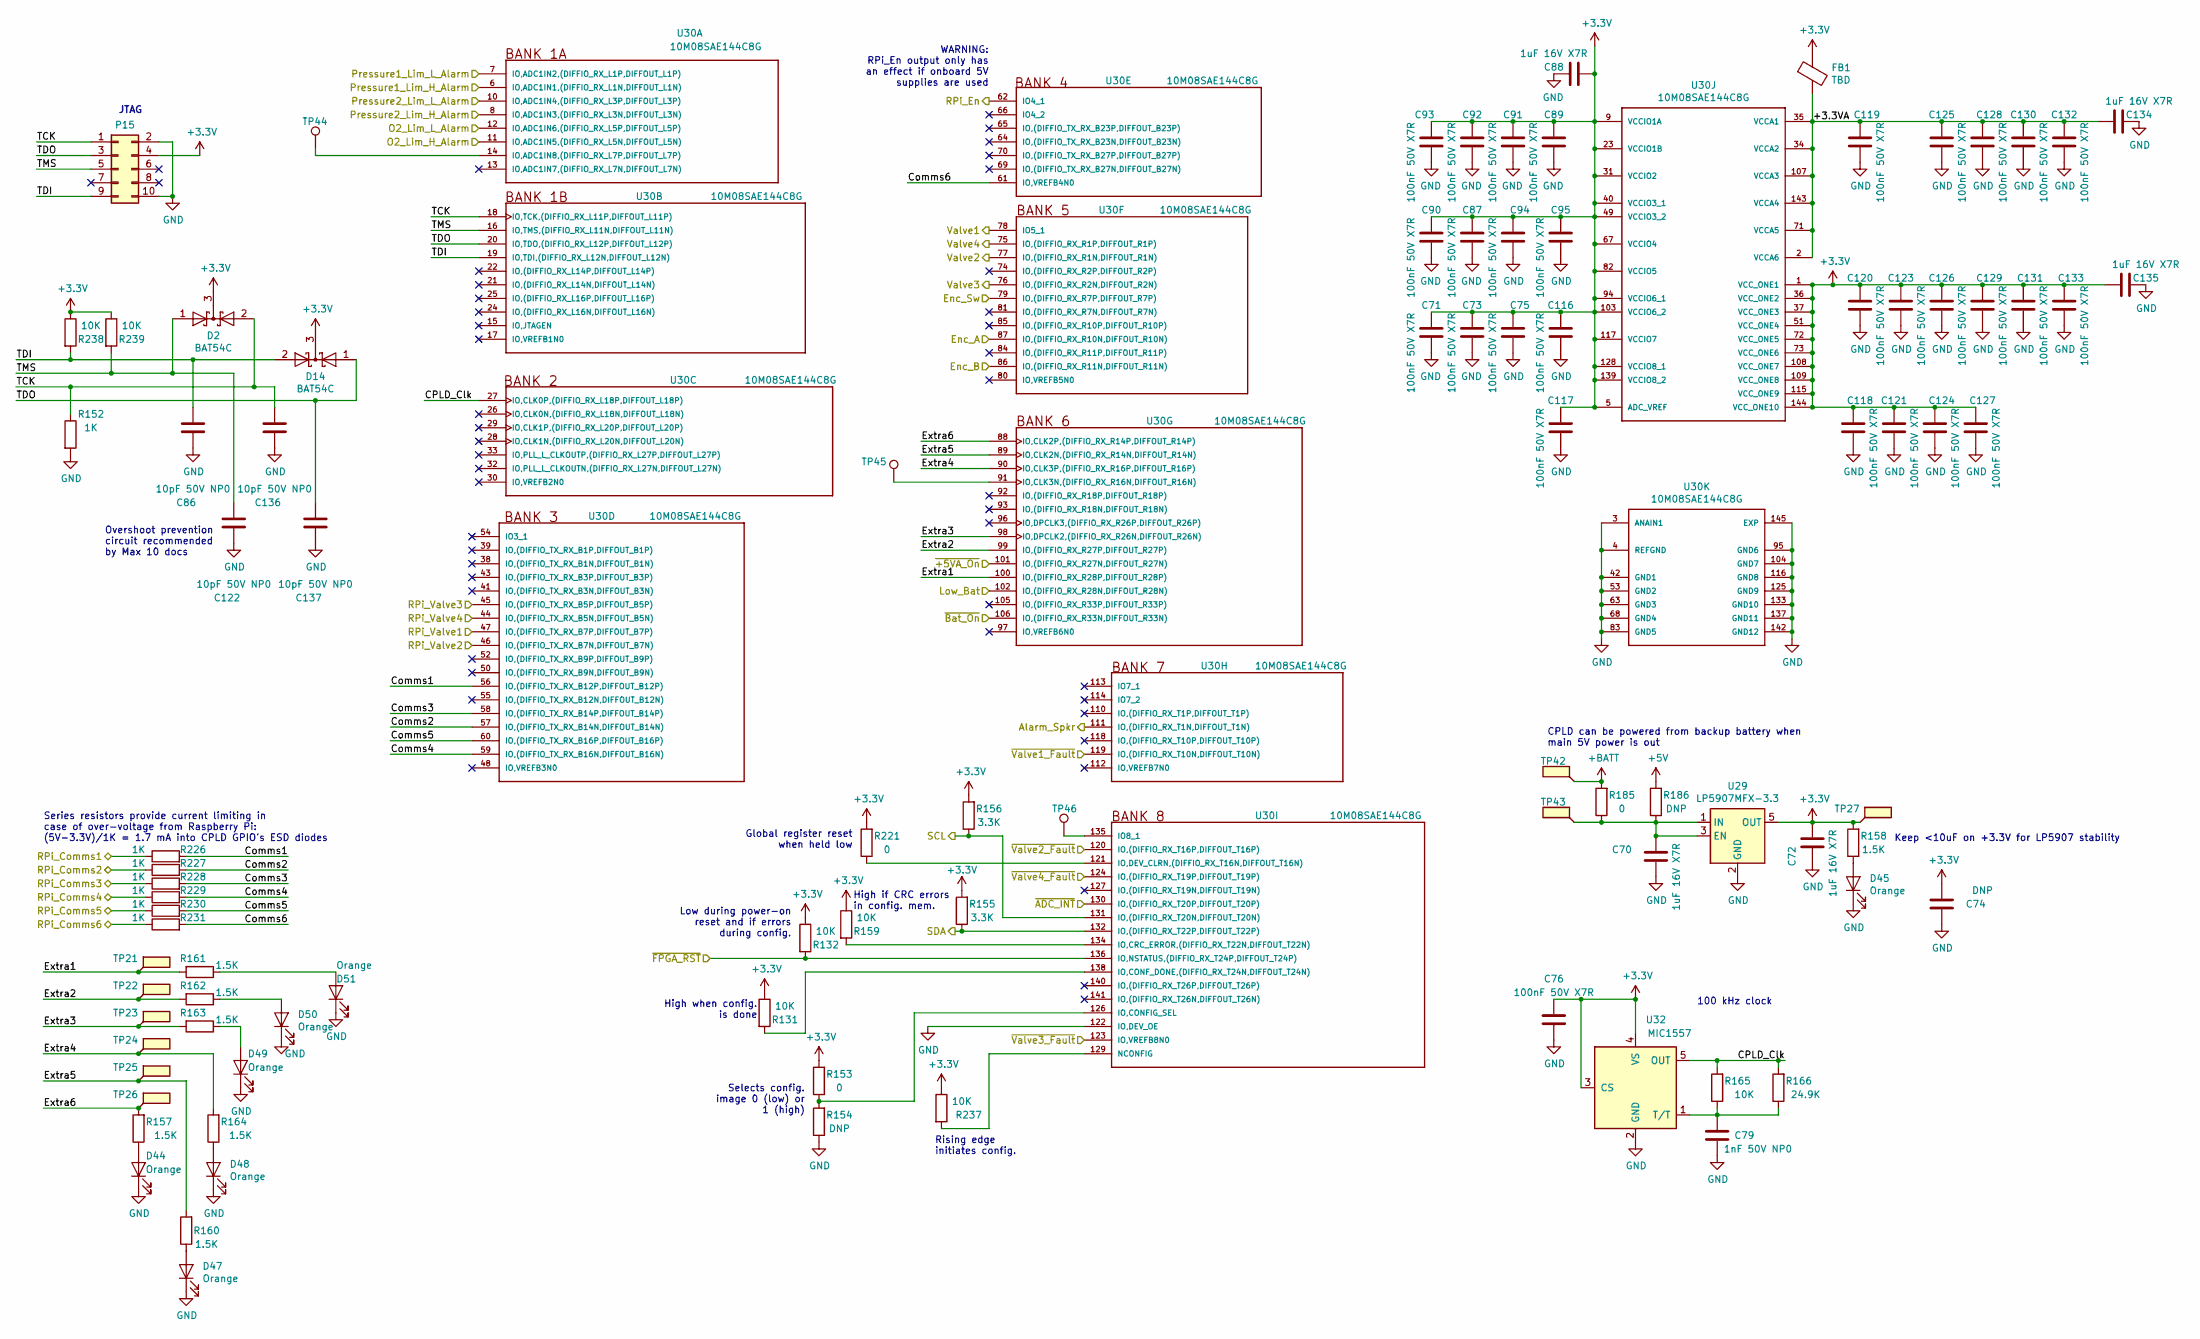
[picture p34: schematic cpld.sch, GlobalVent Stand-Alone Controller]

Parts:
C70, C72, C88, C134, C135: 1uF 16V X7R; C_0805_2012Metric; Part Number C0805C105K4RACTU
C71, C73, C75, C76, C87, C89, C90, C91, C92, C93, C94, C95, C116, C117, C118, C119, C120, C121, C123, C124, C125, C126, C127, C128, C129, C130, C131, C132, C133: 100nF 50V X7R; C_0603_1608Metric; Part Number 06035C104JAT2A
C74: DNP; C_1210_3225Metric
C79: 1nF 50V NP0; C_0603_1608Metric; Part Number 06035A102JAT2A
C86, C122, C136, C137: 10pF 50V NP0; C_0603_1608Metric
D2, D14: BAT54C; SOT-23; Part Number BAT54C-7-F
D44, D45, D47, D48, D49, D50, D51: Orange; LED_0805_2012Metric; Part Number HSMD-C170
FB1: TBD; L_0805_2012Metric
P15: Conn_02x05_Odd_Even; PinHeader_2x05_P2.54mm_Vertical
R131, R132, R159, R165, R237, R238, R239: 10K; R_1206_3216Metric; Part Number RK73H2BTTD1002F
R152, R226, R227, R228, R229, R230, R231: 1K; R_1206_3216Metric; Part Number RK73H2BTTD1001F
R153, R185, R221: 0; R_1206_3216Metric; Part Number ERJ-8GEY0R00V
R154, R186: DNP; R_1206_3216Metric
R155, R156: 3.3K; R_1206_3216Metric; Part Number RK73H2BTTD3301F
R157, R158, R160, R161, R162, R163, R164: 1.5K; R_1206_3216Metric; Part Number RK73H2BTTD1501F
R166: 24.9K; R_1206_3216Metric; Part Number RK73H2BTTD2492F
TP21, TP22, TP23, TP24, TP25, TP26, TP27, TP42, TP43: TestPoint_Flag; TestPoint_Keystone_5019_Minature; Part Number 5019
TP44, TP45, TP46: TestPoint; TestPoint_Pad_1.0x1.0mm
U29: LP5907MFX-3.3; SOT-23-5; Part Number LP5907MFX-3.3/NOPB
U30: 10M08SAE144C8G; LQFP50P2200X2200X160-145N; Part Number 10M08SAE144C8G
U32: MIC1557; SOT-23-5; Part Number MIC1557YM5-TR

Connections:
+3V3: C71.2, C72.2, C73.2, C74.1, C75.2, C76.2, C87.2, C88.2, C89.2, C90.2, C91.2, C92.2, C93.2, C94.2, C95.2, C116.2, C117.2, C118.2, C120.2, C121.2, C123.2, C124.2, C126.2, C127.2, C129.2, C131.2, C133.2, C135.2, D2.3 (K), D14.3 (K), FB1.1, P15.4, R131.1, R132.1, R153.2, R155.2, R156.2, R158.2, R159.1, R221.2, R237.1, R238.1, R239.1, TP27.1, U29.5 (OUT), U30.1 (VCC_ONE1), U30.5 (ADC_VREF), U30.9 (VCCIO1A), U30.23 (VCCIO1B), U30.31 (VCCIO2), U30.36 (VCC_ONE2), U30.37 (VCC_ONE3), U30.40 (VCCIO3_1), U30.49 (VCCIO3_2), U30.51 (VCC_ONE4), U30.67 (VCCIO4), U30.72 (VCC_ONE5), U30.73 (VCC_ONE6), U30.82 (VCCIO5), U30.94 (VCCIO6_1), U30.103 (VCCIO6_2), U30.108 (VCC_ONE7), U30.109 (VCC_ONE8), U30.115 (VCC_ONE9), U30.117 (VCCIO7), U30.128 (VCCIO8_1), U30.139 (VCCIO8_2), U30.144 (VCC_ONE10), U32.3 (CS), U32.4 (VS); also elsewhere on the board
+5V: R186.2; also elsewhere on the board
+BATT: R185.2, TP42.1; also elsewhere on the board
/Auditory Alarm/Low_Bat: U30.102 (IO,(DIFFIO_RX_R28N,DIFFOUT_R28N)); also elsewhere on the board
/Auditory Alarm/~+5VA_On: U30.101 (IO,(DIFFIO_RX_R27N,DIFFOUT_R27N)); also elsewhere on the board
/Auditory Alarm/~Bat_On: U30.106 (IO,(DIFFIO_RX_R33N,DIFFOUT_R33N)); also elsewhere on the board
/Auditory Alarm/~FPGA_RST: R132.2, U30.136 (IO,NSTATUS,(DIFFIO_RX_T24P,DIFFOUT_T24P)); also elsewhere on the board
/CPLD/+3.3VA: C119.2, C125.2, C128.2, C130.2, C132.2, C134.2, FB1.2, U30.2 (VCCA6), U30.34 (VCCA2), U30.35 (VCCA1), U30.71 (VCCA5), U30.107 (VCCA3), U30.143 (VCCA4)
/CPLD/CPLD_Clk: R165.2, R166.2, U30.27 (IO,CLK0P,(DIFFIO_RX_L18P,DIFFOUT_L18P)), U32.5 (OUT)
/CPLD/Comms1: R226.2, U30.56 (IO,(DIFFIO_TX_RX_B12P,DIFFOUT_B12P))
/CPLD/Comms2: R227.2, U30.57 (IO,(DIFFIO_TX_RX_B14N,DIFFOUT_B14N))
/CPLD/Comms3: R228.2, U30.58 (IO,(DIFFIO_TX_RX_B14P,DIFFOUT_B14P))
/CPLD/Comms4: R229.2, U30.59 (IO,(DIFFIO_TX_RX_B16N,DIFFOUT_B16N))
/CPLD/Comms5: R230.2, U30.60 (IO,(DIFFIO_TX_RX_B16P,DIFFOUT_B16P))
/CPLD/Comms6: R231.2, U30.61 (IO,VREFB4N0)
/CPLD/Extra1: R161.2, TP21.1, U30.100 (IO,(DIFFIO_RX_R28P,DIFFOUT_R28P))
/CPLD/Extra2: R162.2, TP22.1, U30.99 (IO,(DIFFIO_RX_R27P,DIFFOUT_R27P))
/CPLD/Extra3: R163.2, TP23.1, U30.98 (IO,DPCLK2,(DIFFIO_RX_R26N,DIFFOUT_R26N))
/CPLD/Extra4: R164.2, TP24.1, U30.90 (IO,CLK3P,(DIFFIO_RX_R16P,DIFFOUT_R16P))
/CPLD/Extra5: R160.2, TP25.1, U30.89 (IO,CLK2N,(DIFFIO_RX_R14N,DIFFOUT_R14N))
/CPLD/Extra6: R157.2, TP26.1, U30.88 (IO,CLK2P,(DIFFIO_RX_R14P,DIFFOUT_R14P))
/CPLD/TCK: C136.2, D2.2 (A), P15.1, R152.1, U30.18 (IO,TCK,(DIFFIO_RX_L11P,DIFFOUT_L11P))
/CPLD/TDI: C86.2, D14.2 (A), P15.9, R238.2, U30.19 (IO,TDI,(DIFFIO_RX_L12N,DIFFOUT_L12N))
/CPLD/TDO: C137.2, D14.1 (A), P15.3, U30.20 (IO,TDO,(DIFFIO_RX_L12P,DIFFOUT_L12P))
/CPLD/TMS: C122.2, D2.1 (A), P15.5, R239.2, U30.16 (IO,TMS,(DIFFIO_RX_L11N,DIFFOUT_L11N))
/CPLD/~ADC_INT: U30.130 (IO,(DIFFIO_RX_T20P,DIFFOUT_T20P)); also elsewhere on the board
/CPLD_Alarm_Spkr: U30.111 (IO,(DIFFIO_RX_T1N,DIFFOUT_T1N)); also elsewhere on the board
/CPLD_SCL: R156.1, U30.131 (IO,(DIFFIO_RX_T20N,DIFFOUT_T20N)); also elsewhere on the board
/CPLD_SDA: R155.1, U30.132 (IO,(DIFFIO_RX_T22P,DIFFOUT_T22P)); also elsewhere on the board
/CPLD_valve1: U30.78 (IO5_1); also elsewhere on the board
/CPLD_valve2: U30.77 (IO,(DIFFIO_RX_R1N,DIFFOUT_R1N)); also elsewhere on the board
/CPLD_valve3: U30.76 (IO,(DIFFIO_RX_R2N,DIFFOUT_R2N)); also elsewhere on the board
/CPLD_valve4: U30.75 (IO,(DIFFIO_RX_R1P,DIFFOUT_R1P)); also elsewhere on the board
/Comms1: R226.1; also elsewhere on the board
/Comms2: R227.1; also elsewhere on the board
/Comms3: R228.1; also elsewhere on the board
/Comms4: R229.1; also elsewhere on the board
/Comms5: R230.1; also elsewhere on the board
/Comms6: R231.1; also elsewhere on the board
/Enc_A: U30.87 (IO,(DIFFIO_RX_R10N,DIFFOUT_R10N)); also elsewhere on the board
/Enc_B: U30.86 (IO,(DIFFIO_RX_R11N,DIFFOUT_R11N)); also elsewhere on the board
/Enc_Sw: U30.79 (IO,(DIFFIO_RX_R7P,DIFFOUT_R7P)); also elsewhere on the board
/O2_Lim_H_Alarm: U30.11 (IO,ADC1IN5,(DIFFIO_RX_L5N,DIFFOUT_L5N)); also elsewhere on the board
/O2_Lim_L_Alarm: U30.12 (IO,ADC1IN6,(DIFFIO_RX_L5P,DIFFOUT_L5P)); also elsewhere on the board
/Pressure1_Lim_H_Alarm: U30.6 (IO,ADC1IN1,(DIFFIO_RX_L1N,DIFFOUT_L1N)); also elsewhere on the board
/Pressure1_Lim_L_Alarm: U30.7 (IO,ADC1IN2,(DIFFIO_RX_L1P,DIFFOUT_L1P)); also elsewhere on the board
/Pressure2_Lim_H_Alarm: U30.8 (IO,ADC1IN3,(DIFFIO_RX_L3N,DIFFOUT_L3N)); also elsewhere on the board
/Pressure2_Lim_L_Alarm: U30.10 (IO,ADC1IN4,(DIFFIO_RX_L3P,DIFFOUT_L3P)); also elsewhere on the board
/RPi_En: U30.62 (IO4_1); also elsewhere on the board
/RPi_valve1: U30.47 (IO,(DIFFIO_TX_RX_B7P,DIFFOUT_B7P)); also elsewhere on the board
/RPi_valve2: U30.46 (IO,(DIFFIO_TX_RX_B7N,DIFFOUT_B7N)); also elsewhere on the board
/RPi_valve3: U30.45 (IO,(DIFFIO_TX_RX_B5P,DIFFOUT_B5P)); also elsewhere on the board
/RPi_valve4: U30.44 (IO,(DIFFIO_TX_RX_B5N,DIFFOUT_B5N)); also elsewhere on the board
/~Valve1_Fault: U30.119 (IO,(DIFFIO_RX_T10N,DIFFOUT_T10N)); also elsewhere on the board
/~Valve2_Fault: U30.120 (IO,(DIFFIO_RX_T16P,DIFFOUT_T16P)); also elsewhere on the board
/~Valve3_Fault: U30.123 (IO,VREFB8N0); also elsewhere on the board
unnamed: C70.2, R185.1, R186.1, TP43.1, U29.1 (IN), U29.3 (EN)
unnamed: C79.2, R165.1, R166.1, U32.1 (T/T)
unnamed: D44.2 (A), R157.1
unnamed: D45.2 (A), R158.1
unnamed: D47.2 (A), R160.1
unnamed: D48.2 (A), R164.1
unnamed: D49.2 (A), R163.1
unnamed: D50.2 (A), R162.1
unnamed: D51.2 (A), R161.1
unnamed: R131.2, U30.138 (IO,CONF_DONE,(DIFFIO_RX_T24N,DIFFOUT_T2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)
unnamed: R153.1, R154.2, U30.126 (IO,CONFIG_SEL)
unnamed: R159.2, U30.134 (IO,CRC_ERROR,(DIFFIO_RX_T22N,DIFFOUT_T2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)
unnamed: R221.1, U30.121 (IO,DEV_CLRN,(DIFFIO_RX_T16N,DIFFOUT_T16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)
unnamed: R237.2, U30.129 (NCONFIG)
unnamed: TP44.1, U30.14 (IO,ADC1IN8,(DIFFIO_RX_L7P,DIFFOUT_L7P))
unnamed: TP45.1, U30.91 (IO,CLK3N,(DIFFIO_RX_R16N,DIFFOUT_R16N))
unnamed: TP46.1, U30.135 (IO8_1)

Notes on the sheet:
JTAG
Keep <10uF on +3.3V for LP5907 stability
WARNING: RPi_En output only has an effect if onboard 5V supplies are used
100 kHz clock
CPLD can be powered from backup battery when main 5V power is out
Series resistors provide current limiting in case of over-voltage from Raspberry Pi: (5V-3.3V)/1K = 1.7 mA into CPLD GPIO's ESD diodes
High if CRC errors in config. mem.
High when config. is done
Selects config. image 0 (low) or 1 (high)
Global register reset when held low
Rising edge initiates config.
Low during power-on reset and if errors during config.
Overshoot prevention circuit recommended by Max 10 docs

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
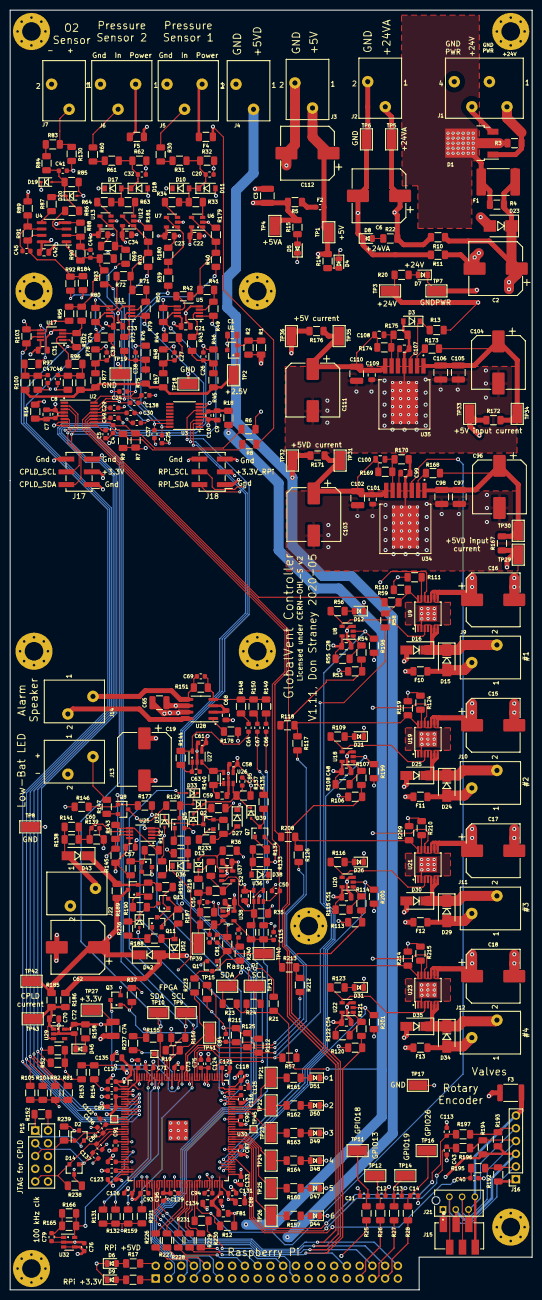
[picture p35: board RPi_cape.kicad_pcb from above]

Board: 4 copper layers, 104.0 x 255.0 mm, 535 parts (1 on the bottom side), 250 nets.
