GlobalVent/electronics/Pressure_sensor_daughterboard-MS5607-MS5803/Pressure_sensor_daughterboard-MS5607-MS5803.kicad_pcb

## KiCad design Pressure_sensor_daughterboard-MS5607-MS5803/Pressure_sensor_daughterboard-MS5607-MS5803.kicad_pcb (2020-07-05)

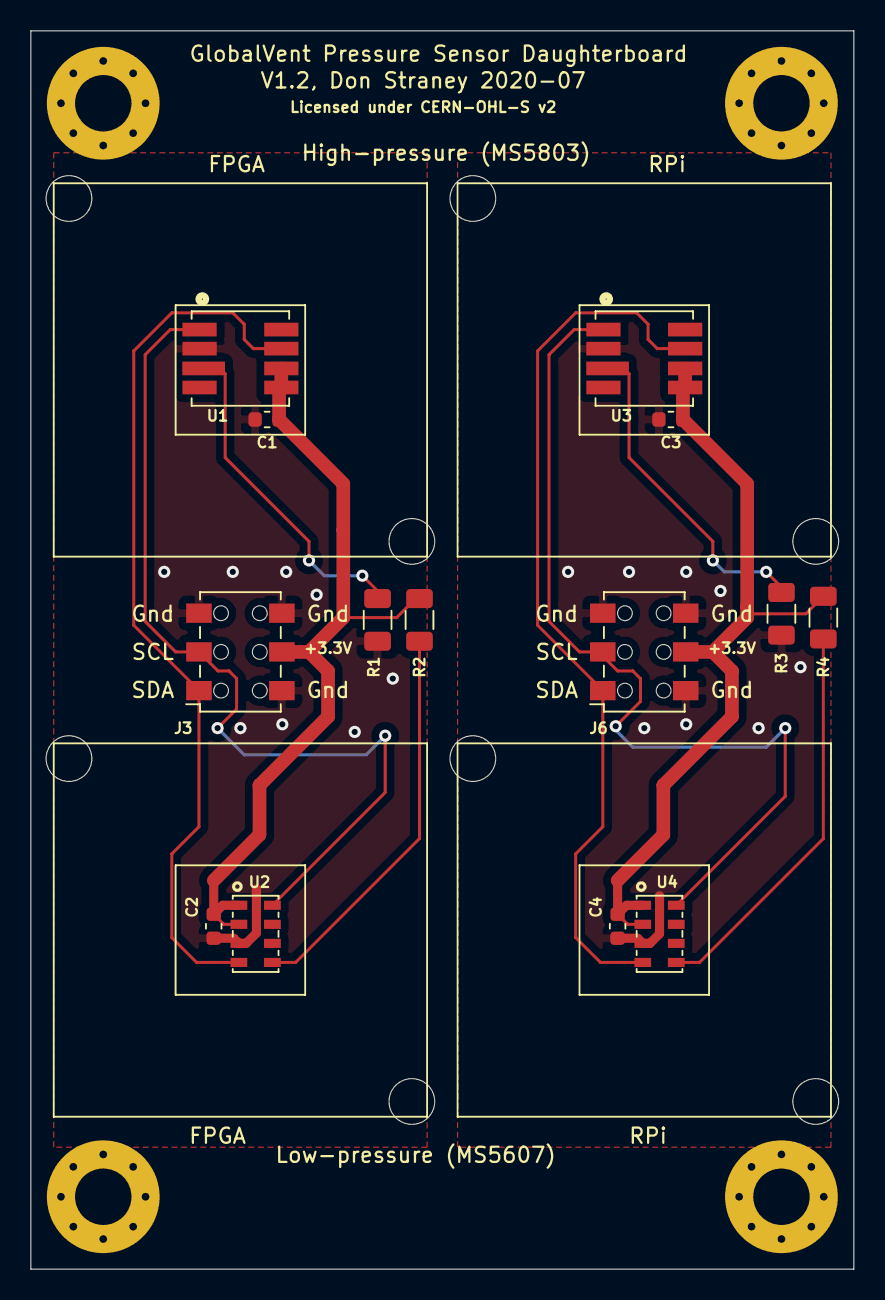
[picture p36: board Pressure_sensor_daughterboard-MS5607-MS5803.kicad_pcb from above]

Board: 2 copper layers, 54.0 x 81.2 mm, 22 parts (0 on the bottom side), 10 nets.

Parts:
C1, C2, C3, C4: 100nF 50V X7R; C_0603_1608Metric
H1, H2, H3, H4: #6; MountingHole_3.7mm_Pad_Via
J1, J2, J4, J5: Pressure_sensor_barb; Sensor_cap_glued_8.5x8.5
J3, J6: Conn_02x03_Odd_Even; Samtec_HLE-103-02-xxx-DV-BE_2x03_P2.54mm_Horizontal
R1, R2, R3, R4: 0; R_1206_3216Metric
U1, U3: MS5803-05BA; TE_MS5803-05BA
U2, U4: MS5607-02BA03; TE_MS5607-02BA03

Connections:
+3V3: C1.2, C2.2, C3.2, C4.2, J3.4, J6.4, R2.1, R4.1, U1.5, U1.6, U2.1, U2.2, U3.5, U3.6, U4.1, U4.2
/Sensors (FPGA)/SCL: J3.3, U1.1, U2.8
/Sensors (FPGA)/SDA: J3.1, U1.7, U2.4
/Sensors (RPi)/SCL: J6.3, U3.1, U4.8
/Sensors (RPi)/SDA: J6.1, U3.7, U4.4
GND: C1.1, C2.1, C3.1, C4.1, J3.2, J3.5, J3.6, J6.2, J6.5, J6.6, R1.2, R3.2, U1.2, U2.3, U3.2, U4.3
unnamed: R1.1, U1.3
unnamed: R2.2, U2.5
unnamed: R3.1, U3.3
unnamed: R4.2, U4.5
