GlobalVent/electronics/RPi_cape_simulator/RPi_cape_simulator.kicad_pcb

## KiCad design RPi_cape_simulator/RPi_cape_simulator.kicad_pcb (2020-06-07)

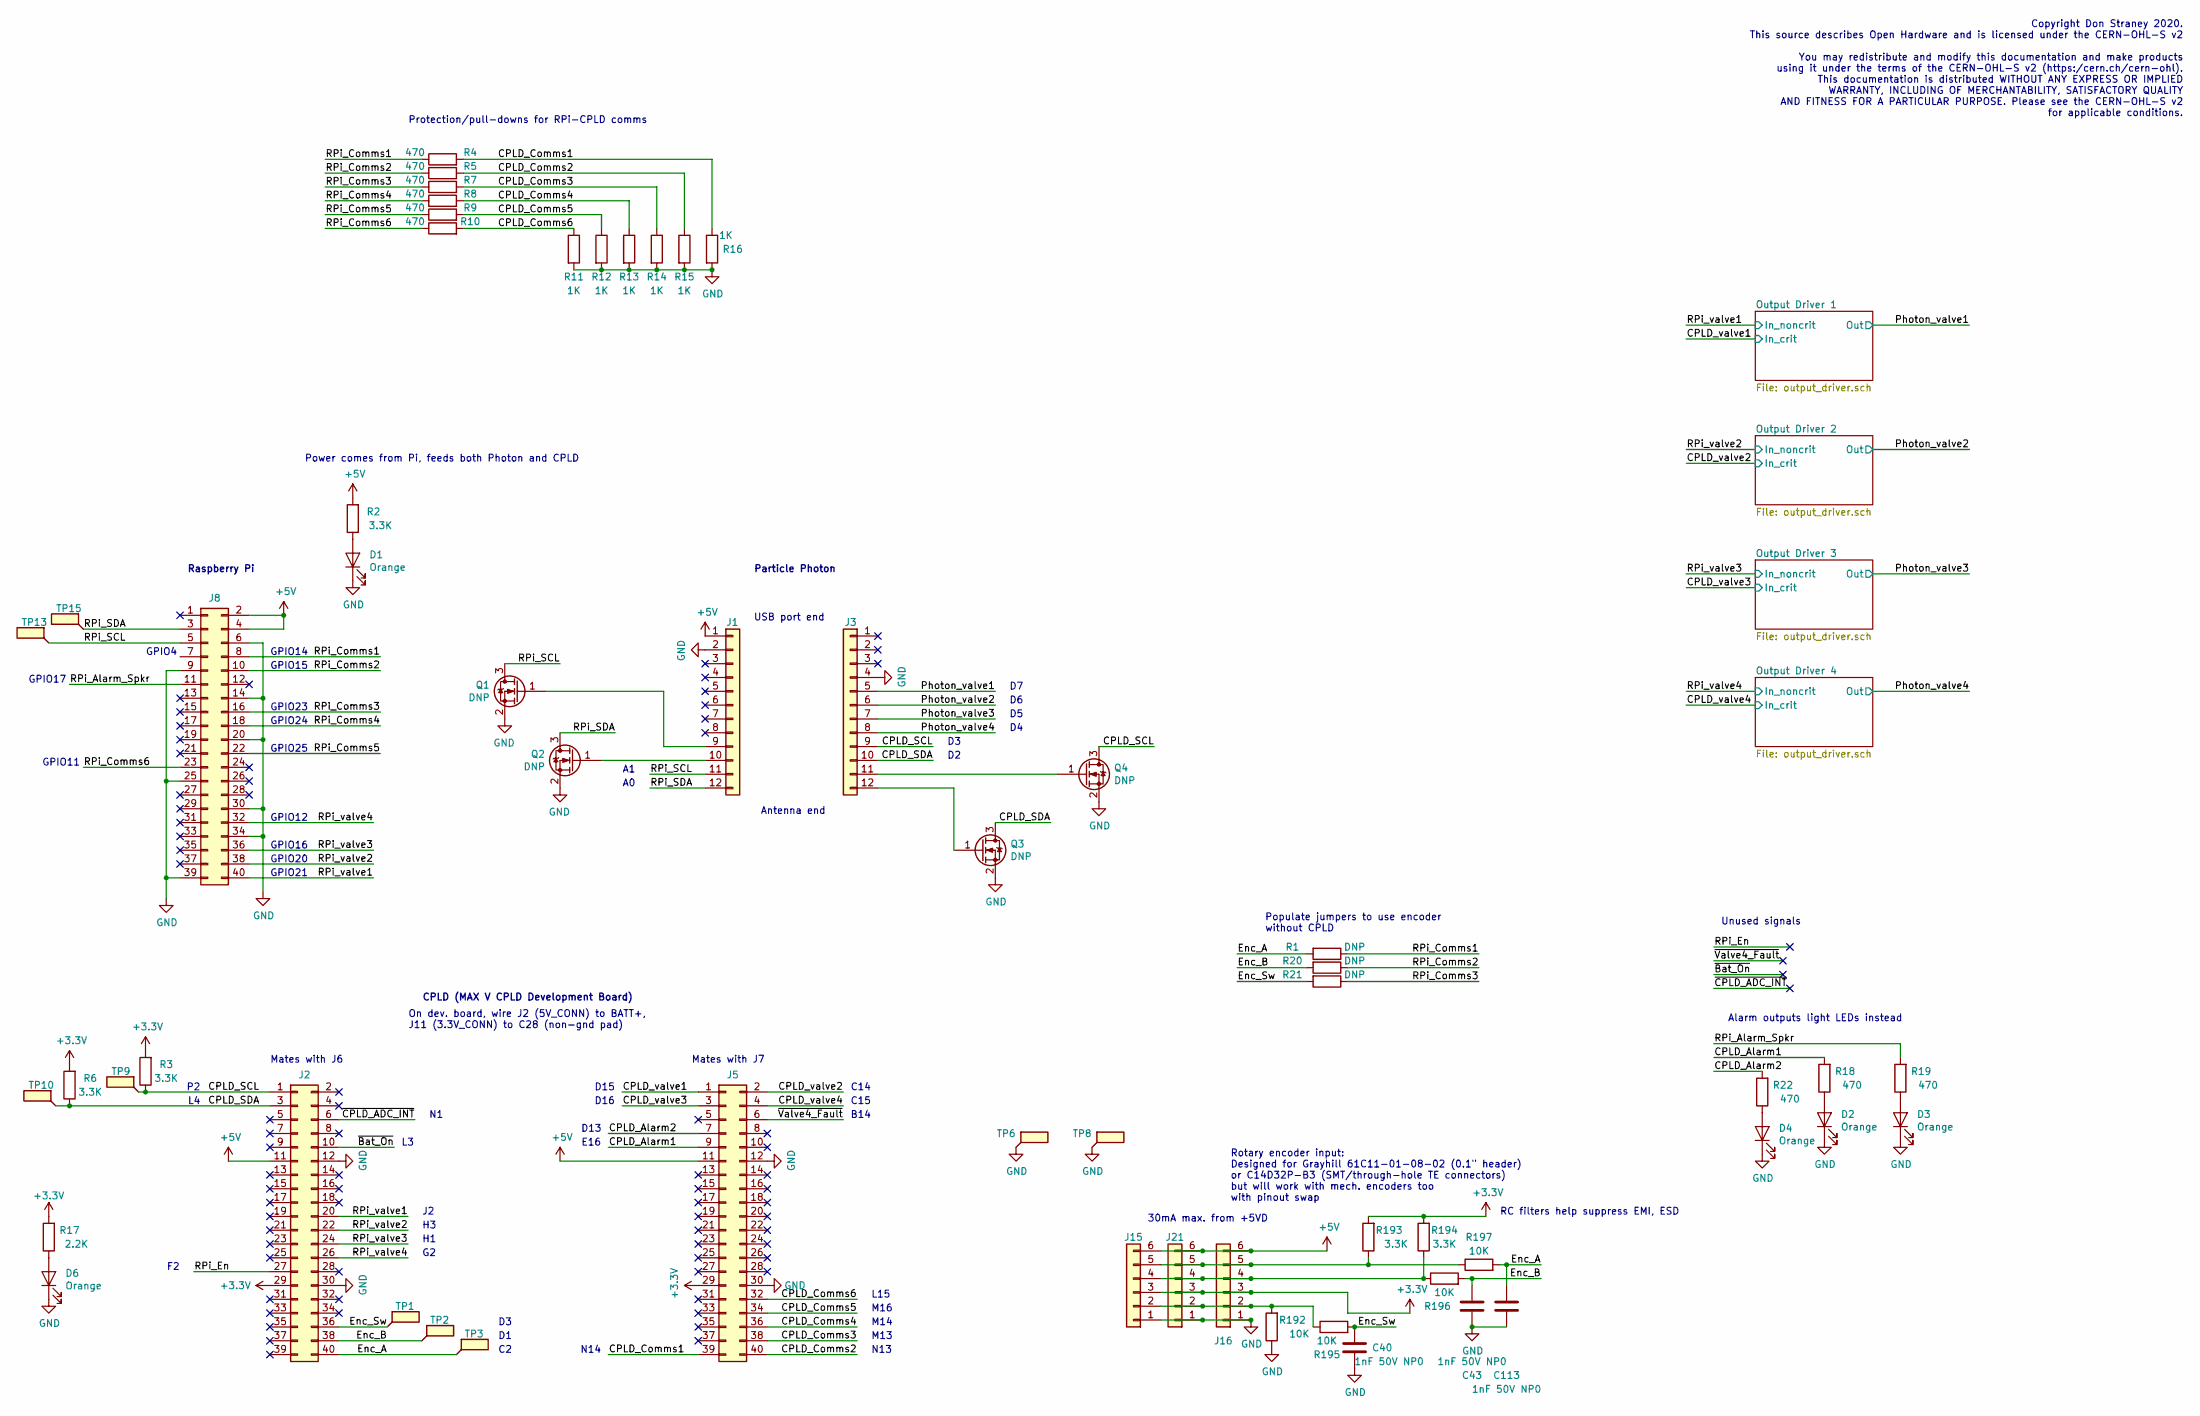
[picture p37: schematic RPi_cape_simulator.sch, GlobalVent Controller: Software Simulator]

Parts:
C40, C43, C113: 1nF 50V NP0; C_0603_1608Metric; Part Number 06035A102JAT2A
D1, D2, D3, D4, D6: Orange; LED_0805_2012Metric; Part Number HSMD-C170
J1, J3: Conn_01x12; PinSocket_1x12_P2.54mm_Vertical
J2, J5, J8: Conn_02x20_Odd_Even; PinSocket_2x20_P2.54mm_Vertical; Part Number PPPC202LFBN-RC
J15: Conn_01x06; TE_188275-6; Part Number 188275-6
J16: Conn_01x06; PinSocket_1x06_P2.54mm_Vertical
J21: Conn_01x06; TE_215079-6; Part Number 215079-6
Q1, Q2, Q3, Q4: DNP; SOT-23_Handsoldering
R1, R20, R21: DNP; R_0805_2012Metric
R2, R3, R6, R193, R194: 3.3K; R_0805_2012Metric
R4, R5, R7, R8, R9, R10, R18, R19, R22: 470; R_0805_2012Metric
R11, R12, R13, R14, R15, R16: 1K; R_0805_2012Metric
R17: 2.2K; R_0805_2012Metric
R192, R195, R196, R197: 10K; R_0805_2012Metric
TP1, TP2, TP3, TP6, TP8, TP9, TP10, TP13, TP15: TestPoint_Flag; TestPoint_Keystone_5019_Minature; Part Number 5019

Connections:
+3V3: J2.29, J5.29, J15.3, J16.3, J21.3, R3.2, R6.2, R17.2, R193.2, R194.2; also elsewhere on the board
+5V: J1.1, J2.11, J5.11, J8.2, J8.4, J15.6, J16.6, J21.6, R2.2
/CPLD_Alarm1: J5.9, R18.2
/CPLD_Alarm2: J5.7, R22.2
/CPLD_Comms1: J5.39, R4.2, R16.1
/CPLD_Comms2: J5.40, R5.2, R15.1
/CPLD_Comms3: J5.38, R7.2, R14.1
/CPLD_Comms4: J5.36, R8.2, R13.1
/CPLD_Comms5: J5.34, R9.2, R12.1
/CPLD_Comms6: J5.32, R10.2, R11.1
/CPLD_SCL: J2.1, J3.9, Q4.3 (D), R3.1, TP9.1
/CPLD_SDA: J2.3, J3.10, Q3.3 (D), R6.1, TP10.1
/CPLD_valve1: J5.1; also elsewhere on the board
/CPLD_valve2: J5.2; also elsewhere on the board
/CPLD_valve3: J5.3; also elsewhere on the board
/CPLD_valve4: J5.4; also elsewhere on the board
/Enc_A: C113.2, J2.40, R1.2, R197.2, TP3.1
/Enc_B: C43.2, J2.38, R20.2, R196.2, TP2.1
/Enc_Sw: C40.2, J2.36, R21.2, R195.2, TP1.1
/Photon_valve1: J3.5; also elsewhere on the board
/Photon_valve2: J3.6; also elsewhere on the board
/Photon_valve3: J3.7; also elsewhere on the board
/Photon_valve4: J3.8; also elsewhere on the board
/RPi_Alarm_Spkr: J8.11, R19.2
/RPi_Comms1: J8.8, R1.1, R4.1
/RPi_Comms2: J8.10, R5.1, R20.1
/RPi_Comms3: J8.16, R7.1, R21.1
/RPi_Comms4: J8.18, R8.1
/RPi_Comms5: J8.22, R9.1
/RPi_Comms6: J8.23, R10.1
/RPi_En: J2.27
/RPi_SCL: J1.11, J8.5, Q1.3 (D), TP13.1
/RPi_SDA: J1.12, J8.3, Q2.3 (D), TP15.1
/RPi_valve1: J2.20, J8.40; also elsewhere on the board
/RPi_valve2: J2.22, J8.38; also elsewhere on the board
/RPi_valve3: J2.24, J8.36; also elsewhere on the board
/RPi_valve4: J2.26, J8.32; also elsewhere on the board
/~Bat_On: J2.10
/~CPLD_ADC_INT: J2.6
/~Valve4_Fault: J5.6
GND: C40.1, C43.1, C113.1, D1.1 (K), D2.1 (K), D3.1 (K), D4.1 (K), D6.1 (K), J1.2, J2.12, J2.30, J3.4, J5.12, J5.30, J8.6, J8.9, J8.14, J8.20, J8.25, J8.30, J8.34, J8.39, J15.1, J16.1, J21.1, Q1.2 (S), Q2.2 (S), Q3.2 (S), Q4.2 (S), R11.2, R12.2, R13.2, R14.2, R15.2, R16.2, R192.1, TP6.1, TP8.1; also elsewhere on the board
unnamed: D1.2 (A), R2.1
unnamed: D2.2 (A), R18.1
unnamed: D3.2 (A), R19.1
unnamed: D4.2 (A), R22.1
unnamed: D6.2 (A), R17.1
unnamed: J1.9, Q1.1 (G)
unnamed: J1.10, Q2.1 (G)
unnamed: J3.11, Q4.1 (G)
unnamed: J3.12, Q3.1 (G)
unnamed: J15.2, J16.2, J21.2, R192.2, R195.1
unnamed: J15.4, J16.4, J21.4, R194.1, R196.1
unnamed: J15.5, J16.5, J21.5, R193.1, R197.1

Notes on the sheet:
GPIO17
GPIO24
GPIO23
GPIO25
GPIO11
Rotary encoder input: Designed for Grayhill 61C11-01-08-02 (0.1" header) or C14D32P-B3 (SMT/through-hole TE connectors) but will work with mech. encoders too with pinout swap
GPIO16
GPIO20
GPIO21
RC filters help suppress EMI, ESD
30mA max. from +5VD
GPIO12
GPIO14
GPIO15
CPLD (MAX V CPLD Development Board)
Mates with J6
Mates with J7
On dev. board, wire J2 (5V_CONN) to BATT+, J11 (3.3V_CONN) to C28 (non-gnd pad)
B14
E16
Copyright Don Straney 2020. This source describes Open Hardware and is licensed under the CERN-OHL-S v2 You may redistribute and modify this documentation and make products using it under the terms of the CERN-OHL-S v2 (https:/cern.ch/cern-ohl). This documentation is distributed WITHOUT ANY EXPRESS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
GPIO4
Raspberry Pi
Particle Photon
USB port end
Antenna end
Power comes from Pi, feeds both Photon and CPLD
Unused signals
Alarm outputs light LEDs instead
Protection/pull-downs for RPi-CPLD comms
L15
M16
M14
M13
N13
N14
D15
C14
D16
C15
Populate jumpers to use encoder without CPLD
D13

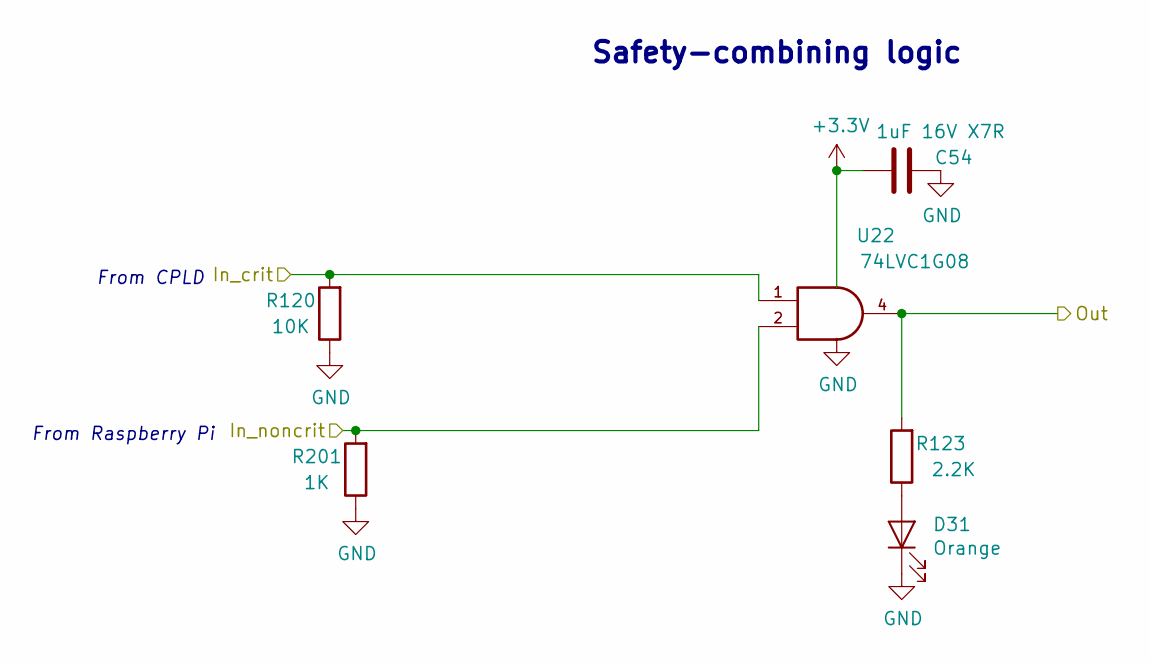
[picture p38: schematic output_driver.sch, GlobalVent Stand-Alone Controller]

Parts:
C28: 1uF 16V X7R; C_0805_2012Metric; Part Number C0805C105K4RACTU
D12: Orange; LED_0805_2012Metric; Part Number HSMD-C170
R53: 10K; R_0805_2012Metric
R56: 2.2K; R_0805_2012Metric
R198: 1K; R_0805_2012Metric
U8: 74LVC1G08; SOT-23-5; Part Number SN74LVC1G08DBVR

Connections:
+3V3: C28.2, U8.5 (VCC); also elsewhere on the board
/CPLD_valve1: R53.2, U8.1; also elsewhere on the board
/Photon_valve1: R56.2, U8.4; also elsewhere on the board
/RPi_valve1: R198.2, U8.2; also elsewhere on the board
GND: C28.1, D12.1 (K), R53.1, R198.1, U8.3 (GND); also elsewhere on the board
unnamed: D12.2 (A), R56.1

Parts of its further copies:
C48, C51, C54: 1uF 16V X7R; C_0805_2012Metric; Part Number C0805C105K4RACTU
D21, D26, D31: Orange; LED_0805_2012Metric; Part Number HSMD-C170
R106, R113, R120: 10K; R_0805_2012Metric
R109, R116, R123: 2.2K; R_0805_2012Metric
R199, R200, R201: 1K; R_0805_2012Metric
U18, U20, U22: 74LVC1G08; SOT-23-5; Part Number SN74LVC1G08DBVR

Connections of its further copies:
+3V3: C48.2, C51.2, C54.2, U18.5 (VCC), U20.5 (VCC), U22.5 (VCC); also elsewhere on the board
/CPLD_valve2: R106.2, U18.1; also elsewhere on the board
/CPLD_valve3: R113.2, U20.1; also elsewhere on the board
/CPLD_valve4: R120.2, U22.1; also elsewhere on the board
/Photon_valve2: R109.2, U18.4; also elsewhere on the board
/Photon_valve3: R116.2, U20.4; also elsewhere on the board
/Photon_valve4: R123.2, U22.4; also elsewhere on the board
/RPi_valve2: R199.2, U18.2; also elsewhere on the board
/RPi_valve3: R200.2, U20.2; also elsewhere on the board
/RPi_valve4: R201.2, U22.2; also elsewhere on the board
GND: C48.1, C51.1, C54.1, D21.1 (K), D26.1 (K), D31.1 (K), R106.1, R113.1, R120.1, R199.1, R200.1, R201.1, U18.3 (GND), U20.3 (GND), U22.3 (GND); also elsewhere on the board
unnamed: D21.2 (A), R109.1
unnamed: D26.2 (A), R116.1
unnamed: D31.2 (A), R123.1

Notes on the sheet:
From Raspberry Pi
From CPLD
Safety-combining logic

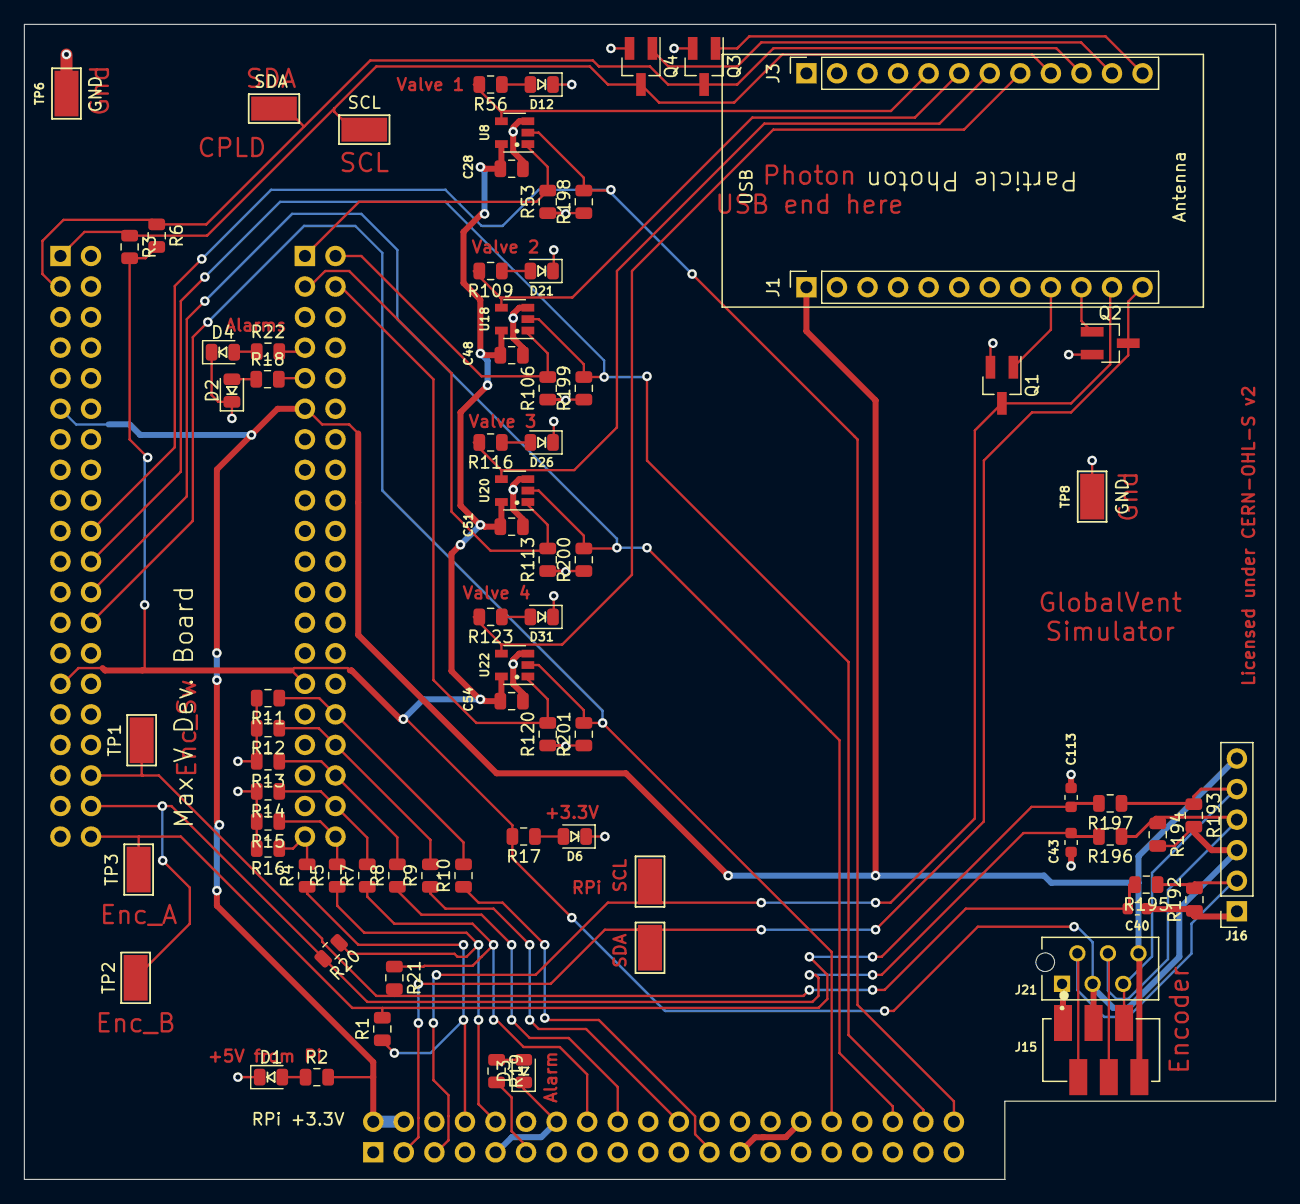
[picture p39: board RPi_cape_simulator.kicad_pcb from above]

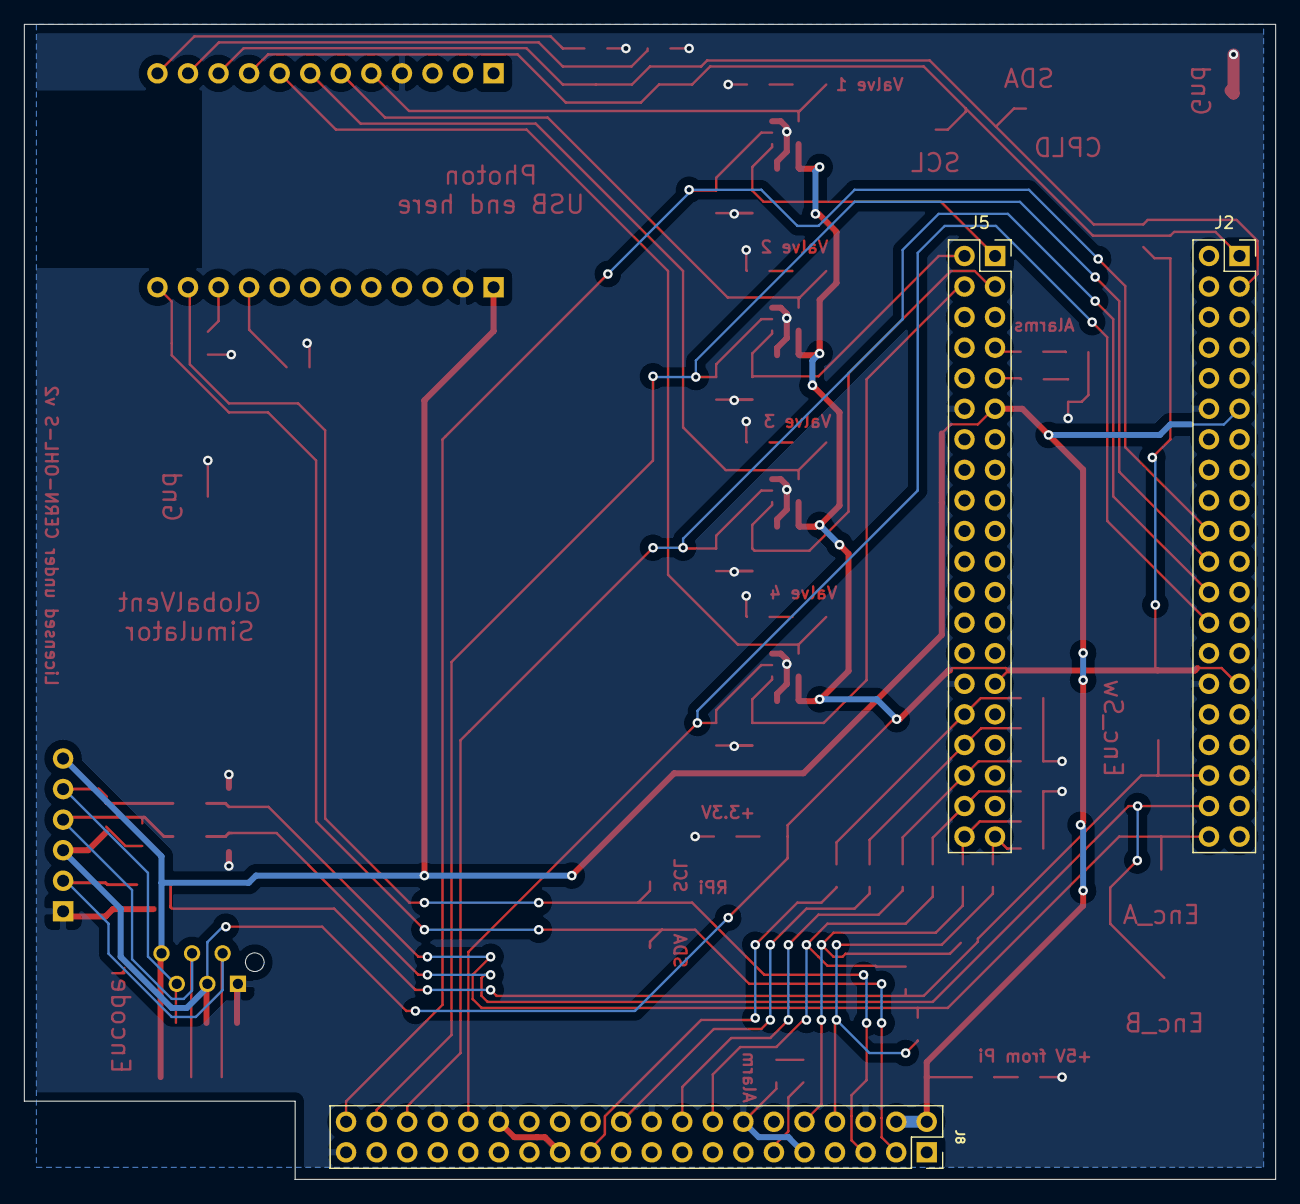
[picture p40: board RPi_cape_simulator.kicad_pcb from below]

Board: 2 copper layers, 104.0 x 96.0 mm, 81 parts (3 on the bottom side), 53 nets.
