GlobalVent/electronics/(commit log)

2020-04-08 Initial creation
    [5V_reg.sch, RPi_cape.kicad_pcb, RPi_cape.sch, audio_alarm.sch, output_driver.sch, sensor_input.sch, sensor_input_lowlevel.sch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]
2020-04-08 Extra info, post-design-review fixes
    Added extra info on existing alternate circuit options
    Added extra info on parts selection
    Created initial PCB file
    Added bulk cap to +5V input
    Design review fixes:
    Moved Raspberry Pi PWM output to GPIO18 to take advantage of hardware PWM
    Fixed floating shutdown input on audio amp
    Added series resistor R177 to allow low battery output to signal to both CPLD and external LED at the same time
    [5V_reg.sch, RPi_cape.kicad_pcb, RPi_cape.sch, audio_alarm.sch, output_driver.sch, sensor_input.sch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]
2020-04-10 Finished schematic, most of PCB placement
    Added error budget for analog inputs
    Finished most of PCB placement and started routing
    Added R185, R186 to allow powering CPLD from alarm power for better power-down alarm sound flexibility
    Changed power-down alarm monitoring from +5VD to +3.3V, and put +5VA and +24VA monitoring as DNP by default, to match the CPLD's ability to run off backup battery and monitor +5VA/+24VA
    Moved from 3x AA (4.5V) to 4x AA (6V) alarm battery for better audio voltage, and added PNP diode-ORing circuit (Q12 etc.) to accomodate higher voltage, changed low-battery threshold to 5V
    Added pull-down resistors to sensor op-amp outputs to help extend low-end output range
    Chang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
    [RPi_cape.sch, audio_alarm.sch, sensor_input.sch, sensor_input_lowlevel.sch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]
2020-04-12 Finished layout, minor design changes
    Assigned CPLD pins
    Finished routing PCB
    Moved rotary encoder inputs to CPLD
    Removed separate decoupling caps for smaller CPLD footprint due to routing constraints
    Added pull-downs on CPLD inputs for each valve driver (R198 etc.)
    [5V_reg.sch, RPi_cape.kicad_pcb, RPi_cape.sch, output_driver.sch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]
2020-04-13 Digital pressure sensors
    Added two digital pressure sensors each, on Raspberry Pi and CPLD I2C busses; preliminary layout only until mechanical details are finalized
    Added gnd plane on bottom layer for heatsinking 5V regulators
    [5V_reg.sch, RPi_cape.kicad_pcb, RPi_cape.sch, audio_alarm.sch, output_driver.sch, pressure_sensors_dig.sch, sensor_input.sch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]
2020-04-16 Better valve monitoring, finalized layout and manufacturing files
    Created assembly and fabrication drawings, assigned all BOM parts, generally made design ready for ordering
    Added strain-relief slots and barb mounting dimensions for digital pressure sensors
    Changed valve drivers from discrete power MOSFETs to "smart" industrial/automotive driver ICs for the current monitoring, including valve-movement monitor for #4
    Connected RPi_Valve* signals to larger CPLD footprint, changed Raspberry Pi pin assignment as a result to ease PCB routing
    Updated footprints, page layout to create readable assembly drawing
    Added current-measurement testpoints for CPLD power from BATT+
    Changed power diodes in po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
    [5V_reg.sch, BOM.xls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]
2020-04-17 Manufacturing clean-up
    Corrections and additions to BOM etc. for manufacturing
    Added power draw tracking spreadsheet
    [0 power.xls, BOM.xls, RPi_cape.sch, audio_alarm.sch, output_driver.sch, sensor_input.sch, sensor_input_lowlevel.sch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]
2020-04-19 Better docs, failure mode/protection summary
    Created list of protection features / failure modes + function bring-up plan
    Added more alternate parts for Pi connector
    Added candidate parts for other headers, fans, and speakers
    [0 protection overview.ods]
2020-04-19 Failure mode clarification
    Clarified indirect ability to sense low 24V input by observing valve currents lower than expected/nominal
    [0 protection overview.ods]
2020-04-19 Added missing cases
    Added missing "short on downstream analog" rails cases, where +5VA or sensor-+24VA shorts would trip fuses without triggering noticeable upstream faults
    [0 protection overview.ods]
2020-04-19 Failure mode corrections
    [0 protection overview.ods]
2020-04-19 Safety additions
    Switched CPLD_ADC7 to +24V monitoring (from +5V monitoring), and added CPLD ~Bat_On digital input(s) to know when it's running from backup battery, to cover low-input-voltage edge cases
    Added series 1K resistors (R226-231) on CPLD<->RPi Comms1-6 lines, to protect CPLD in case of overvoltage from RPi failure
    Added optional input TVS D23 to handle sustained over-voltage or large surges
    [0 protection overview.ods, 5V_reg.sch, BOM.xls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]
2020-04-19 Cleanup, docs
    [BOM for costing.xls, RPi_cape.sch, output_driver.sch]
2020-04-19 Docs cleanup
    [5V_reg.sch, BOM for costing.xls, BOM.xls, RPi_cape.sch, audio_alarm.sch]
2020-04-20 +5VA outage detection
    Separated +1.8V and +5VA monitoring and added +3.3V output for +5VA on ~5VA_On signal to CPLD, to cover an extra failure mode
    [0 protection overview.ods, BOM for costing.xls, BOM.xls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]
2020-04-21 Documentation updates
    Changed organization to "US JamVent Team" on all drawings
    Put BOM in better format for picky automated-BOM scripts (Sierra Circuits) that can't handle space or newline separators in refdes list
    Marked TE pressure sensors as DNP on BOM, for manual soldering to avoid damage from cleaning and automated processes
    Adjusted bom.ini to leave out the pressure-sensor-barb fittings (mechanical only)
    [5V_reg.sch, BOM for costing.xls, BOM.xls, RPi_cape.kicad_pcb, RPi_cape.sch, audio_alarm.sch, output_driver.sch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]
2020-04-22 "Final" manufacturing zip file
    Fixed previous forgetfullness in adding updated fab/assembly drawings and BOM to "final" manufacturing zip file
2020-04-22 Zip cleanup
    Removed costing BOM accidentally added to zip file
2020-04-22 Footprint corrections, software docs
    Added pinout and I2C description for software devs
    Changed erroneously-"through hole"-marked SnapEDA footprints to SMT, so no longer missing from pick-and-place centroid file
    [0 pinouts for software.ods, RPi_cape.kicad_pcb, sensor_input.sch]
2020-04-24 Analog upgrades and extra encoder connectors
    Renamed a few files
    Removed "costing BOM" as difficult to keep up to date, easy to regenerate
    Toughened under-voltage detect circuits by adding hysteresis to +5V detect for +BATT diode-OR (R236), filtering to power-down alarm detect input (C85)
    Added connector options (J15, J21) for Grayhill C14-series rotary encoder with cable
    Changed R190 from 3K to 2.4K to increase overhead on base current required for saturation, and consolidate BOM
    Added 3 solderable testpoints for expanding CPLD pin options (TP44-46), adjusted some CPLD pin assignments to allow physical routing to pins
    Fixed valve motion detector by changing comparator's hysteresis to AC-onl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
    [0 pinouts for software.ods, 0 protection and bringup.ods, 0 protection overview.ods, 5V_reg.sch, BOM for costing.xls, BOM.xls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]
2020-04-28 Added Pin spreadsheet with simulation info
    [0 pinouts for software AC.ods]
2020-05-13 Initial add of "Quick and Dirty Prototype" 2-layer
    [RPi_cape_proto-B_Cu.gbr, RPi_cape_proto-B_Mask.gbr, RPi_cape_proto-B_SilkS.gbr, RPi_cape_proto-Edge_Cuts.gbr, RPi_cape_proto-F_Cu.gbr, RPi_cape_proto-F_Mask.gbr, RPi_cape_proto-F_SilkS.gbr, RPi_cape_proto-NPTH.drl]
2020-05-13 Fixed BOM
    Added missing dual-diode part number
    [RPi_cape_proto_bom.xls, RPi_cape_proto_bom_digikey.xls]
2020-05-13 Updates based on testing, extra documentation
    Added thermal calculations, possible thermal-induced problems to fault-condition list
    Renamed error calculations file
    Added some bringup tests
    Changed 24V LED resistors (R20, R22) to 24.9K to consolidate BOM
    Adjusted audio amp volume and filtering according to breadboard experiments
    Moved bottom-end mounting holes and encoder connectors to avoid interfering mechanically with Raspberry Pi
    Replaced under-sized power-ORing diodes with better Schottky option, added heatsinking with copper planes
    Improved LMZ14203 heatsinking by removing thermal reliefs, re-arranging input-current-measurement testpoints to increase top-layer copper area
    [0 power.xls, 0 protection and bringup.ods, 5V_reg.sch, BOM.xls, RPi_cape.kicad_pcb, RPi_cape.sch, audio_alarm.sch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]
2020-05-13 Input ORing-diode details
    Changed part number and improved heatsinking for input power OR-ing diode
    [RPi_cape_proto-B_Cu.gbr, RPi_cape_proto-B_Mask.gbr, RPi_cape_proto-B_SilkS.gbr, RPi_cape_proto-Edge_Cuts.gbr, RPi_cape_proto-F_Cu.gbr, RPi_cape_proto-F_Mask.gbr, RPi_cape_proto-F_SilkS.gbr, RPi_cape_proto-NPTH.drl]
2020-05-14 Cleanup, manufacturing
    Added doc on differences between 'proto' version and 'full' version
    Added manufacturing README in proto version
    Removed unused hardwired-limited O2 alarm nets in proto version
    Fixed missed-annotation on D1 in full version
    [5V_reg.sch, RPi_cape.sch, RPi_cape_proto.sch, output_driver.sch]
2020-05-27 Admin (naming, license), improvements based on testing
    Updated name on schematic, PCB silkscreen
    Added 3 mounting holes on inside area of board for better mechanical robustness
    Removed extra unused pressure sensor barb packages from library
    Fixed Phoenix spring connector footprints, and added 3D models from Phoenix website
    Added 3D models to TE encoder connector footprints, QFP-100 for CPLD, and 5019 testpoint
    Changed DIAG_EN pin connection from valve drivers from +24V (too high) to +3.3V
    Added CERN licensing terms
    [5V_reg.sch, RPi_cape.kicad_pcb, RPi_cape.sch, audio_alarm.sch, output_driver.sch, pressure_sensors_dig.sch, sensor_input.sch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]
2020-05-27 Admin (licensing, naming)
    Put under CERN open hardware license
    Changed name to GlobalVent
    [RPi_cape_proto.kicad_pcb, RPi_cape_proto.sch, audio_alarm.sch, output_driver.sch, sensor_input_lowlevel.sch, valve_detect.sch]
2020-06-07 Created simulator board
    Created simulator board to connect Pi, CPLD dev board, and Photon-as-software-simulator
    [RPi_cape_simulator.kicad_pcb, RPi_cape_simulator.sch, output_driver.sch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]
2020-06-12 Misc small updates
    Updated non-precision op-amp list to work with valve-motion-detect circuit's peak detector (needs low bias current)
    Created 3D model for "quick and dirty" prototype board
    Added rework on simulator for Photon pinout
    [RPi_cape_simulator.sch]
2020-07-05 Design update based on changed software/firmware/pneumatics reqs
    Swapped Max V CPLD for Max 10 FPGA
    Removed +1.8V regulator and monitoring (in power-down alarm) because Max 10 FPGA has internal regulator
    Changed FPGA's valve-enable pull-downs from 1K to 10K because Max 10 floats the outputs during power-up/programming (instead of Max V's internal pull-ups)
    Changed low-pressure sensor from BMP388 to MS5607 for more manufacturable footprint / high availability, and moved all digital pressure sensors to daughterboard for repairability
    Changed single op-amps in analog pressure sensor inputs / valve motion detect circuits to TLV6001 for better bias current, correct footprint
    Removed excessive DNP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
    [0 pinouts for software AC.ods, 0 pinouts for software.ods, 5V_reg.sch, BOM.xls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]
2020-07-05 Initial
    Created separate pressure sensor daughterboard
    [HLE-103-02-L-DV-BE-K-TR.stp, Pressure_sensor_daughterboard-MS5607-MS5803.kicad_pcb, Pressure_sensor_daughterboard-MS5607-MS5803.sch, Pressure_sensor_daughterboard-MS5607-MS5803.step, sensor_set.sch]
2020-07-05 Removed 3d component models
    [HLE-103-02-L-DV-BE-K-TR.stp, sensor_set.sch]
2020-07-05 Created/updated manufacturing files
    Created new manufacturing files for pressure sensor daughterboard
    Updated stats w/corrected numbers (based on extra counts for non-plated holes, vias in mounting hole rings) for main board
    Created schematic PDF for pressure sensor daughterboard
    Updated schematic version for pressure sensor daughterboard
    [BOM.xls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]
2020-07-06 3D updates
    Removed extra files that shouldn't be in repo
    Associated QFP footprint with 3D model
    [Pressure_sensor_daughterboard-MS5607-MS5803.step, RPi_cape.kicad_pcb]
2020-08-31 3D models, parts
    Added 3D model for LMZ14203
    Added parts options for daughterboard connection
    [RPi_cape.kicad_pcb]
2020-09-01 Added add'l parts selection lists
    Added FPGA, CPU, display selection lists
    [0 parts, display options.ods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]
